Iwetter/EEG32/prefab-20261001/EEG32-2.1-schematics.pdf

1 | 2 | 3 | 4 | 5 | 6 | 7 | 8

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
### F Date: 2026-10-01

KiCad E.D.A. 10.0.5 | Id: 1/9
Size: A3 | Rev: 2.1-prefab-bench

## Title: EEG32 passive | system overview

### File: EEG32.kicad_sch

### Sheet: /

### Passive bench prototype | protection and footprint release review pending

## ADS1299 #2 / U201

CH09-CH16 / AFE2.kicad_sch

Shared clock / START Clock + BIAS master | nRF52832 / BLE
Four CS / DOUT / DRDY groups Shared SCLK / MOSI / START Latest MCU pin assignments kept BLE RF network retained MCU.kicad_sch P2: VBAT U2: +3V3 digital U3: +5VA analog Common GND, four-layer PCB

Power.kicad_sch CH25-CH32 / AFE4.kicad_sch

# EEG32 / PASSIVE WEARABLE ACQUISITION

### 32 simultaneous channels | shared REF + separate BIAS | 500 SPS/channel target

## PASSIVE ELECTRODES

32 signals + REF + BIAS One physical electrode harness

J601 / 40-contact low-profile FFC

4.99k / 4.7nF input filters No electrode power or buffers PassiveInputs.kicad_sch

## ADS1299 #3 / U301

# CH17-CH24 / AFE3.kicad_sch CH01-CH08 / AFE1.kicad_sch

Shared clock / START ADS1299 #4 / U401

Shared clock / START

## ADS1299 #1 / U101

## REF / BIAS

REF -> RC -> four SRB1 pins U101 BIAS -> R634 -> electrode REF and BIAS remain separate.

ReferenceBias.kicad_sch

Arrows show functional signal flow; named nets make electrical connections. Physical cable terminates at J601. Active hub and electrode-module projects are archived reference designs, outside this passive assembly. ROUTED BENCH CHECKPOINT: manufacturing, measured performance and human-contact safety remain release gates.

## POWER

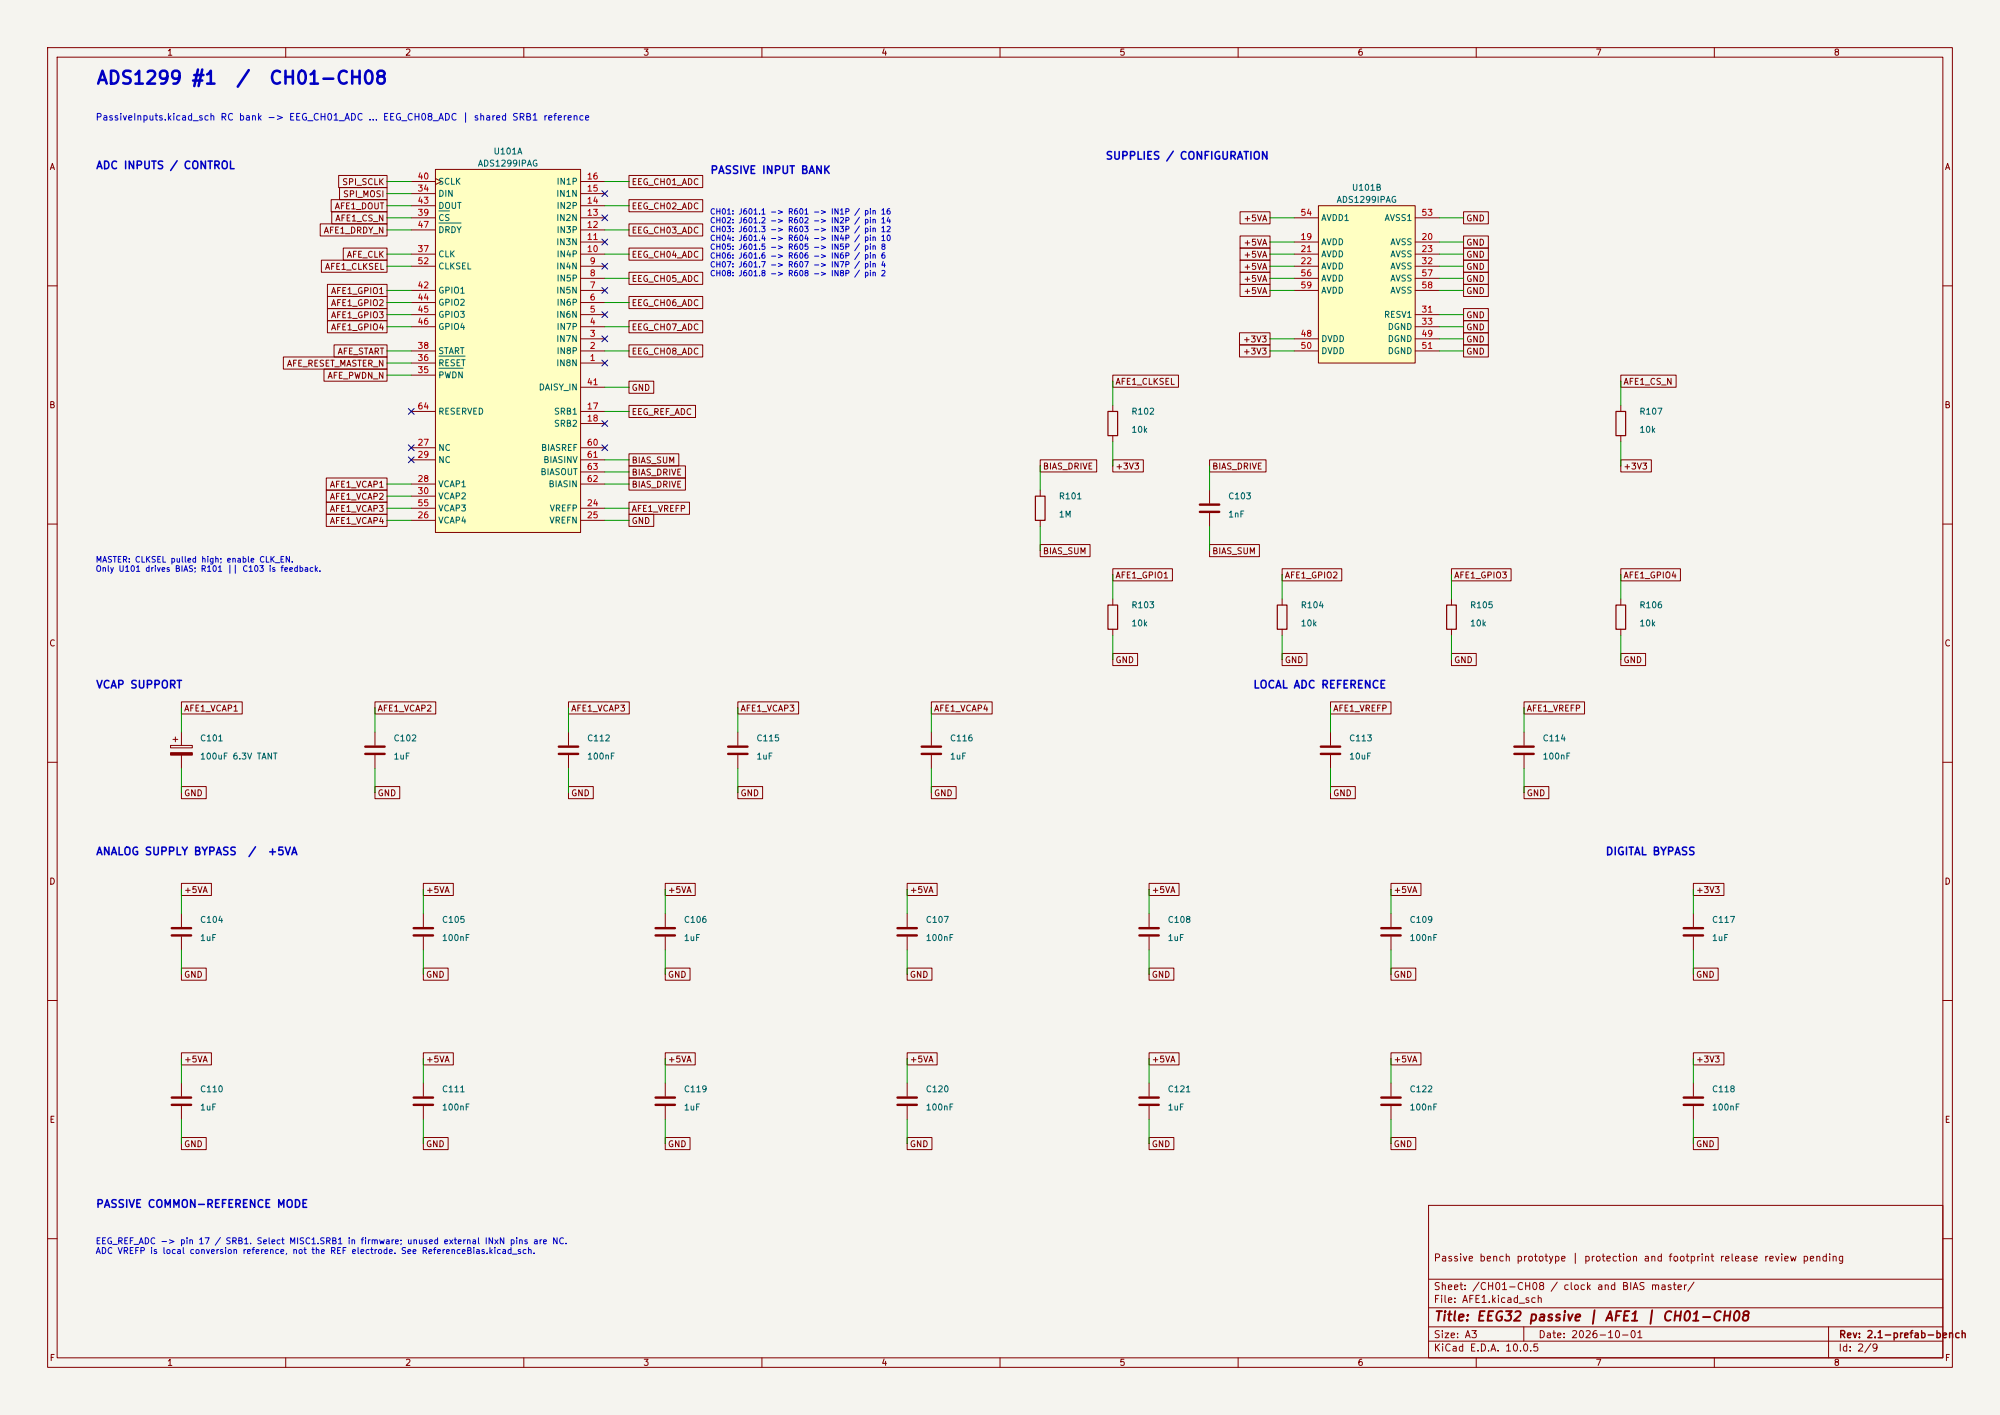
[picture p1: page 2]

MASTER: CLKSEL pulled high; enable CLK_EN. Only U101 drives BIAS; R101 || C103 is feedback. VCAP SUPPORT

EEG_REF_ADC -> pin 17 / SRB1. Select MISC1.SRB1 in firmware; unused external INxN pins are NC. ADC VREFP is local conversion reference, not the REF electrode. See ReferenceBias.kicad_sch. ANALOG SUPPLY BYPASS / +5VA

PASSIVE COMMON-REFERENCE MODE

Passive bench prototype | protection and footprint release review pending

Sheet: /CH01-CH08 / clock and BIAS master/
File: AFE1.kicad_sch
Title: EEG32 passive | AFE1 | CH01-CH08

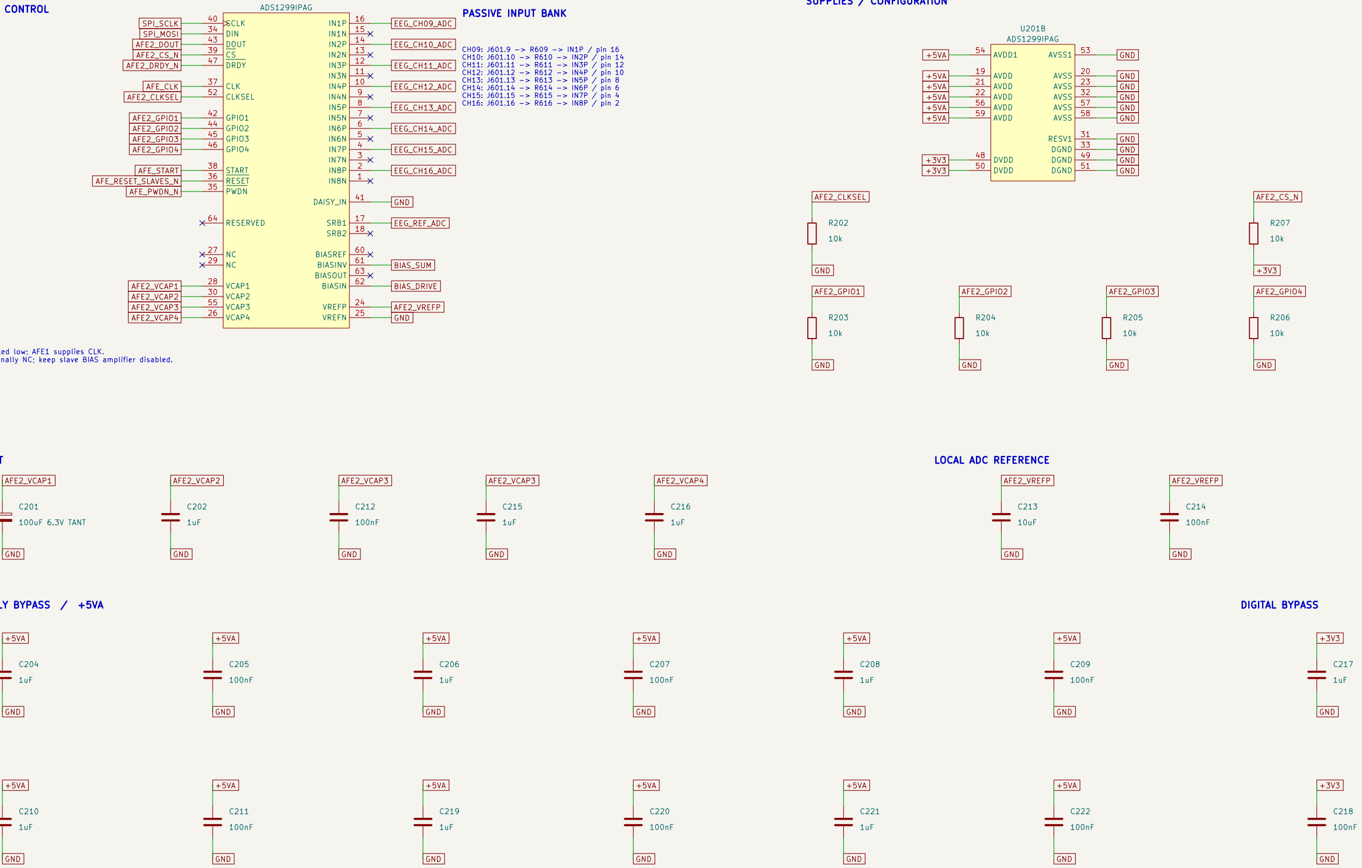
[picture p2: figure]
SRB1; SRB2; VREFP; VREFN; 25 VCAP4 26; VCAP1 28; VCAP2 30; DIN 34; PWDN 35; RESET 36; CLK 37; START 38; SCLK 40; DAISY_IN; 41 GPIO1 42; DOUT 43; GPIO2 44; GPIO3 45; GPIO4 46; DRDY 47; CLKSEL 52; ADS1299IPAG; AVDD 19; AVSS; AVDD 21; AVDD 22; 23 RESV1; 32 DGND; 33 DVDD 48; DGND; 49 DVDD 50; AVSS1; 53 AVDD1 54; AVDD 56; 58 AVDD 59; 100uF 6.3V TANT; 10k GND; GND; AFE2_VCAP2GND +5VA GND +5VA GND; +5VA GND +5VA; AFE2_VREFP; +5VA BIAS_DRIVE; EEG_REF_ADC; BIAS_SUM; GND +5VA; AFE2_VCAP4; AFE2_VCAP1 AFE2_VCAP2 AFE2_VCAP3; AFE2_CLKSEL; GND +3V3 GND; AFE2_VCAP4 +5VA; +5VA GND; AFE2_VCAP3; GND GND +5VA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
## Title: EEG32 passive | AFE2 | CH09-CH16

### File: AFE2.kicad_sch

### Sheet: /CH09-CH16 / synchronous AFE/

### Passive bench prototype | protection and footprint release review pending

IN4P | 10 IN3N | 11 IN3P | 12 IN2N | 13 IN2P | 14 IN1N | 15 IN1P | 16
VCAP3 55 | BIASREF | 60 BIASINV | 61 BIASIN | 62 BIASOUT | 63 RESERVED 64 | U201A
AFE2_VCAP1 | +3V3 ANALOG SUPPLY BYPASS / +5VA

SLAVE: CLKSEL pulled low; AFE1 supplies CLK. BIASOUT is intentionally NC; keep slave BIAS amplifier disabled. VCAP SUPPORT

# ADS1299 #2 / CH09-CH16

PassiveInputs.kicad_sch RC bank -> EEG_CH09_ADC ... EEG_CH16_ADC | shared SRB1 reference ADC INPUTS / CONTROL

### SUPPLIES / CONFIGURATION

EEG_REF_ADC -> pin 17 / SRB1. Select MISC1.SRB1 in firmware; unused external INxN pins are NC. ADC VREFP is local conversion reference, not the REF electrode. See ReferenceBias.kicad_sch. PASSIVE COMMON-REFERENCE MODE

CH09: J601.9 -> R609 -> IN1P / pin 16 CH10: J601.10 -> R610 -> IN2P / pin 14 CH11: J601.11 -> R611 -> IN3P / pin 12 CH12: J601.12 -> R612 -> IN4P / pin 10 CH13: J601.13 -> R613 -> IN5P / pin 8 CH14: J601.14 -> R614 -> IN6P / pin 6 CH15: J601.15 -> R615 -> IN7P / pin 4 CH16: J601.16 -> R616 -> IN8P / pin 2 PASSIVE INPUT BANK

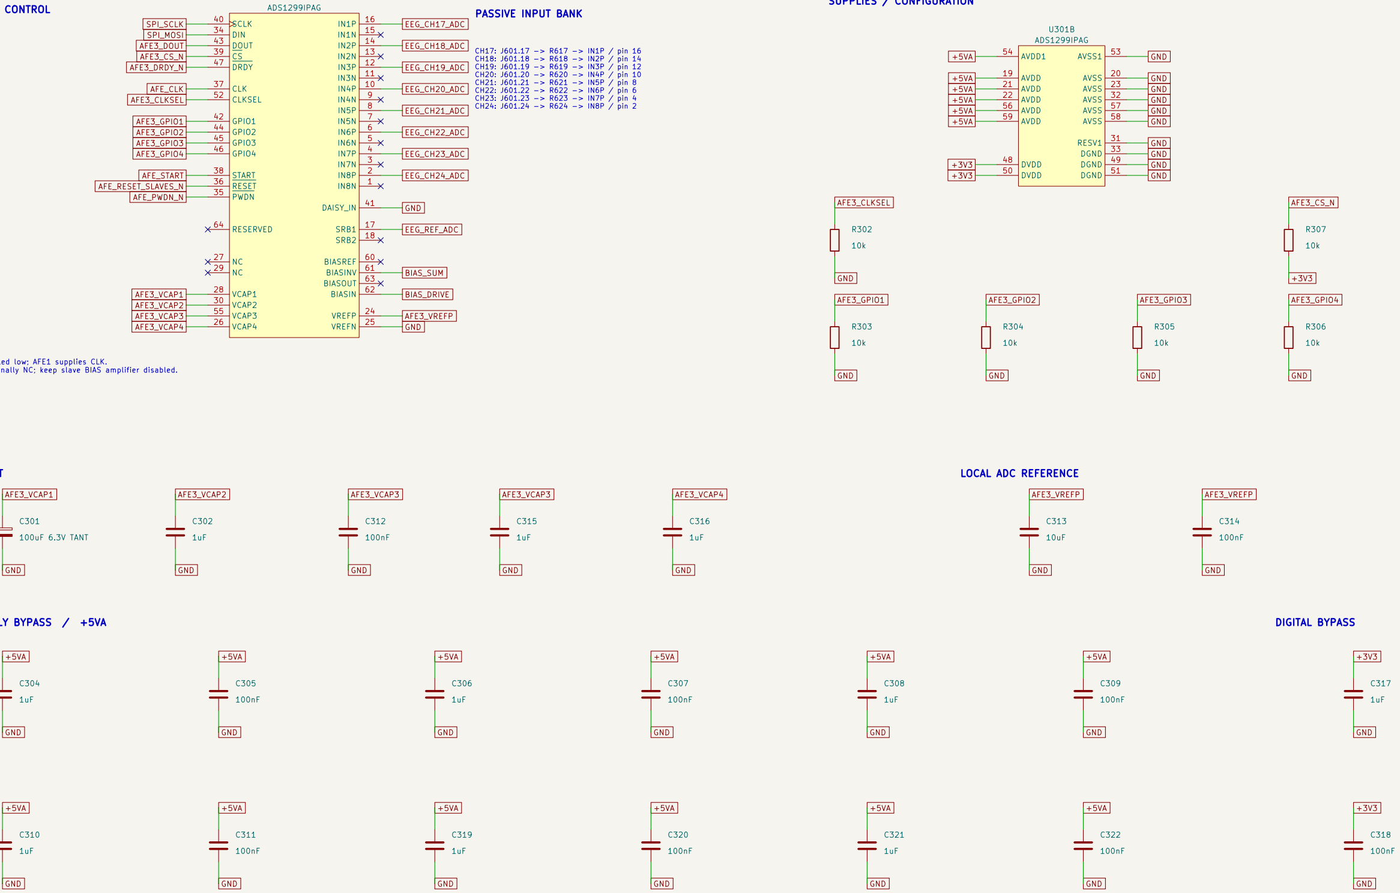
[picture p3: figure]
SRB1; SRB2; VREFP; VREFN; 25 VCAP4 26; VCAP1 28; VCAP2 30; DIN 34; PWDN 35; RESET 36; CLK 37; START 38; SCLK 40; DAISY_IN; 41 GPIO1 42; DOUT 43; GPIO2 44; GPIO3 45; GPIO4 46; DRDY 47; CLKSEL 52; ADS1299IPAG; AVDD 19; AVSS; AVDD 21; AVDD 22; 23 RESV1; 32 DGND; 33 DVDD 48; DGND; 49 DVDD 50; AVSS1; 53 AVDD1 54; AVDD 56; 58 AVDD 59; 100uF 6.3V TANT; SPI_MOSI; +5VA +5VA +3V3 +3V3 +5VA GND; AFE3_GPIO2 GND; GND; AFE3_GPIO1; AFE3_CLKSEL; AFE_PWDN_N; AFE_RESET_SLAVES_N; AFE_CLK; AFE3_DRDY_N; +3V3 GND +5VA; GND +3V3 GND; +5VA GND; AFE3_VREFP; GND +5VA; GND +5VA +5VA GND; EEG_CH24_ADC; EEG_CH23_ADC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
## Title: EEG32 passive | AFE3 | CH17-CH24

### File: AFE3.kicad_sch

### Sheet: /CH17-CH24 / synchronous AFE/

### Passive bench prototype | protection and footprint release review pending

IN4P | 10 IN3N | 11 IN3P | 12 IN2N | 13 IN2P | 14 IN1N | 15 IN1P | 16
VCAP3 55 | BIASREF | 60 BIASINV | 61 BIASIN | 62 BIASOUT | 63 RESERVED 64 | U301A
PassiveInputs.kicad_sch RC bank -> EEG_CH17_ADC ... EEG_CH24_ADC | shared SRB1 reference ADC INPUTS / CONTROL

### PASSIVE COMMON-REFERENCE MODE

EEG_REF_ADC -> pin 17 / SRB1. Select MISC1.SRB1 in firmware; unused external INxN pins are NC. ADC VREFP is local conversion reference, not the REF electrode. See ReferenceBias.kicad_sch.

# ADS1299 #3 / CH17-CH24

### VCAP SUPPORT

### SUPPLIES / CONFIGURATION

CH17: J601.17 -> R617 -> IN1P / pin 16 CH18: J601.18 -> R618 -> IN2P / pin 14 CH19: J601.19 -> R619 -> IN3P / pin 12 CH20: J601.20 -> R620 -> IN4P / pin 10 CH21: J601.21 -> R621 -> IN5P / pin 8 CH22: J601.22 -> R622 -> IN6P / pin 6 CH23: J601.23 -> R623 -> IN7P / pin 4 CH24: J601.24 -> R624 -> IN8P / pin 2 | DIGITAL BYPASS

SLAVE: CLKSEL pulled low; AFE1 supplies CLK. BIASOUT is intentionally NC; keep slave BIAS amplifier disabled. ANALOG SUPPLY BYPASS / +5VA

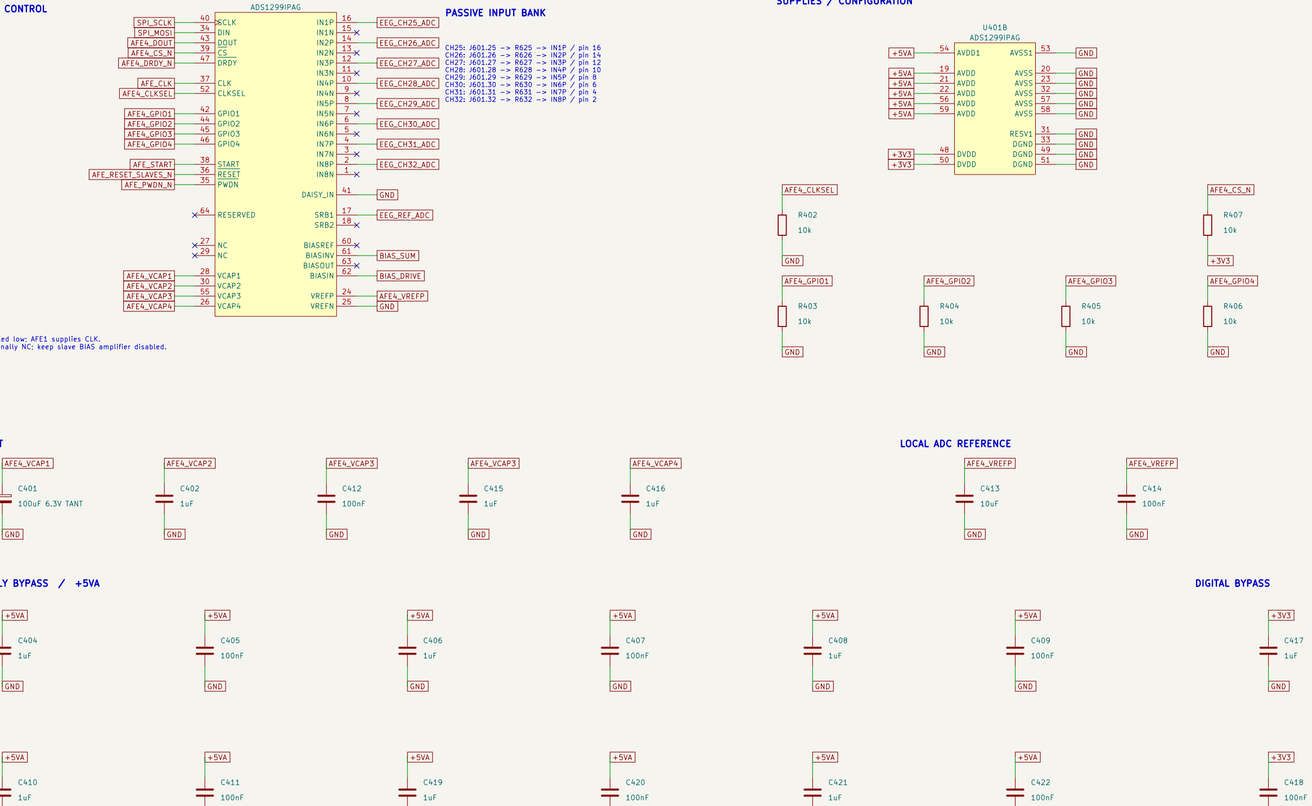
[picture p4: figure]
SRB1; SRB2; VREFP; VREFN; 25 VCAP4 26; VCAP1 28; VCAP2 30; DIN 34; PWDN 35; RESET 36; CLK 37; START 38; SCLK 40; DAISY_IN; 41 GPIO1 42; DOUT 43; GPIO2 44; GPIO3 45; GPIO4 46; DRDY 47; CLKSEL 52; ADS1299IPAG; 100uF 6.3V TANT; AVDD 19; AVSS; AVDD 21; AVDD 22; 23 RESV1; 32 DGND; 33 DVDD 48; DGND; 49 DVDD 50; AVSS1; 53 AVDD1 54; AVDD 56; 58 AVDD 59; AFE4_VCAP4; GND +5VA GND; EEG_REF_ADC; AFE4_VCAP4 +5VAGND; BIAS_SUM; AFE4_VCAP1; AFE4_VCAP2; GND; AFE4_VCAP3; AFE4_VREFP; BIAS_DRIVE; AFE4_GPIO3; AFE4_CS_N +5VA; +3V3 GND; GND +5VA; GND GND +5VA; GND GND GND; AFE4_GPIO4; AFE4_GPIO2; SPI_SCLK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
## Title: EEG32 passive | AFE4 | CH25-CH32

### File: AFE4.kicad_sch

### Sheet: /CH25-CH32 / synchronous AFE/

### Passive bench prototype | protection and footprint release review pending

IN4P | 10 IN3N | 11 IN3P | 12 IN2N | 13 IN2P | 14 IN1N | 15 IN1P | 16
VCAP3 55 | BIASREF | 60 BIASINV | 61 BIASIN | 62 BIASOUT | 63 RESERVED 64 | U401A

GND

GND

GND

GND | GND

GND

GND

### PASSIVE COMMON-REFERENCE MODE

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

# ADS1299 #4 / CH25-CH32

PassiveInputs.kicad_sch RC bank -> EEG_CH25_ADC ... EEG_CH32_ADC | shared SRB1 reference ADC INPUTS / CONTROL | PASSIVE INPUT BANK
SLAVE: CLKSEL pulled low; AFE1 supplies CLK. BIASOUT is intentionally NC; keep slave BIAS amplifier disabled. | DIGITAL BYPASS

### SUPPLIES / CONFIGURATION

### VCAP SUPPORT

CH25: J601.25 -> R625 -> IN1P / pin 16 CH26: J601.26 -> R626 -> IN2P / pin 14 CH27: J601.27 -> R627 -> IN3P / pin 12 CH28: J601.28 -> R628 -> IN4P / pin 10 CH29: J601.29 -> R629 -> IN5P / pin 8 CH30: J601.30 -> R630 -> IN6P / pin 6 CH31: J601.31 -> R631 -> IN7P / pin 4 CH32: J601.32 -> R632 -> IN8P / pin 2 ANALOG SUPPLY BYPASS / +5VA

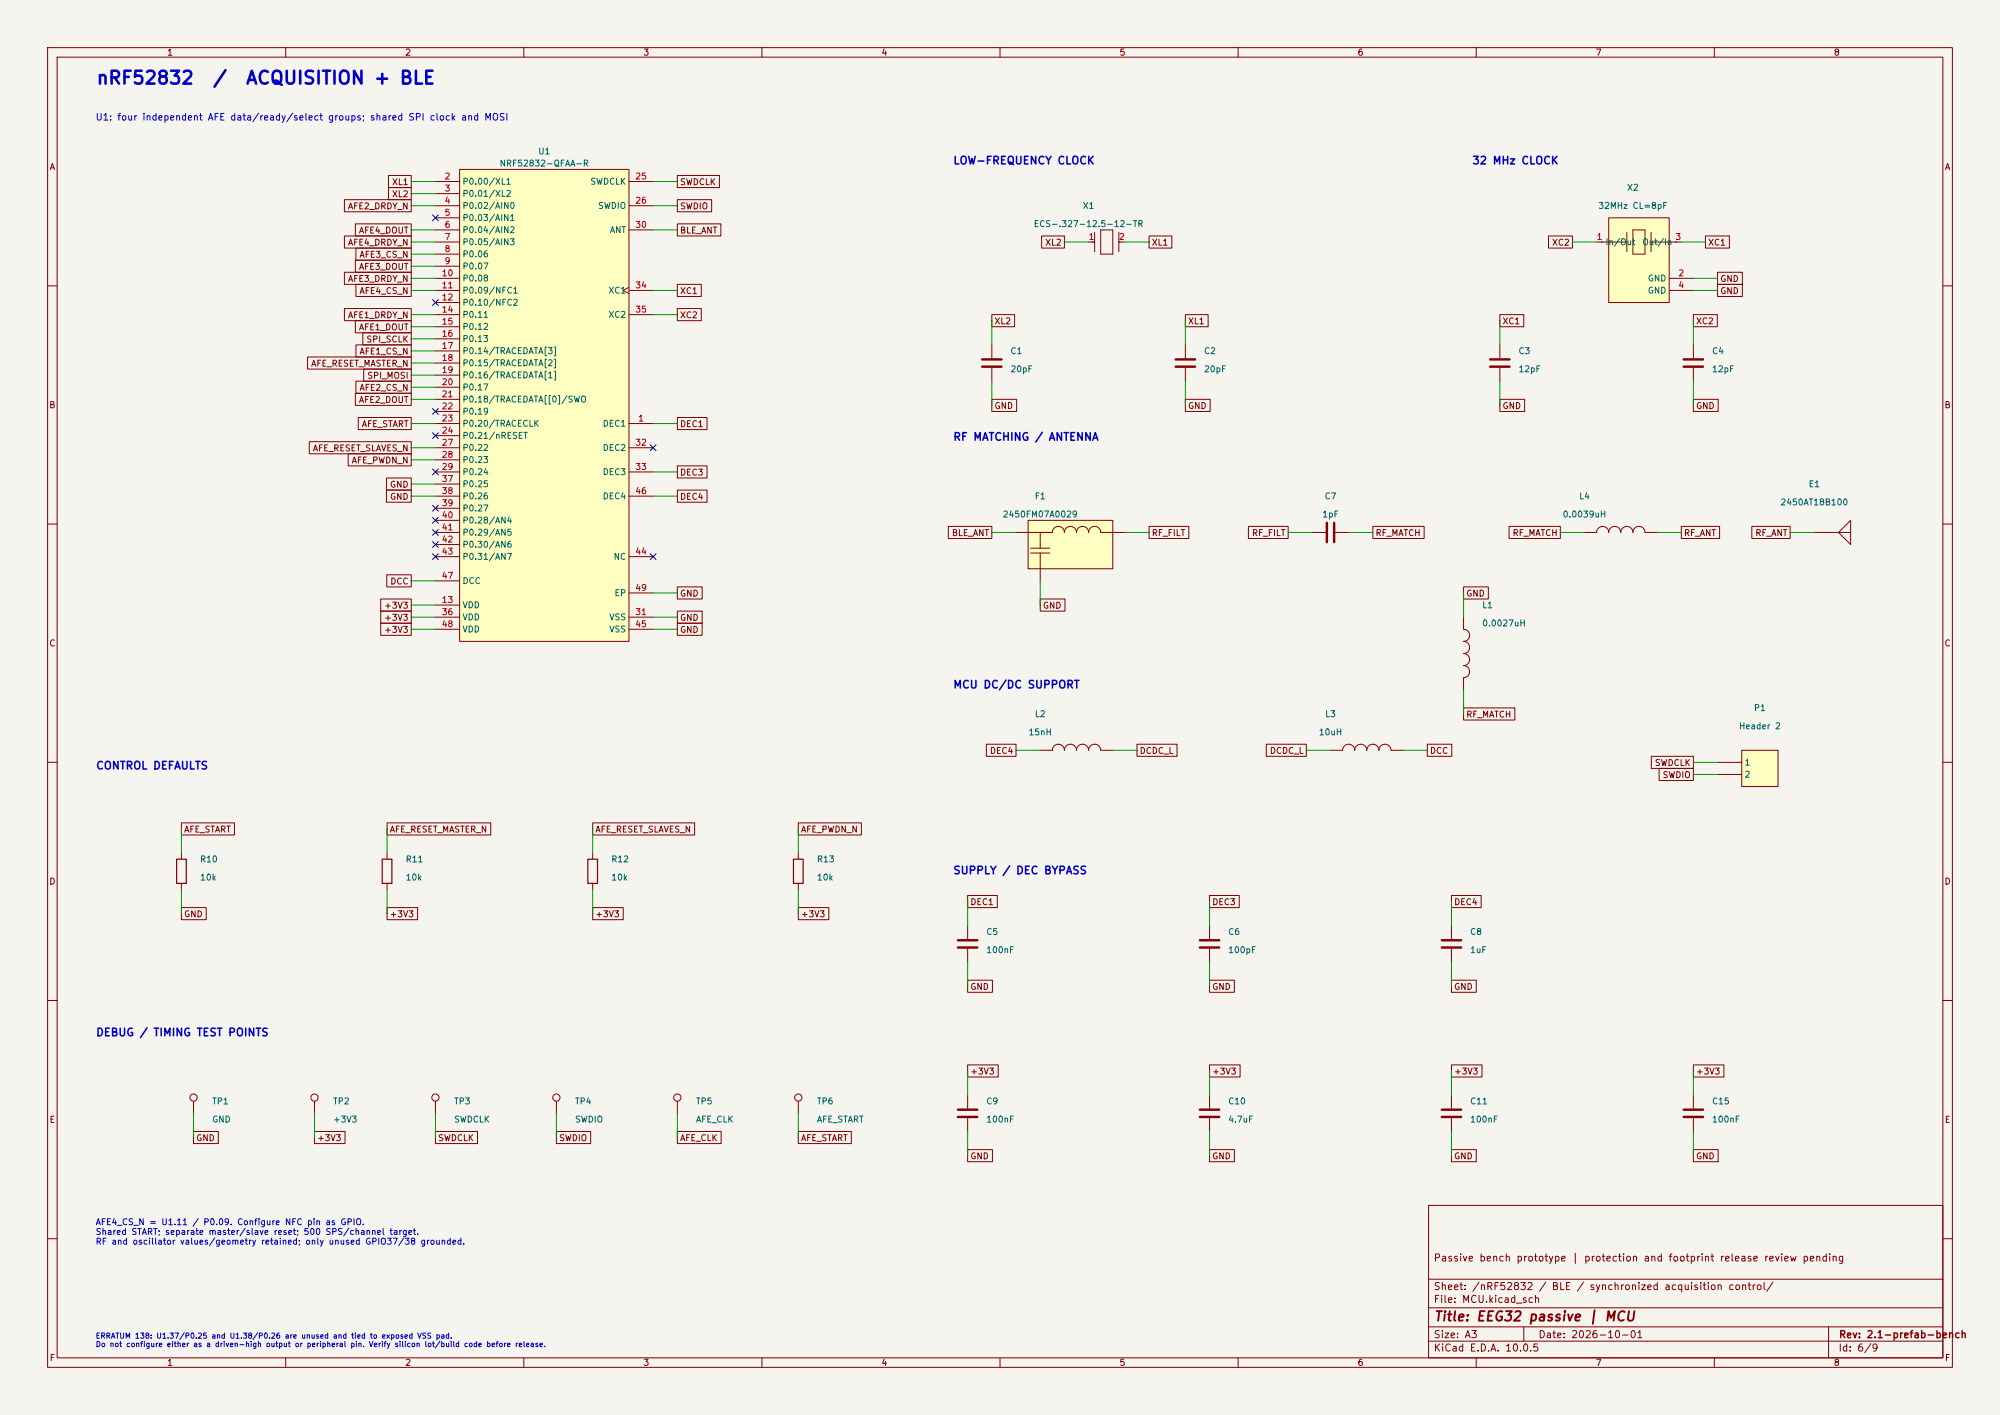
[picture p5: page 6]

U1: four independent AFE data/ready/select groups; shared SPI clock and MOSI

MCU DC/DC SUPPORT

DEBUG / TIMING TEST POINTS

Passive bench prototype | protection and footprint release review pending

Sheet: /nRF52832 / BLE / synchronized acquisition control/
File: MCU.kicad_sch
Title: EEG32 passive | MCU

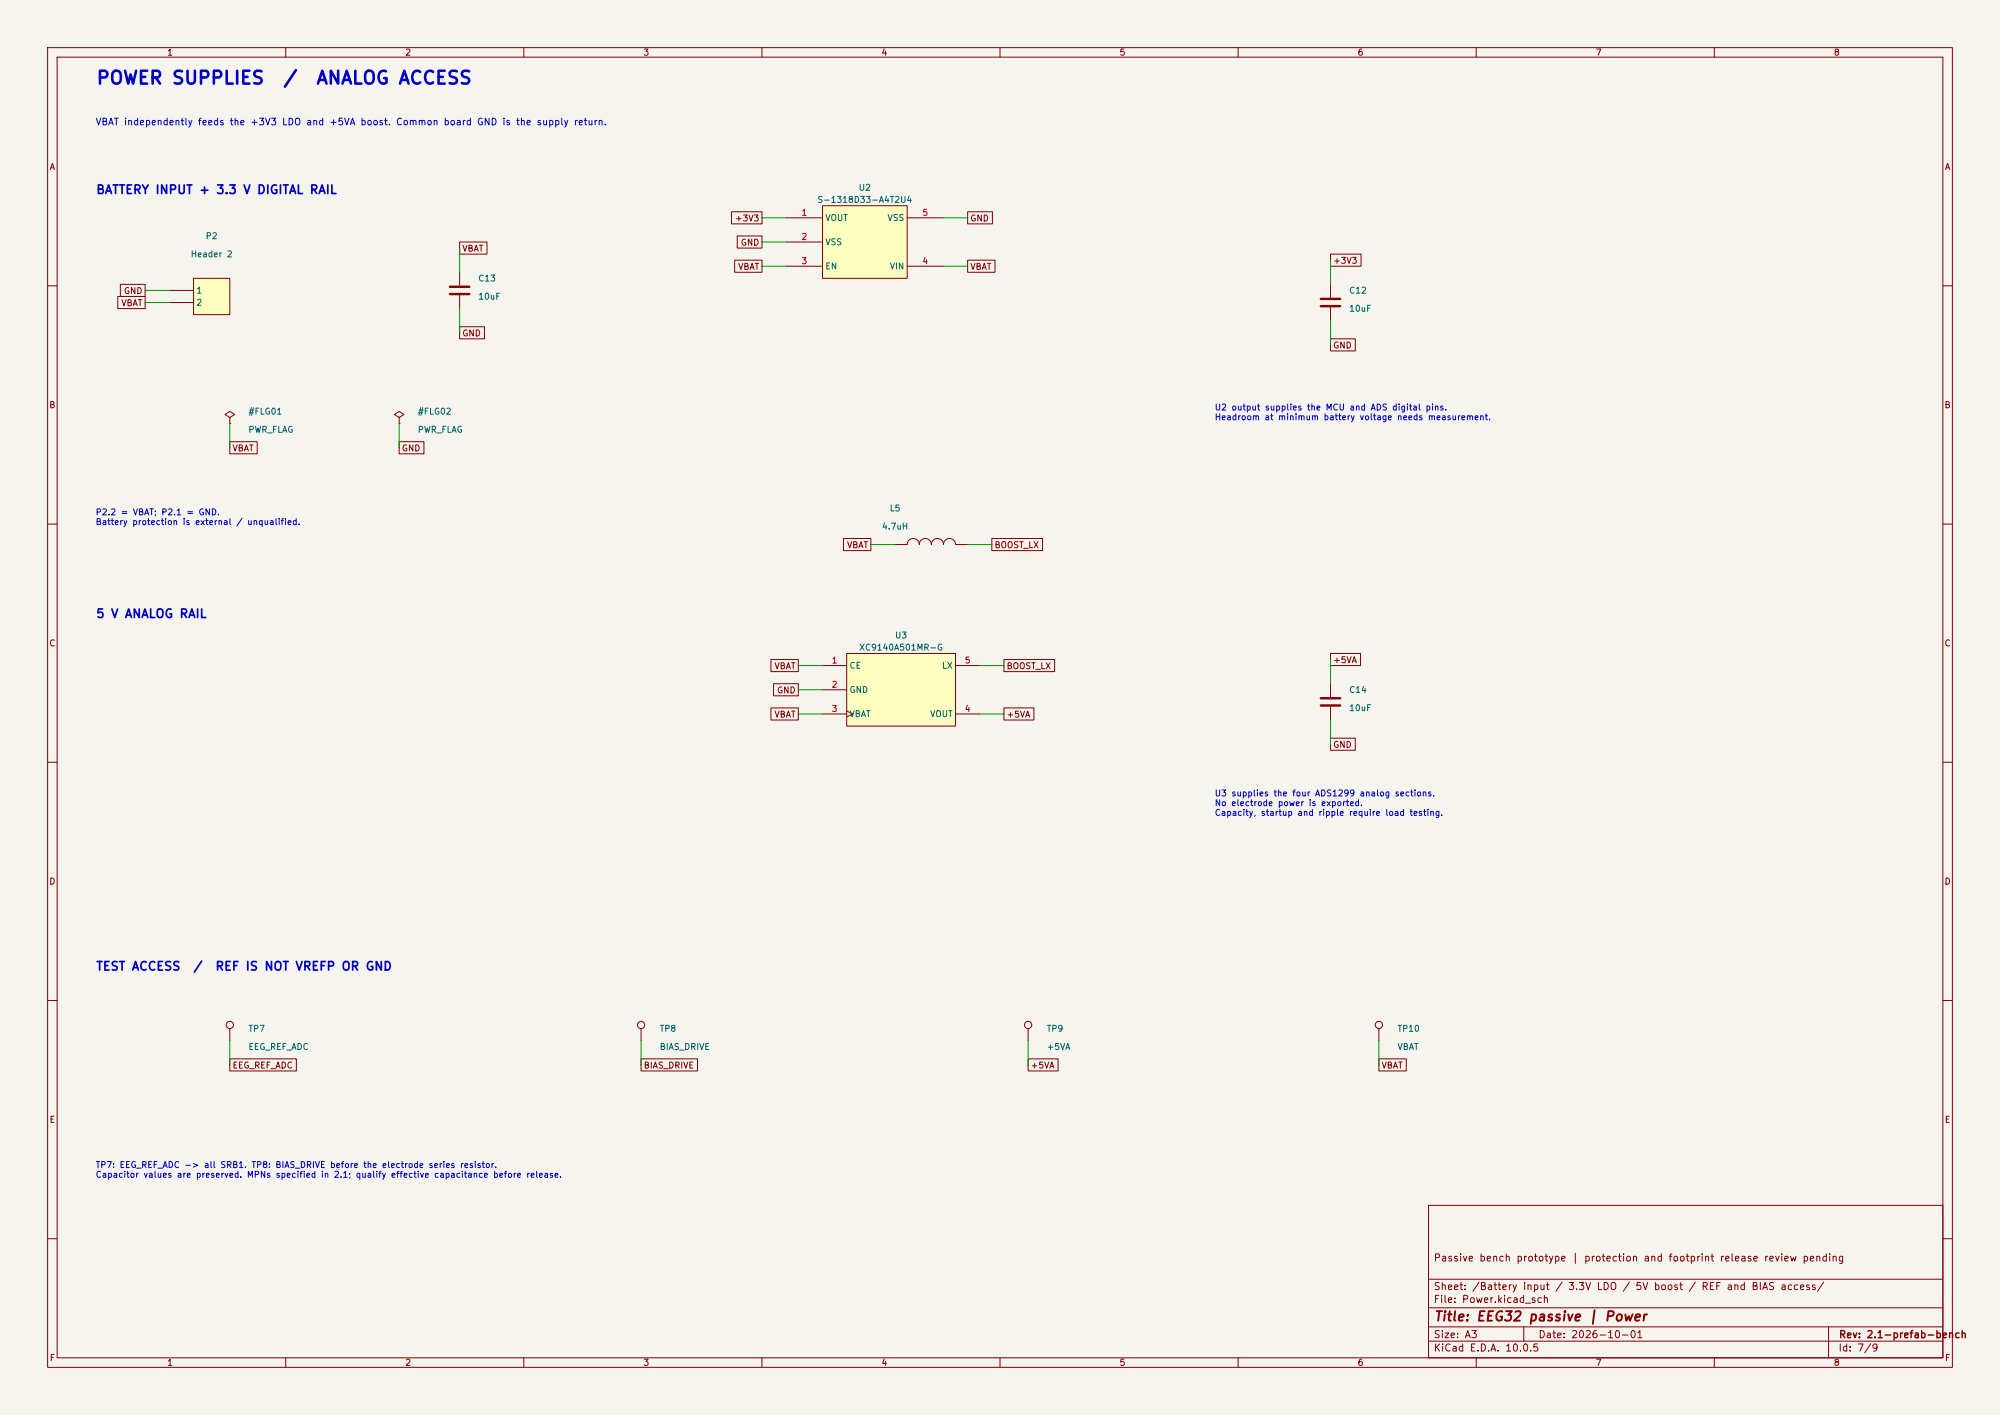
[picture p6: page 7]

VBAT independently feeds the +3V3 LDO and +5VA boost. Common board GND is the supply return. POWER SUPPLIES / ANALOG ACCESS

BATTERY INPUT + 3.3 V DIGITAL RAIL

U2 output supplies the MCU and ADS digital pins. Headroom at minimum battery voltage needs measurement.

P2.2 = VBAT; P2.1 = GND. Battery protection is external / unqualified.

U3 supplies the four ADS1299 analog sections. No electrode power is exported.

Capacity, startup and ripple require load testing.

TEST ACCESS / REF IS NOT VREFP OR GND

TP7: EEG_REF_ADC -> all SRB1. TP8: BIAS_DRIVE before the electrode series resistor. Capacitor values are preserved. MPNs specified in 2.1; qualify effective capacitance before release.

Passive bench prototype | protection and footprint release review pending

Sheet: /Battery input / 3.3V LDO / 5V boost / REF and BIAS access/
File: Power.kicad_sch
Title: EEG32 passive | Power

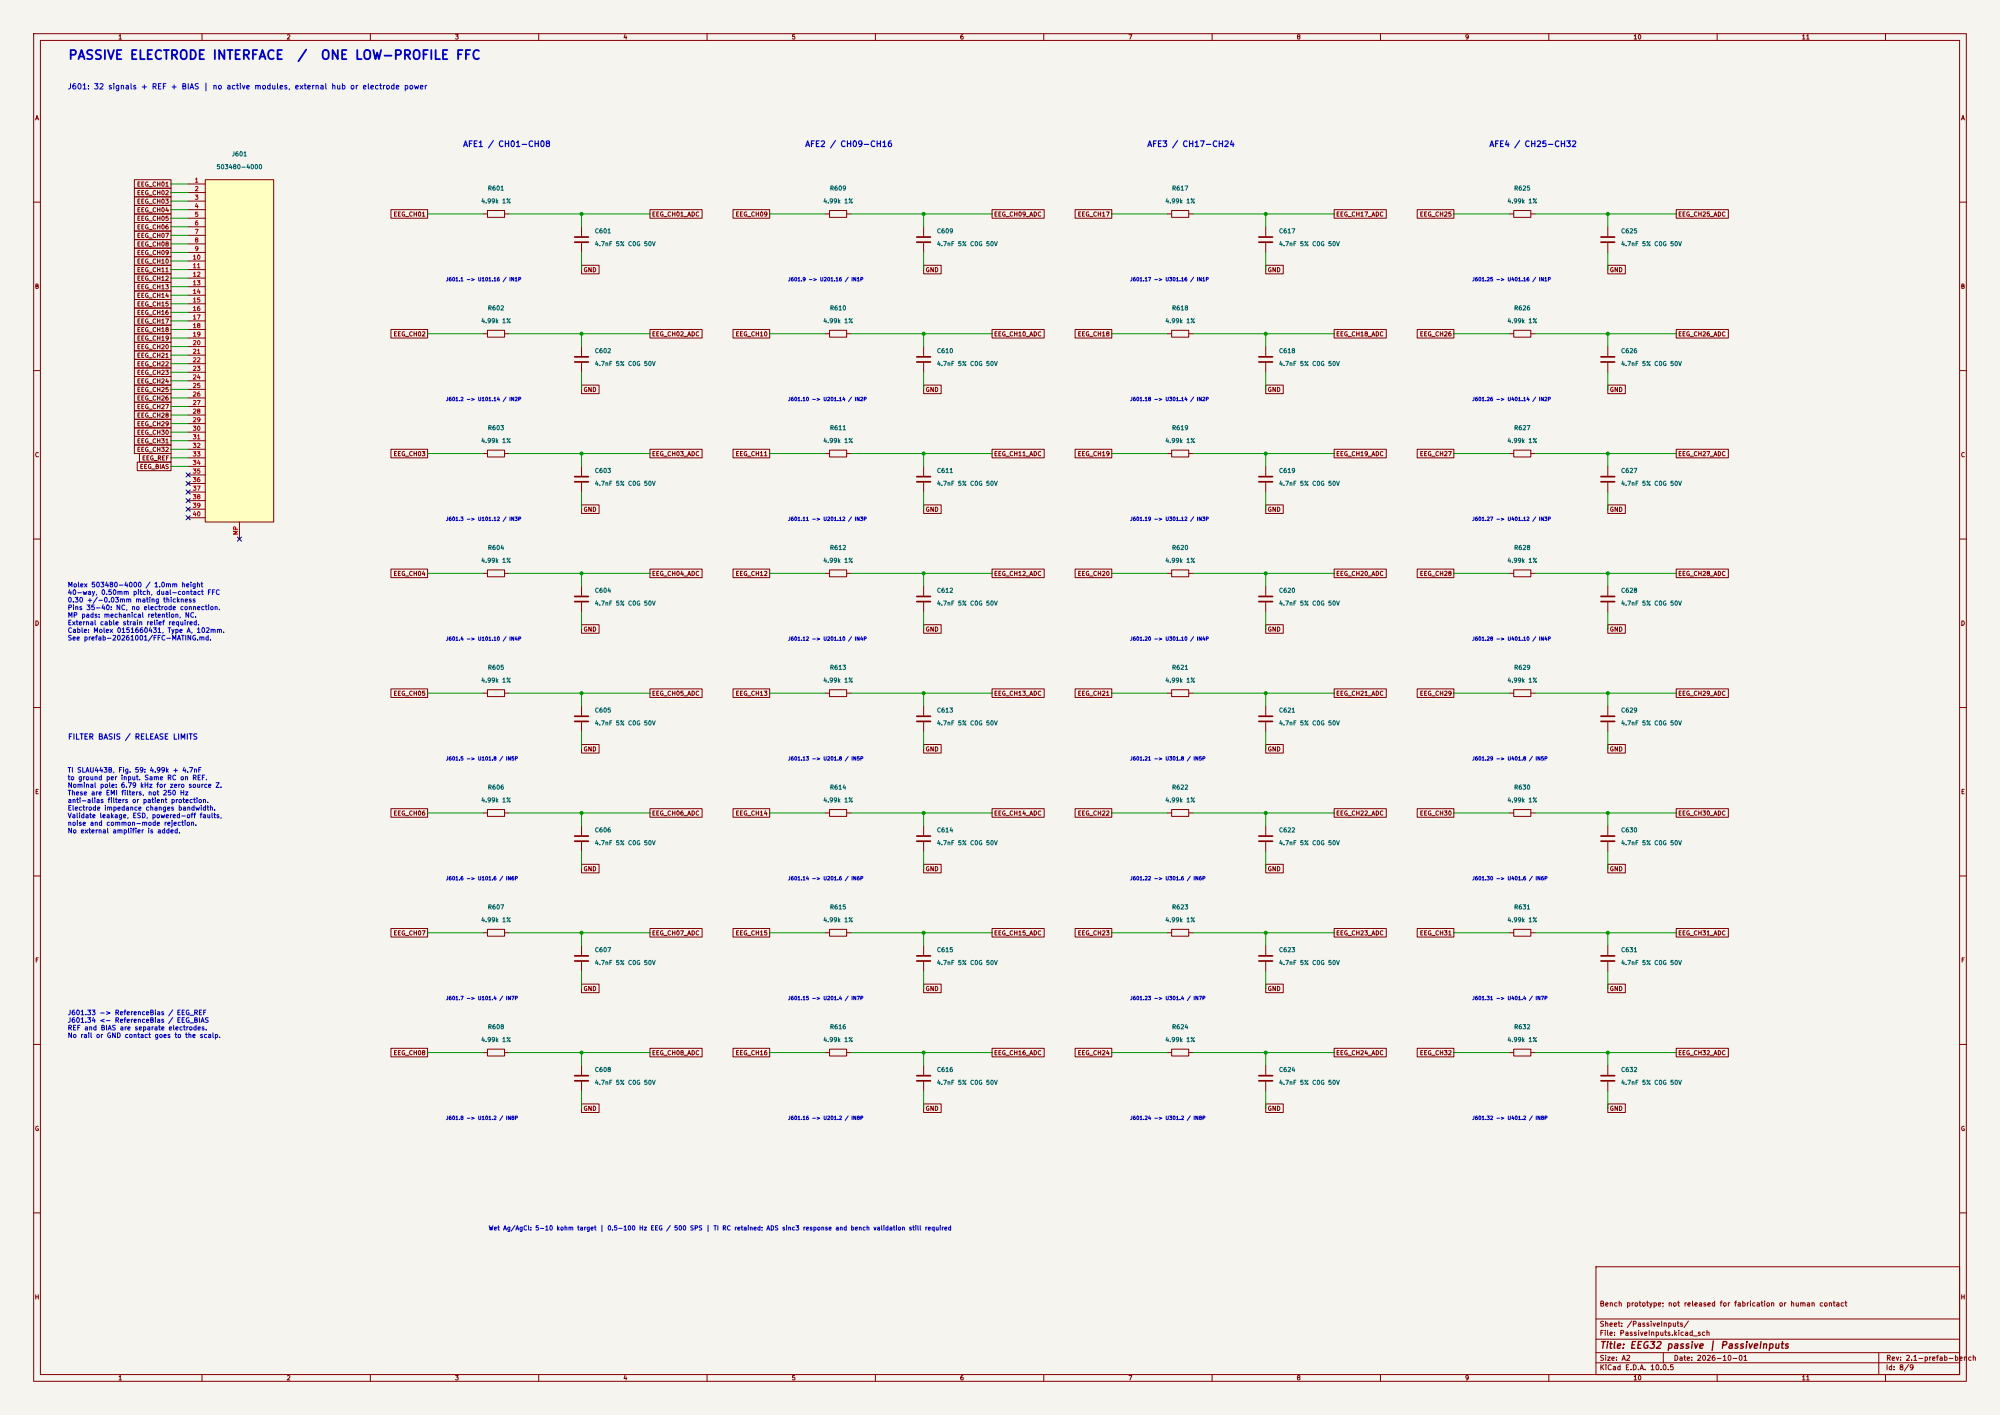
[picture p7: page 8]

J601.3 -> U101.12 / IN3P PASSIVE ELECTRODE INTERFACE / ONE LOW-PROFILE FFC

J601: 32 signals + REF + BIAS | no active modules, external hub or electrode power Molex 503480-4000 / 1.0mm height

40-way, 0.50mm pitch, dual-contact FFC
0.30 +/-0.03mm mating thickness Pins 35-40: NC, no electrode connection. MP pads: mechanical retention, NC. External cable strain relief required. Cable: Molex 0151660431, Type A, 102mm. See prefab-20261001/FFC-MATING.md.

FILTER BASIS / RELEASE LIMITS

TI SLAU443B, Fig. 59: 4.99k + 4.7nF
to ground per input. Same RC on REF. Nominal pole: 6.79 kHz for zero source Z. These are EMI filters, not 250 Hz anti-alias filters or patient protection. Electrode impedance changes bandwidth. Validate leakage, ESD, powered-off faults, noise and common-mode rejection. No external amplifier is added. J601.33 -> ReferenceBias / EEG_REF

J601.34 <- ReferenceBias / EEG_BIAS REF and BIAS are separate electrodes. No rail or GND contact goes to the scalp.

Bench prototype; not released for fabrication or human contact R632

Wet Ag/AgCl: 5-10 kohm target | 0.5-100 Hz EEG / 500 SPS | TI RC retained; ADS sinc3 response and bench validation still required

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
## Title: EEG32 passive | ReferenceBias

### File: ReferenceBias.kicad_sch

### Sheet: /ReferenceBias/

### Bench prototype; not released for fabrication or human contact

R633

4.99k 1%

R634

4.99k 1%

C633

4.7nF 5% C0G 50V EEG_REF | GND

EEG_REF_ADC

BIAS_DRIVE | EEG_BIAS SHARED REF / SEPARATE BIAS

Passive common-reference montage. No local electrode buffers; no REF/BIAS short. Unbuffered shared REF retained: validate aggregate input loading and lead-off configuration for 32 channels. One common REF filter; do not add 32 parallel filter capacitors to this electrode. TI EVM default directly selects REF_ELEC to SRB1 (JP8); its optional buffer is not populated here. J601.33 / passive REF

U101/U201/U301/U401: pin 17 / SRB1 MISC1.SRB1 = 1; SRB2 remains unused. TP7 measures the filtered shared reference. J601.34 / separate BIAS electrode 4.99k is TI EVM R10 value; it is not a validated patient-current limiter. U101 BIASOUT, pin 63

Existing 1M || 1nF feedback

### remains before R634. FIRMWARE + VALIDATION

Enable only U101 BIAS amplifier; slave BIASOUT pins remain NC. Preserve shared BIAS_SUM and BIASIN. Select BIAS sense channels deliberately. Validate stability with electrode/cable impedance and disconnect faults. At +5VA, internal BIASREF targets mid-supply. REF is neither GND nor the ADS VREFP conversion reference. Common clock + shared START synchronize all four devices. Configure identical 500 SPS rates. Lead-off excitation and gain/DC-offset range require bench verification with passive electrode models. PROTECTION RELEASE HOLD: RC networks reduce input current/EMI but do not establish ESD, defibrillator,

isolation, leakage or single-fault safety. No human connection until supervisor/electrical safety validation.
