Iwetter/EEG32/prefab-20261001/EEG32-2.1-schematics.png

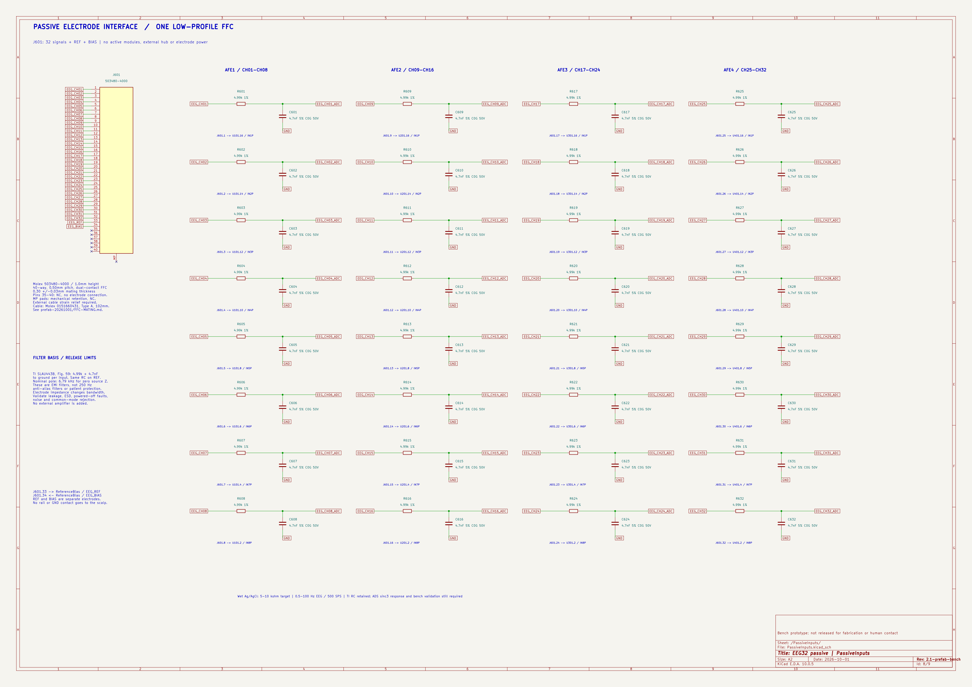
prefab-20261001/EEG32-2.1-schematics.png
