Iwetter/EEG32/prefab-20261001/BOM-QUALIFICATION.md

# BOM specification and qualification

[BOM.csv](BOM.csv) is the revision 2.1 procurement list. All 225 unique PCB references carry Manufacturer, MPN, Electrical_Spec, Datasheet and Qualification fields in the schematic and PCB. Of these, 213 are fitted components and 12 are bare PCB features (P1, P2, TP1–TP10), explicitly marked NOT PURCHASED and excluded from placement. ADS1299 multi-unit symbols count once per physical device. Native schematic BOM settings include the procurement fields.

Nominal values, package geometry and placement remain unchanged. Previously specified matching, oscillator, IC and input-filter parts were retained. Generic capacitors/resistors and the 15 nH choke now have exact ordering parts. Taiyo Yuden C5/C9 use the manufacturer's renamed MSAST105SB5104KFNA01 identity for TMK105BJ104KV-F, at the existing 100 nF/25 V/X5R/0402 specification. [Manufacturer part record](https://ds.yuden.co.jp/TYCOMPAS/ap/detail?pn=MSAST105SB5104KFNA01&u=I).

| Function / references | Exact specified part | Electrical requirement / remaining evidence |
|---|---|---|
| U2 input/output C12/C13 | Murata GRM155R61A106ME11D | 10 µF ±20%, X5R, 10 V, 0402. Demonstrate at least 1 µF **effective** capacitance across bias, tolerance, temperature and aging for the S-1318. |
| Boost output C14 | Same GRM155R61A106ME11D | Existing nominal 10 µF retained; qualify biased capacitance and ESR against XC9140 recommendation and loaded startup. |
| ADS reference C113/C213/C313/C413 | Murata GRM188R61A106KE69D | 10 µF ±10%, X5R, 10 V, 0603, between VREFP and AVSS. Verify vendor bias curve at the actual reference voltage and demonstrate reference settling/noise. TI specifies the nominal 10 µF bypass; this list does not claim 10 µF is guaranteed after bias. |
| ADS VCAP1 C101/C201/C301/C401 | KEMET T491B107K006AT | Existing polarized 100 µF ±10%, 6.3 V, B/3528; ESR ≤2 Ω at 100 kHz. Check polarity, surge and derating. |
| BIAS feedback R103 / C103 | Yageo RC0402FR-071ML / Murata GRM1555C1H102JA01D | Existing 1 MΩ ±1% and 1 nF ±5% C0G/50 V retained. Loop stability remains a bench test. |
| nRF DEC4 C8 | Murata GRM188R61A105KA61D | 1 µF ±10%, X5R, 10 V, 0603; verify biased capacitance at approximately 1.3 V. |
| nRF DC/DC L2 / L3 | Murata LQG15HS15NJ02D / LQM18DN100M70L | 15 nH ±5%, 450 mA, DCR ≤0.32 Ω / existing 10 µH ±20%, DCR 1.05 ±0.32 Ω. L3 inductance-change rating is 100 mA; temperature-rise rating is 300 mA. Do not conflate these ratings. |
| Boost L5 | Murata LQM18PN4R7MFRL | Existing 4.7 µH ±20%, DCR 0.44 Ω ±25%, SRF ≥40 MHz, 620 mA temperature-rise rating. Confirm peak current and inductance rolloff with the actual load/battery. |
| RF L1 / L4 | Murata LQW15AN2N7G8ZD / Bourns CW100505-3N9J | Existing 2.7 nH ±2% / 3.9 nH ±5%. L1 Q≥28 at 250 MHz, SRF≥14 GHz, DCR≤0.047 Ω, 1.5 A at ≤40°C temperature rise. L4 Q≥20 at 250 MHz, SRF≥5.8 GHz, DCR≤0.066 Ω, 840 mA. |
| HF / LF crystals | ECS-320-8-37CKM / ECS-.327-12.5-12-TR | 32 MHz, CL 8 pF, ±10 ppm initial / ±10 ppm stability, ESR≤60 Ω, −20…70°C; 32.768 kHz, CL 12.5 pF, ±20 ppm initial, ESR≤90 kΩ. Existing capacitors/layout unchanged. |
| FFC connector J601 | Molex 503480-4000 | 40 contacts, 0.50 mm pitch, dual contact, 0.30 ±0.03 mm mating thickness, 10 mating cycles. Cable is a separate harness item. |

Requirements derive from the manufacturers: [ABLIC S-1318](https://www.ablic.com/en/doc/datasheet/voltage_regulator/S1318_E.pdf), [TI ADS1299](https://www.ti.com/lit/ds/symlink/ads1299.pdf), [Torex XC9140](https://product.torexsemi.com/system/files/series/xc9140.pdf), [ECS HF](https://ecsxtal.com/store/pdf/ECX-1637.pdf), [ECS LF](https://ecsxtal.com/store/pdf/ECX-12.pdf), [Murata L1](https://search.murata.co.jp/Ceramy/image/img/P02/JELF243A-9138.pdf), and each BOM row's manufacturer record. Specifications define procurement targets; stock availability, lifecycle, lot authenticity and MLCC bias curves still require buyer/vendor confirmation. F1 retains the legacy 2450FM07A0029T ordering code; the [manufacturer's current global code](https://www.johansontechnology.com/products/integrated-passives/low-pass-filters/2450fm07a0029001t/) is 2450FM07A0029001T. Require supplier identity/land verification before substituting it. Some direct PDF downloads failed; [source-manifest.json](sources/source-manifest.json) records failures rather than representing them as archived evidence.

Release the MLCC choices only after obtaining exact-part vendor curves or measured capacitance at operating bias, temperature and aging limits. Derate tantalum parts for the actual rail/transients. Any failed qualification should return a concrete datasheet violation and proposed compatible correction for review. Do not replace parts merely to optimize price/stock, and do not treat a filled MPN field as completed performance qualification.
