Iwetter/EEG32/prefab-20261001/assembly-back.png

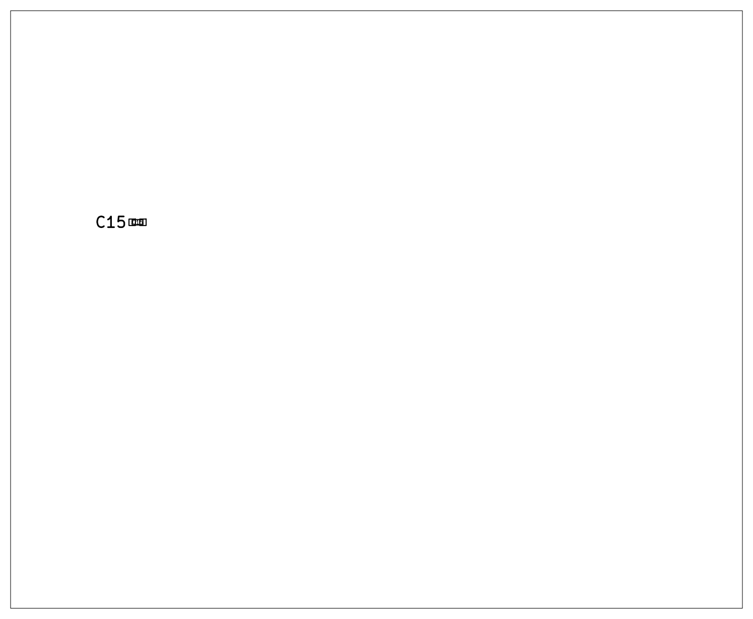
prefab-20261001/assembly-back.png
