Iwetter/EEG32/prefab-20261001/assembly-front.pdf

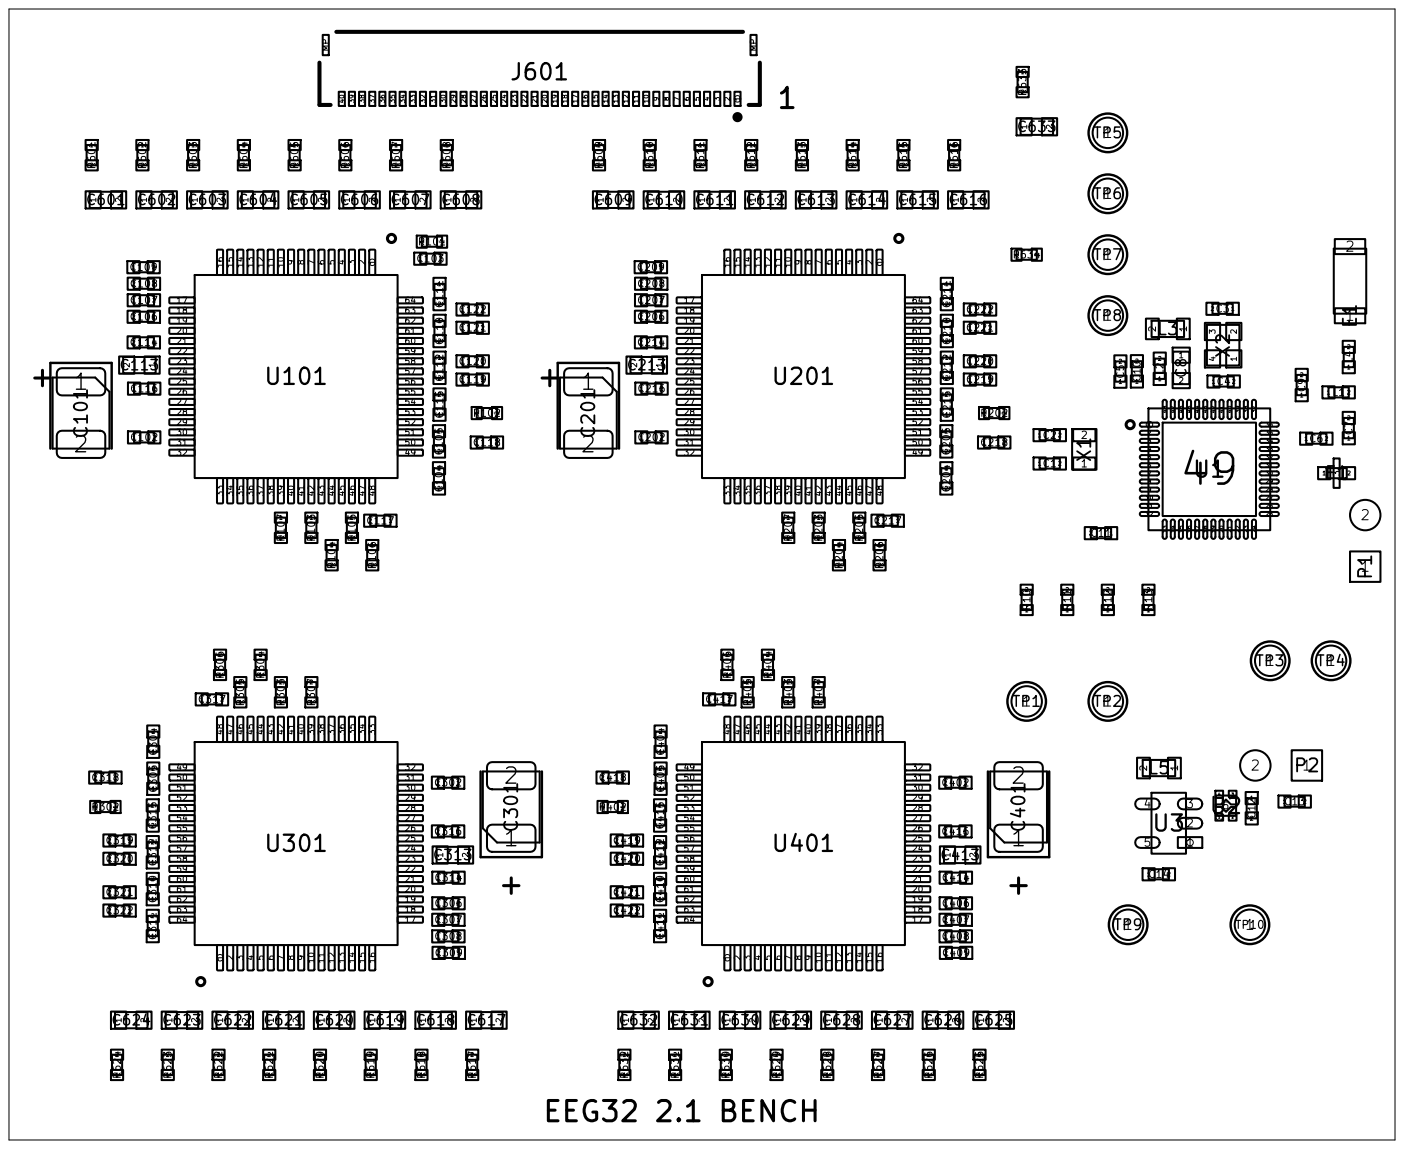
[picture p10: page 1]

4 | 33
5 | 32

10 | 27
11 | 26
