Iwetter/EEG32/EEG32.kicad_pcb

## KiCad design EEG32.kicad_pcb (2026-10-22)

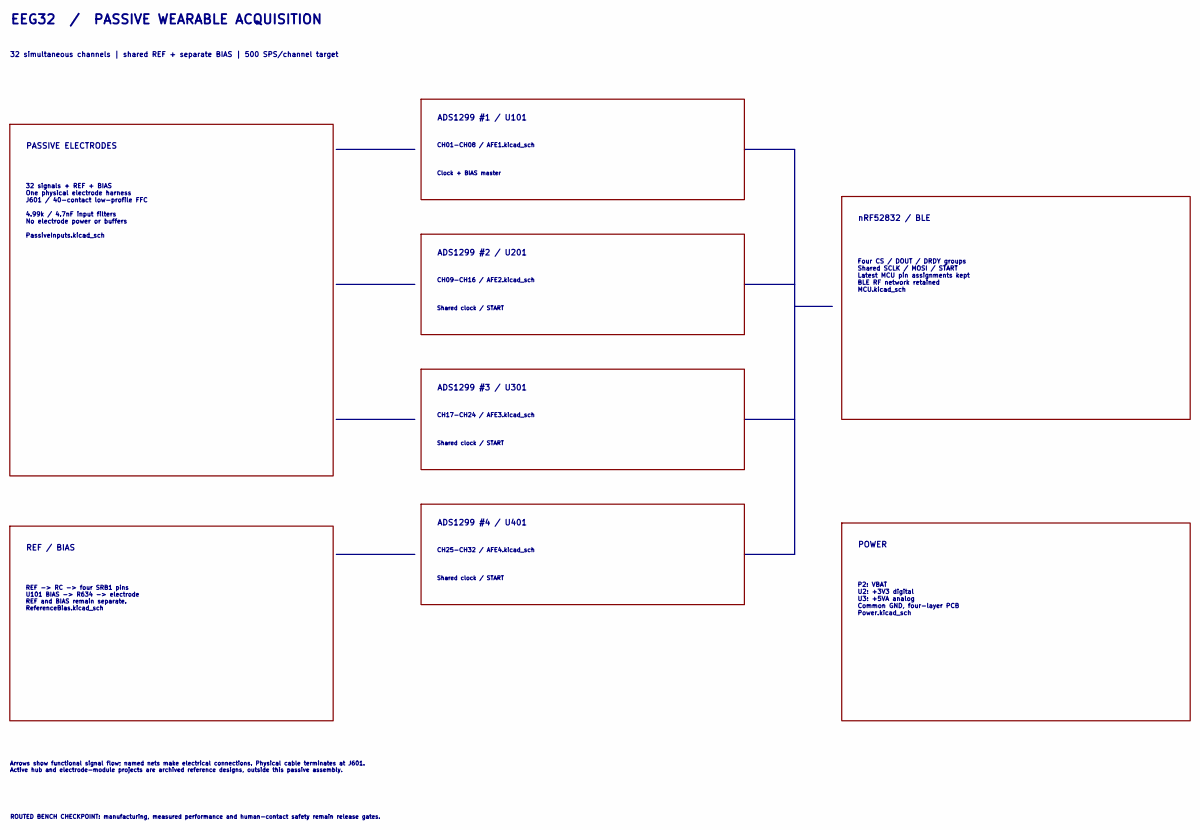
[picture p11: schematic EEG32.kicad_sch, EEG32 passive | system overview]

Notes on the sheet:
ADS1299 #4 / U401
CH25-CH32 / AFE4.kicad_sch
Shared clock / START
ADS1299 #2 / U201
CH09-CH16 / AFE2.kicad_sch
ADS1299 #3 / U301
CH17-CH24 / AFE3.kicad_sch
ADS1299 #1 / U101
CH01-CH08 / AFE1.kicad_sch
Clock + BIAS master
EEG32 / PASSIVE WEARABLE ACQUISITION
32 simultaneous channels | shared REF + separate BIAS | 500 SPS/channel target
PASSIVE ELECTRODES
32 signals + REF + BIAS One physical electrode harness J601 / 40-contact low-profile FFC 4.99k / 4.7nF input filters No electrode power or buffers PassiveInputs.kicad_sch
REF / BIAS
REF -> RC -> four SRB1 pins U101 BIAS -> R634 -> electrode REF and BIAS remain separate. ReferenceBias.kicad_sch
nRF52832 / BLE
Four CS / DOUT / DRDY groups Shared SCLK / MOSI / START Latest MCU pin assignments kept BLE RF network retained MCU.kicad_sch
POWER
P2: VBAT U2: +3V3 digital U3: +5VA analog Common GND, four-layer PCB Power.kicad_sch
Arrows show functional signal flow; named nets make electrical connections. Physical cable terminates at J601. Active hub and electrode-module projects are archived reference designs, outside this passive assembly.
ROUTED BENCH CHECKPOINT: manufacturing, measured performance and human-contact safety remain release gates.

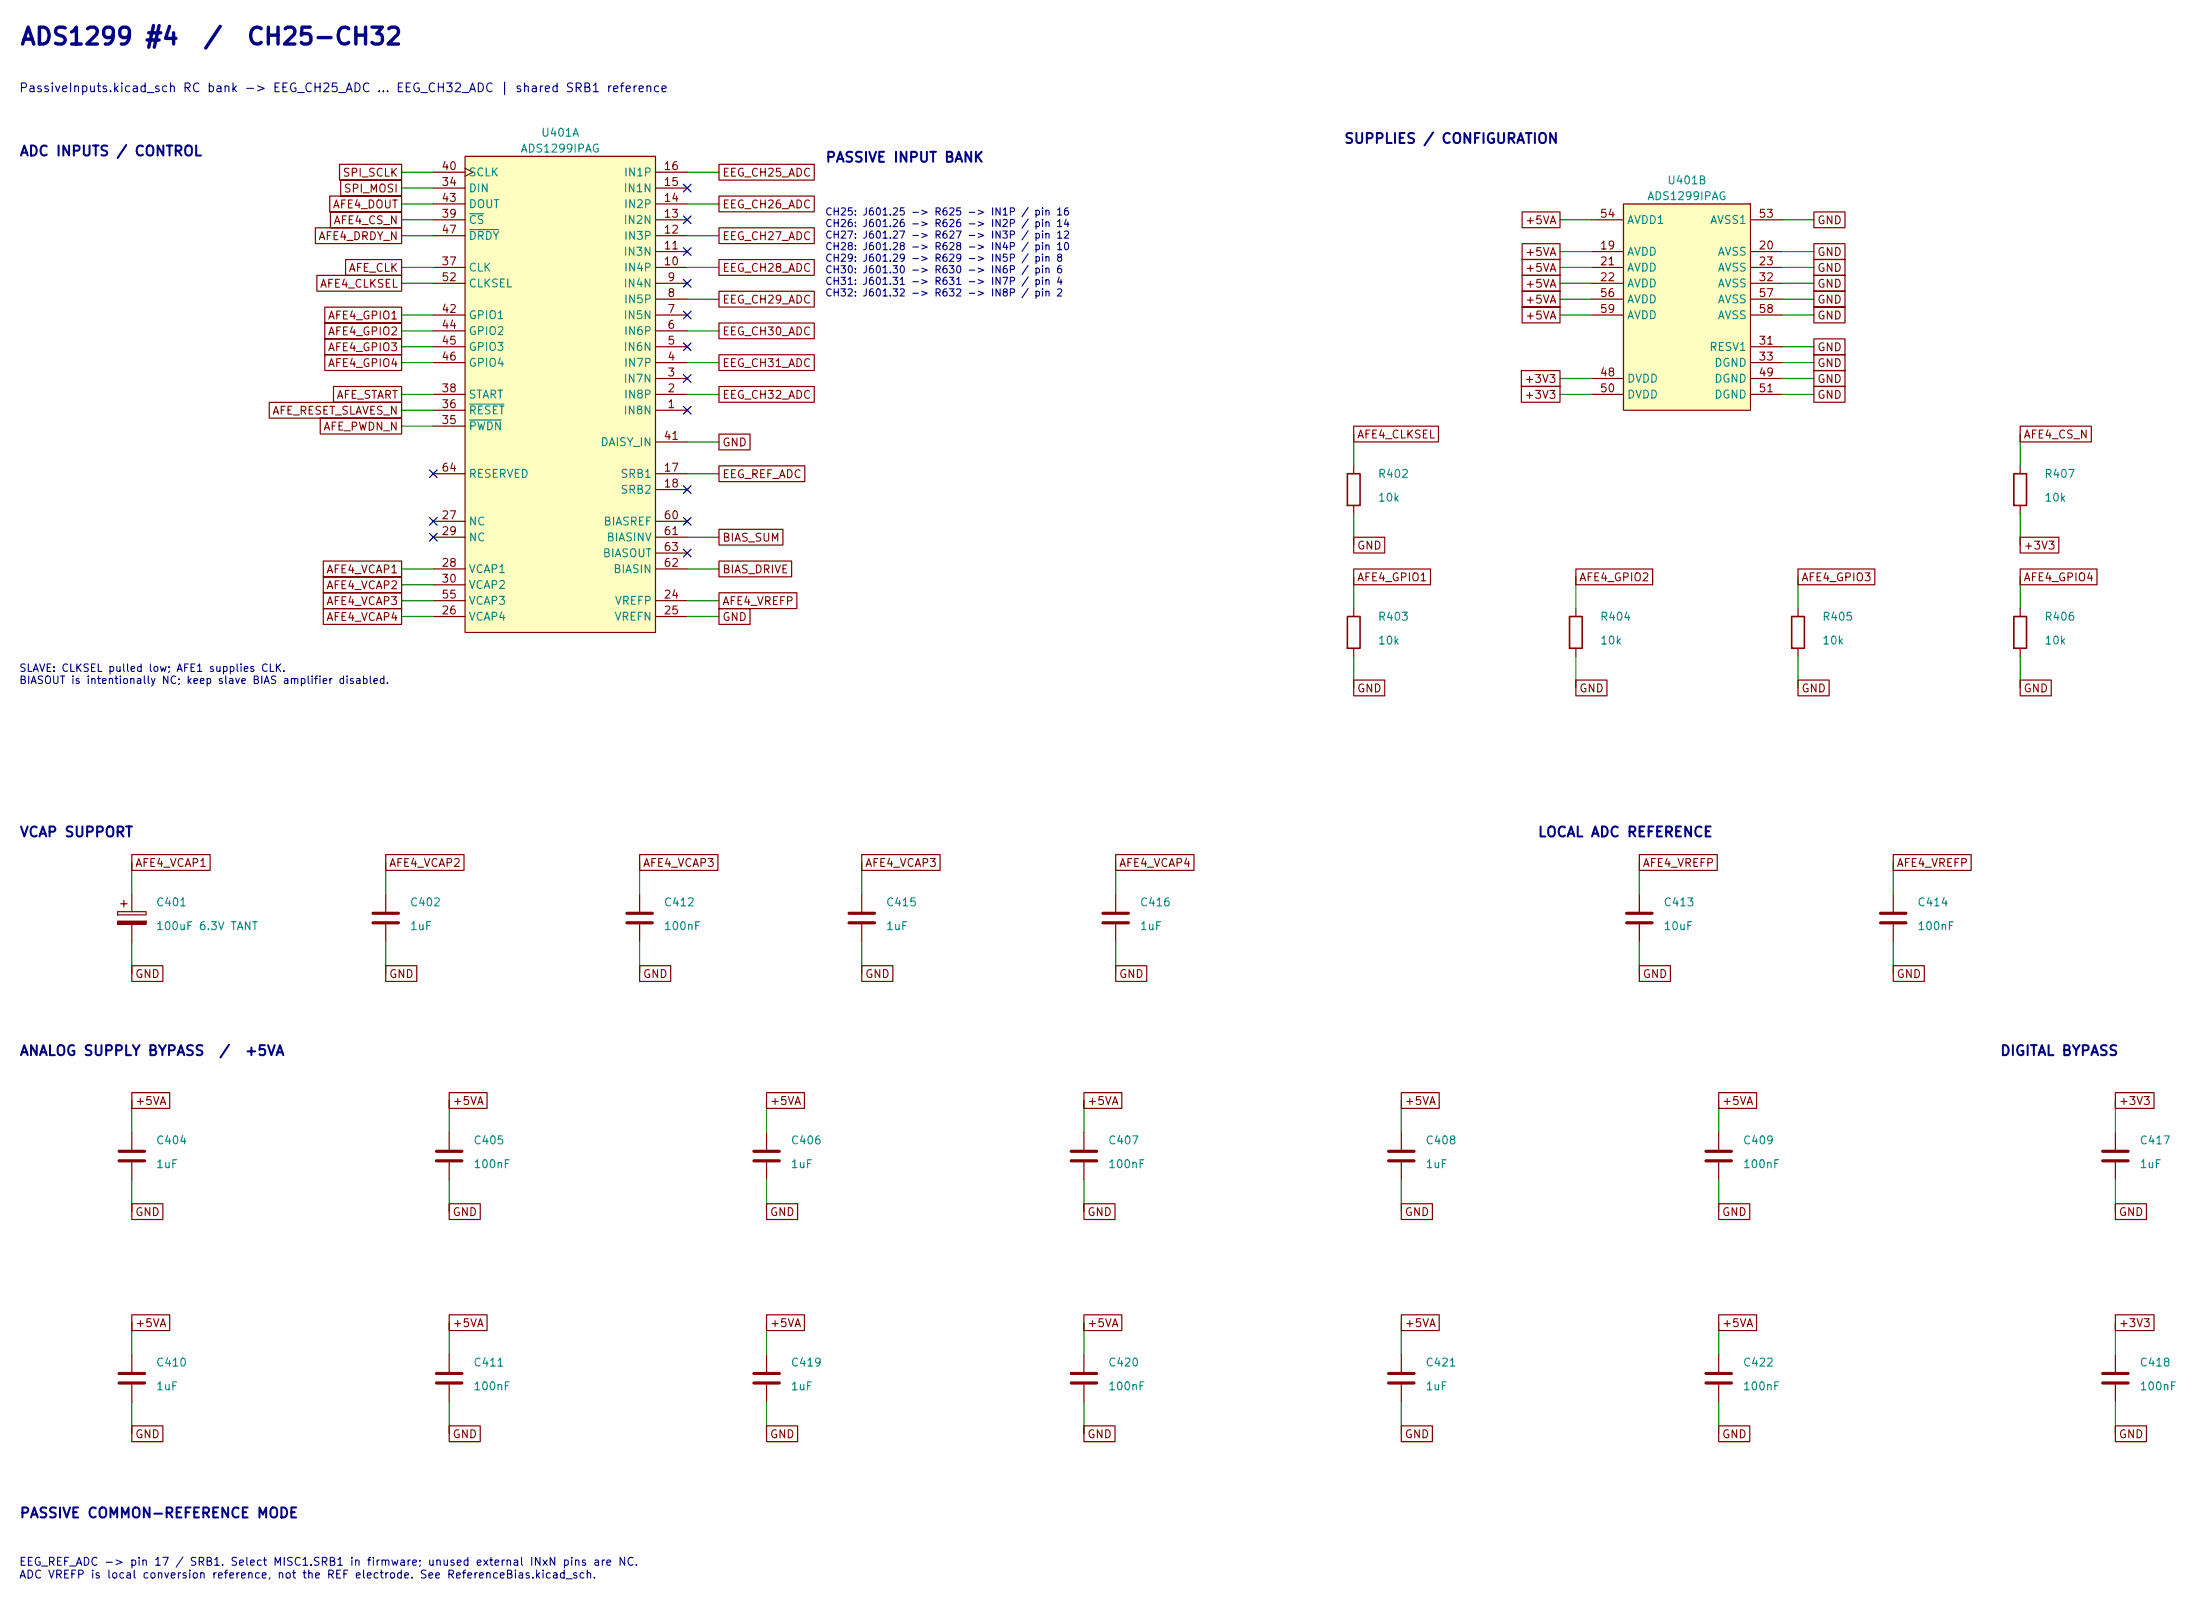
[picture p12: schematic AFE4.kicad_sch, EEG32 passive | AFE4 | CH25-CH32]

Parts:
C401: 100uF 6.3V TANT; CP_EIA-3528-21_Kemet-B; MPN T491B107K006AT
C402, C404, C406, C408, C410, C415, C416, C417, C419, C421: 1uF; C0402; MPN GRM155R61A105KE15D
C405, C407, C409, C411, C412, C414, C418, C420, C422: 100nF; C0402; MPN GRM155R71C104KA88D
C413: 10uF; C0603; MPN GRM188R61A106KE69D
R402, R403, R404, R405, R406, R407: 10k; R0402; MPN RC0402FR-0710KL
U401: ADS1299IPAG; PAG0064A_L; MPN ADS1299IPAG

Connections:
+3V3: C417.2, C418.1, R407.2, U401.48 (DVDD), U401.50 (DVDD); also elsewhere on the board
+5VA: C404.1, C405.2, C406.1, C407.2, C408.1, C409.2, C410.1, C411.2, C419.1, C420.1, C421.1, C422.1, U401.19 (AVDD), U401.21 (AVDD), U401.22 (AVDD), U401.54 (AVDD1), U401.56 (AVDD), U401.59 (AVDD); also elsewhere on the board
AFE4_CLKSEL: R402.1, U401.52 (CLKSEL)
AFE4_CS_N: R407.1, U401.39 (~CS); also elsewhere on the board
AFE4_DOUT: U401.43 (DOUT); also elsewhere on the board
AFE4_DRDY_N: U401.47 (~DRDY); also elsewhere on the board
AFE4_GPIO1: R403.1, U401.42 (GPIO1)
AFE4_GPIO2: R404.1, U401.44 (GPIO2)
AFE4_GPIO3: R405.1, U401.45 (GPIO3)
AFE4_GPIO4: R406.1, U401.46 (GPIO4)
AFE4_VCAP1: C401.1, U401.28 (VCAP1)
AFE4_VCAP2: C402.2, U401.30 (VCAP2)
AFE4_VCAP3: C412.2, C415.2, U401.55 (VCAP3)
AFE4_VCAP4: C416.2, U401.26 (VCAP4)
AFE4_VREFP: C413.1, C414.1, U401.24 (VREFP)
AFE_CLK: U401.37 (CLK); also elsewhere on the board
AFE_PWDN_N: U401.35 (~PWDN); also elsewhere on the board
AFE_RESET_SLAVES_N: U401.36 (~RESET); also elsewhere on the board
AFE_START: U401.38 (START); also elsewhere on the board
BIAS_DRIVE: U401.62 (BIASIN); also elsewhere on the board
BIAS_SUM: U401.61 (BIASINV); also elsewhere on the board
EEG_CH25_ADC: U401.16 (IN1P); also elsewhere on the board
EEG_CH26_ADC: U401.14 (IN2P); also elsewhere on the board
EEG_CH27_ADC: U401.12 (IN3P); also elsewhere on the board
EEG_CH28_ADC: U401.10 (IN4P); also elsewhere on the board
EEG_CH29_ADC: U401.8 (IN5P); also elsewhere on the board
EEG_CH30_ADC: U401.6 (IN6P); also elsewhere on the board
EEG_CH31_ADC: U401.4 (IN7P); also elsewhere on the board
EEG_CH32_ADC: U401.2 (IN8P); also elsewhere on the board
EEG_REF_ADC: U401.17 (SRB1); also elsewhere on the board
GND: C401.2, C402.1, C404.2, C405.1, C406.2, C407.1, C408.2, C409.1, C410.2, C411.1, C412.1, C413.2, C414.2, C415.1, C416.1, C417.1, C418.2, C419.2, C420.2, C421.2, C422.2, R402.2, R403.2, R404.2, R405.2, R406.2, U401.20 (AVSS), U401.23 (AVSS), U401.25 (VREFN), U401.31 (RESV1), U401.32 (AVSS), U401.33 (DGND), U401.41 (DAISY_IN), U401.49 (DGND), U401.51 (DGND), U401.53 (AVSS1), U401.57 (AVSS), U401.58 (AVSS); also elsewhere on the board
SPI_MOSI: U401.34 (DIN); also elsewhere on the board
SPI_SCLK: U401.40 (SCLK); also elsewhere on the board

Notes on the sheet:
ADS1299 #4 / CH25-CH32
PassiveInputs.kicad_sch RC bank -> EEG_CH25_ADC ... EEG_CH32_ADC | shared SRB1 reference
ADC INPUTS / CONTROL
SUPPLIES / CONFIGURATION
VCAP SUPPORT
LOCAL ADC REFERENCE
ANALOG SUPPLY BYPASS / +5VA
DIGITAL BYPASS
PASSIVE COMMON-REFERENCE MODE
EEG_REF_ADC -> pin 17 / SRB1. Select MISC1.SRB1 in firmware; unused external INxN pins are NC. ADC VREFP is local conversion reference, not the REF electrode. See ReferenceBias.kicad_sch.
SLAVE: CLKSEL pulled low; AFE1 supplies CLK. BIASOUT is intentionally NC; keep slave BIAS amplifier disabled.
PASSIVE INPUT BANK
CH25: J601.25 -> R625 -> IN1P / pin 16 CH26: J601.26 -> R626 -> IN2P / pin 14 CH27: J601.27 -> R627 -> IN3P / pin 12 CH28: J601.28 -> R628 -> IN4P / pin 10 CH29: J601.29 -> R629 -> IN5P / pin 8 CH30: J601.30 -> R630 -> IN6P / pin 6 CH31: J601.31 -> R631 -> IN7P / pin 4 CH32: J601.32 -> R632 -> IN8P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

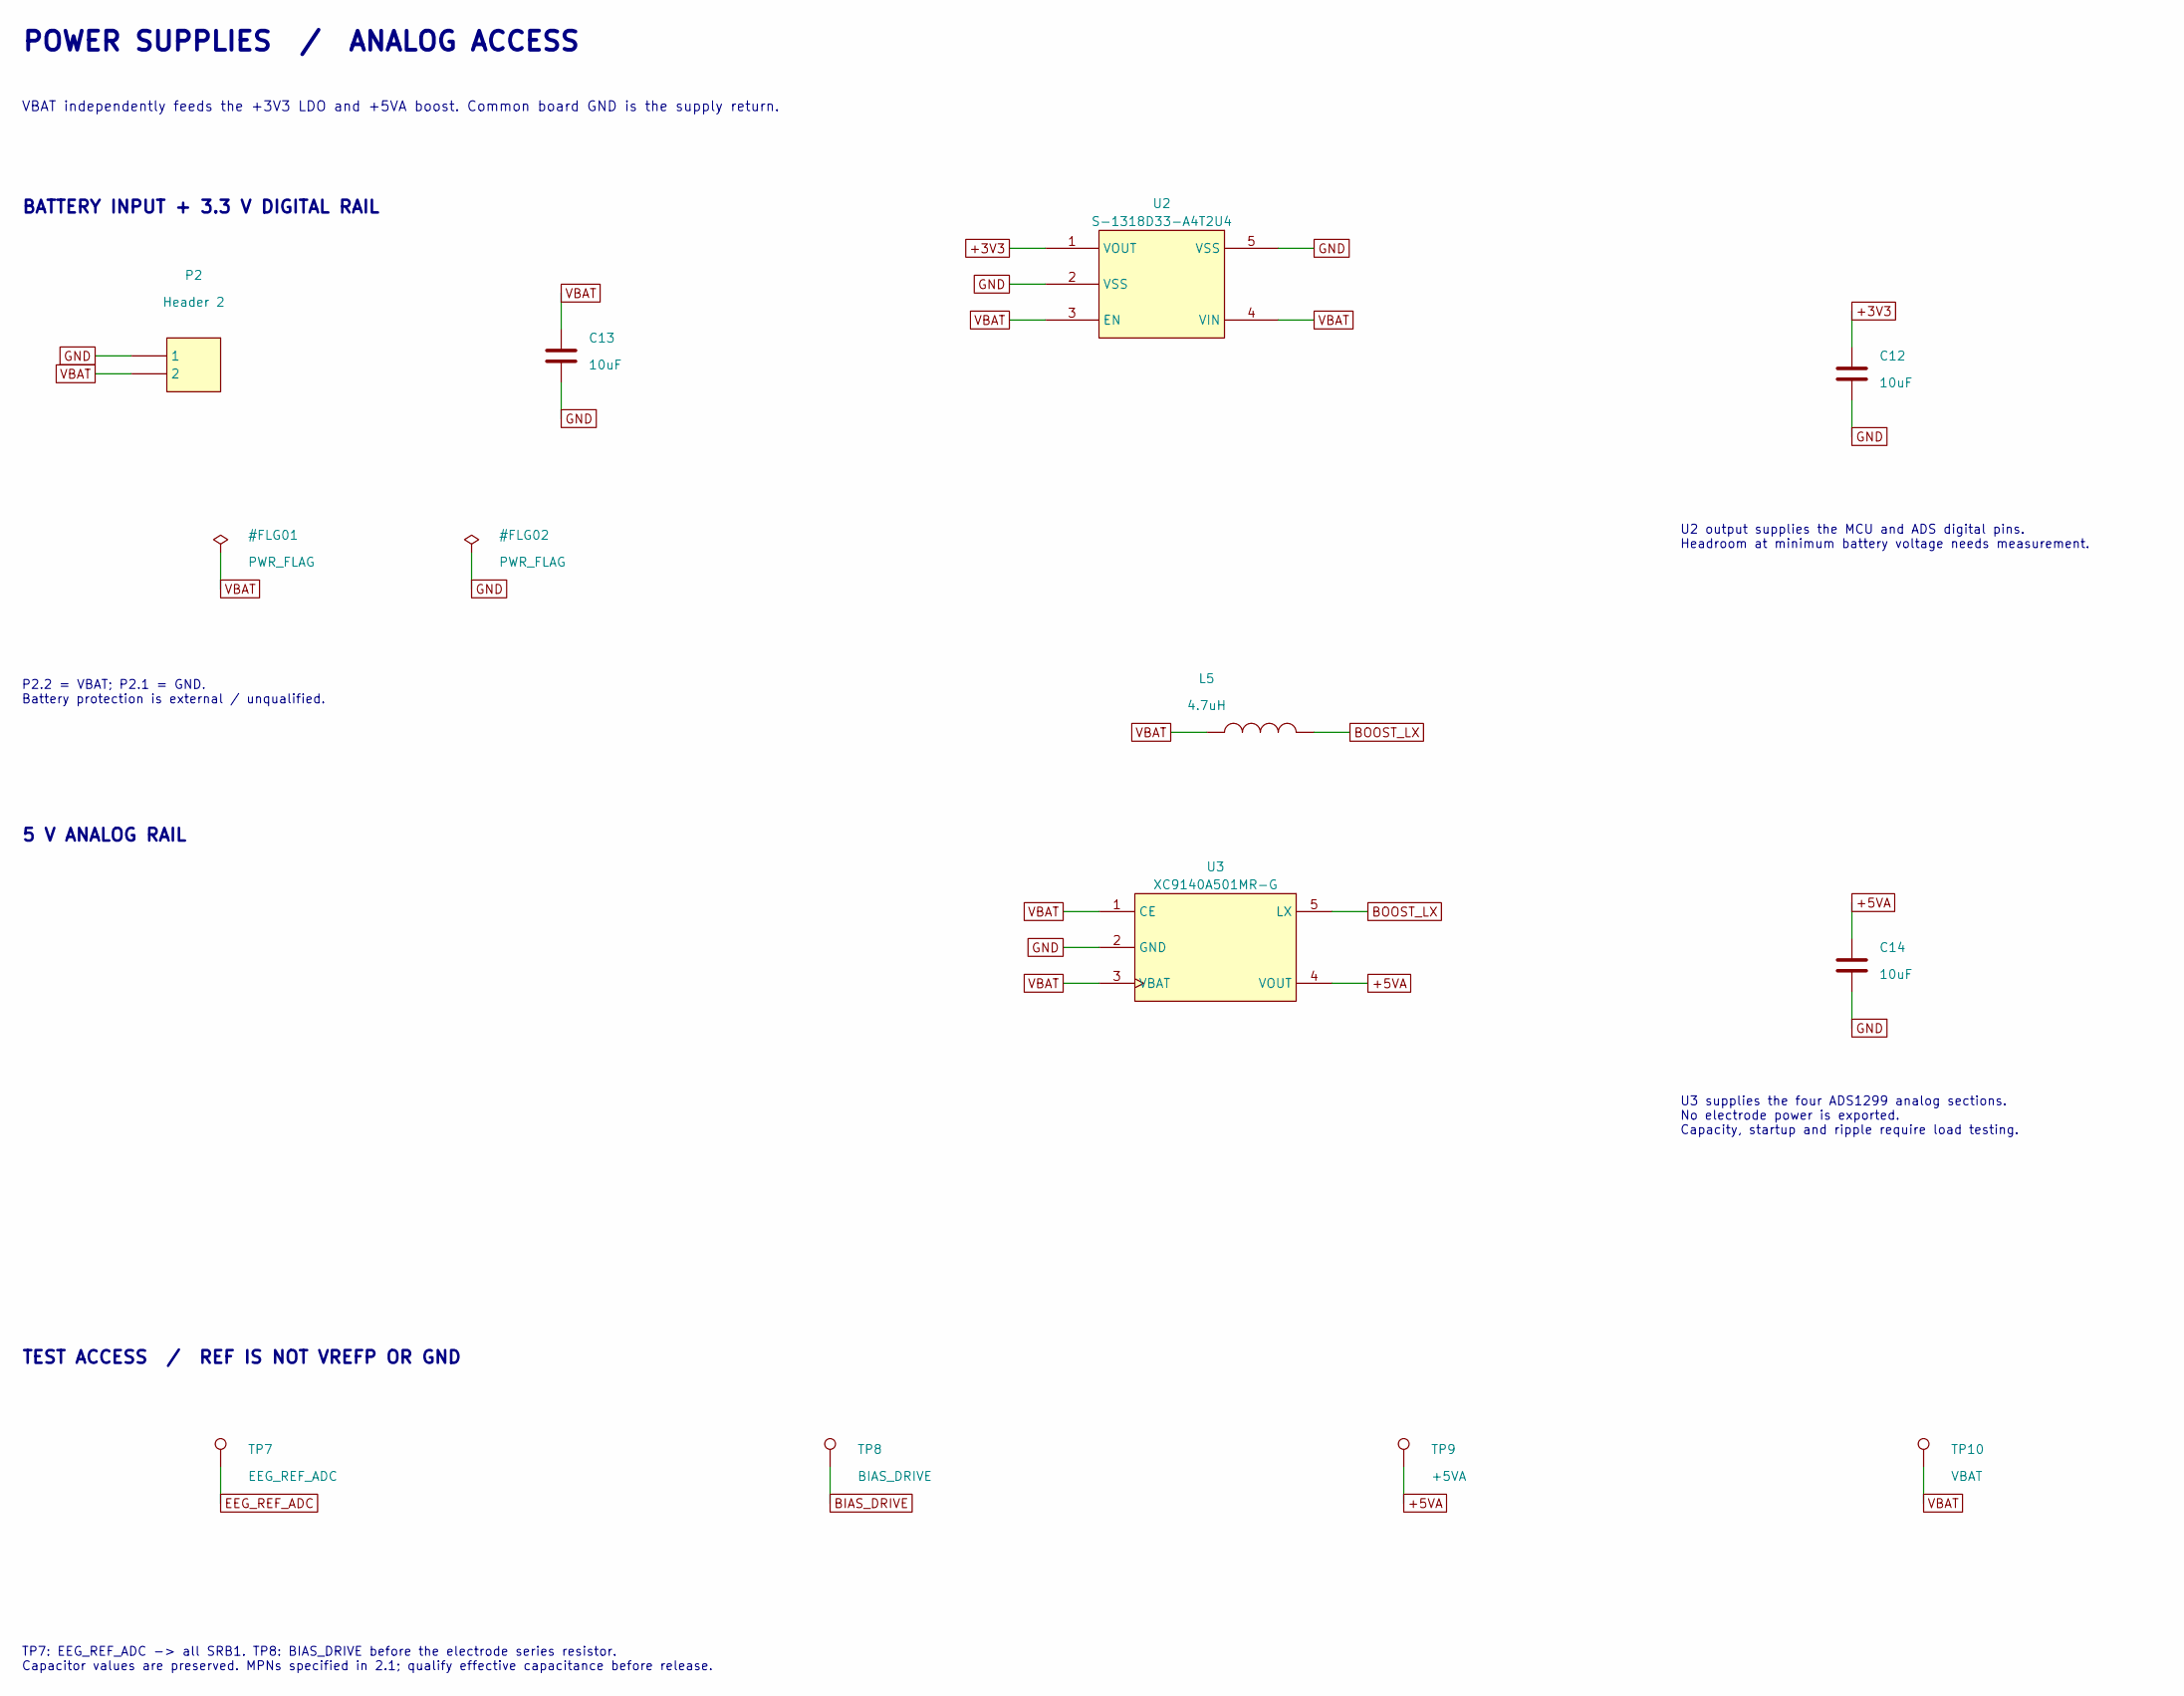
[picture p13: schematic Power.kicad_sch, EEG32 passive | Power]

Parts:
C12, C13, C14: 10uF; C0402; MPN GRM155R61A106ME11D
L5: 4.7uH; L0603; MPN LQM18PN4R7MFRL
P2: Header 2; HDR1X2; MPN NOT PURCHASED
TP7: EEG_REF_ADC; TestPoint_Pad_D1.5mm; MPN NOT PURCHASED
TP8: BIAS_DRIVE; TestPoint_Pad_D1.5mm; MPN NOT PURCHASED
TP9: +5VA; TestPoint_Pad_D1.5mm; MPN NOT PURCHASED
TP10: VBAT; TestPoint_Pad_D1.5mm; MPN NOT PURCHASED
U2: S-1318D33-A4T2U4; S-1318_A4T2U4; MPN S-1318D33-A4T2U4
U3: XC9140A501MR-G; FP-DBV0005A-IPC_C; MPN XC9140A501MR-G

Connections:
+3V3: C12.2, U2.1 (VOUT); also elsewhere on the board
+5VA: C14.1, TP9.1, U3.4 (VOUT); also elsewhere on the board
BIAS_DRIVE: TP8.1; also elsewhere on the board
BOOST_LX: L5.2, U3.5 (LX)
EEG_REF_ADC: TP7.1; also elsewhere on the board
GND: C12.1, C13.2, C14.2, P2.1, U2.2 (VSS), U2.5 (VSS), U3.2 (GND); also elsewhere on the board
VBAT: C13.1, L5.1, P2.2, TP10.1, U2.3 (EN), U2.4 (VIN), U3.1 (CE), U3.3 (VBAT)

Notes on the sheet:
POWER SUPPLIES / ANALOG ACCESS
VBAT independently feeds the +3V3 LDO and +5VA boost. Common board GND is the supply return.
BATTERY INPUT + 3.3 V DIGITAL RAIL
P2.2 = VBAT; P2.1 = GND. Battery protection is external / unqualified.
5 V ANALOG RAIL
U2 output supplies the MCU and ADS digital pins. Headroom at minimum battery voltage needs measurement.
U3 supplies the four ADS1299 analog sections. No electrode power is exported. Capacity, startup and ripple require load testing.
TEST ACCESS / REF IS NOT VREFP OR GND
TP7: EEG_REF_ADC -> all SRB1. TP8: BIAS_DRIVE before the electrode series resistor. Capacitor values are preserved. MPNs specified in 2.1; qualify effective capacitance before release.

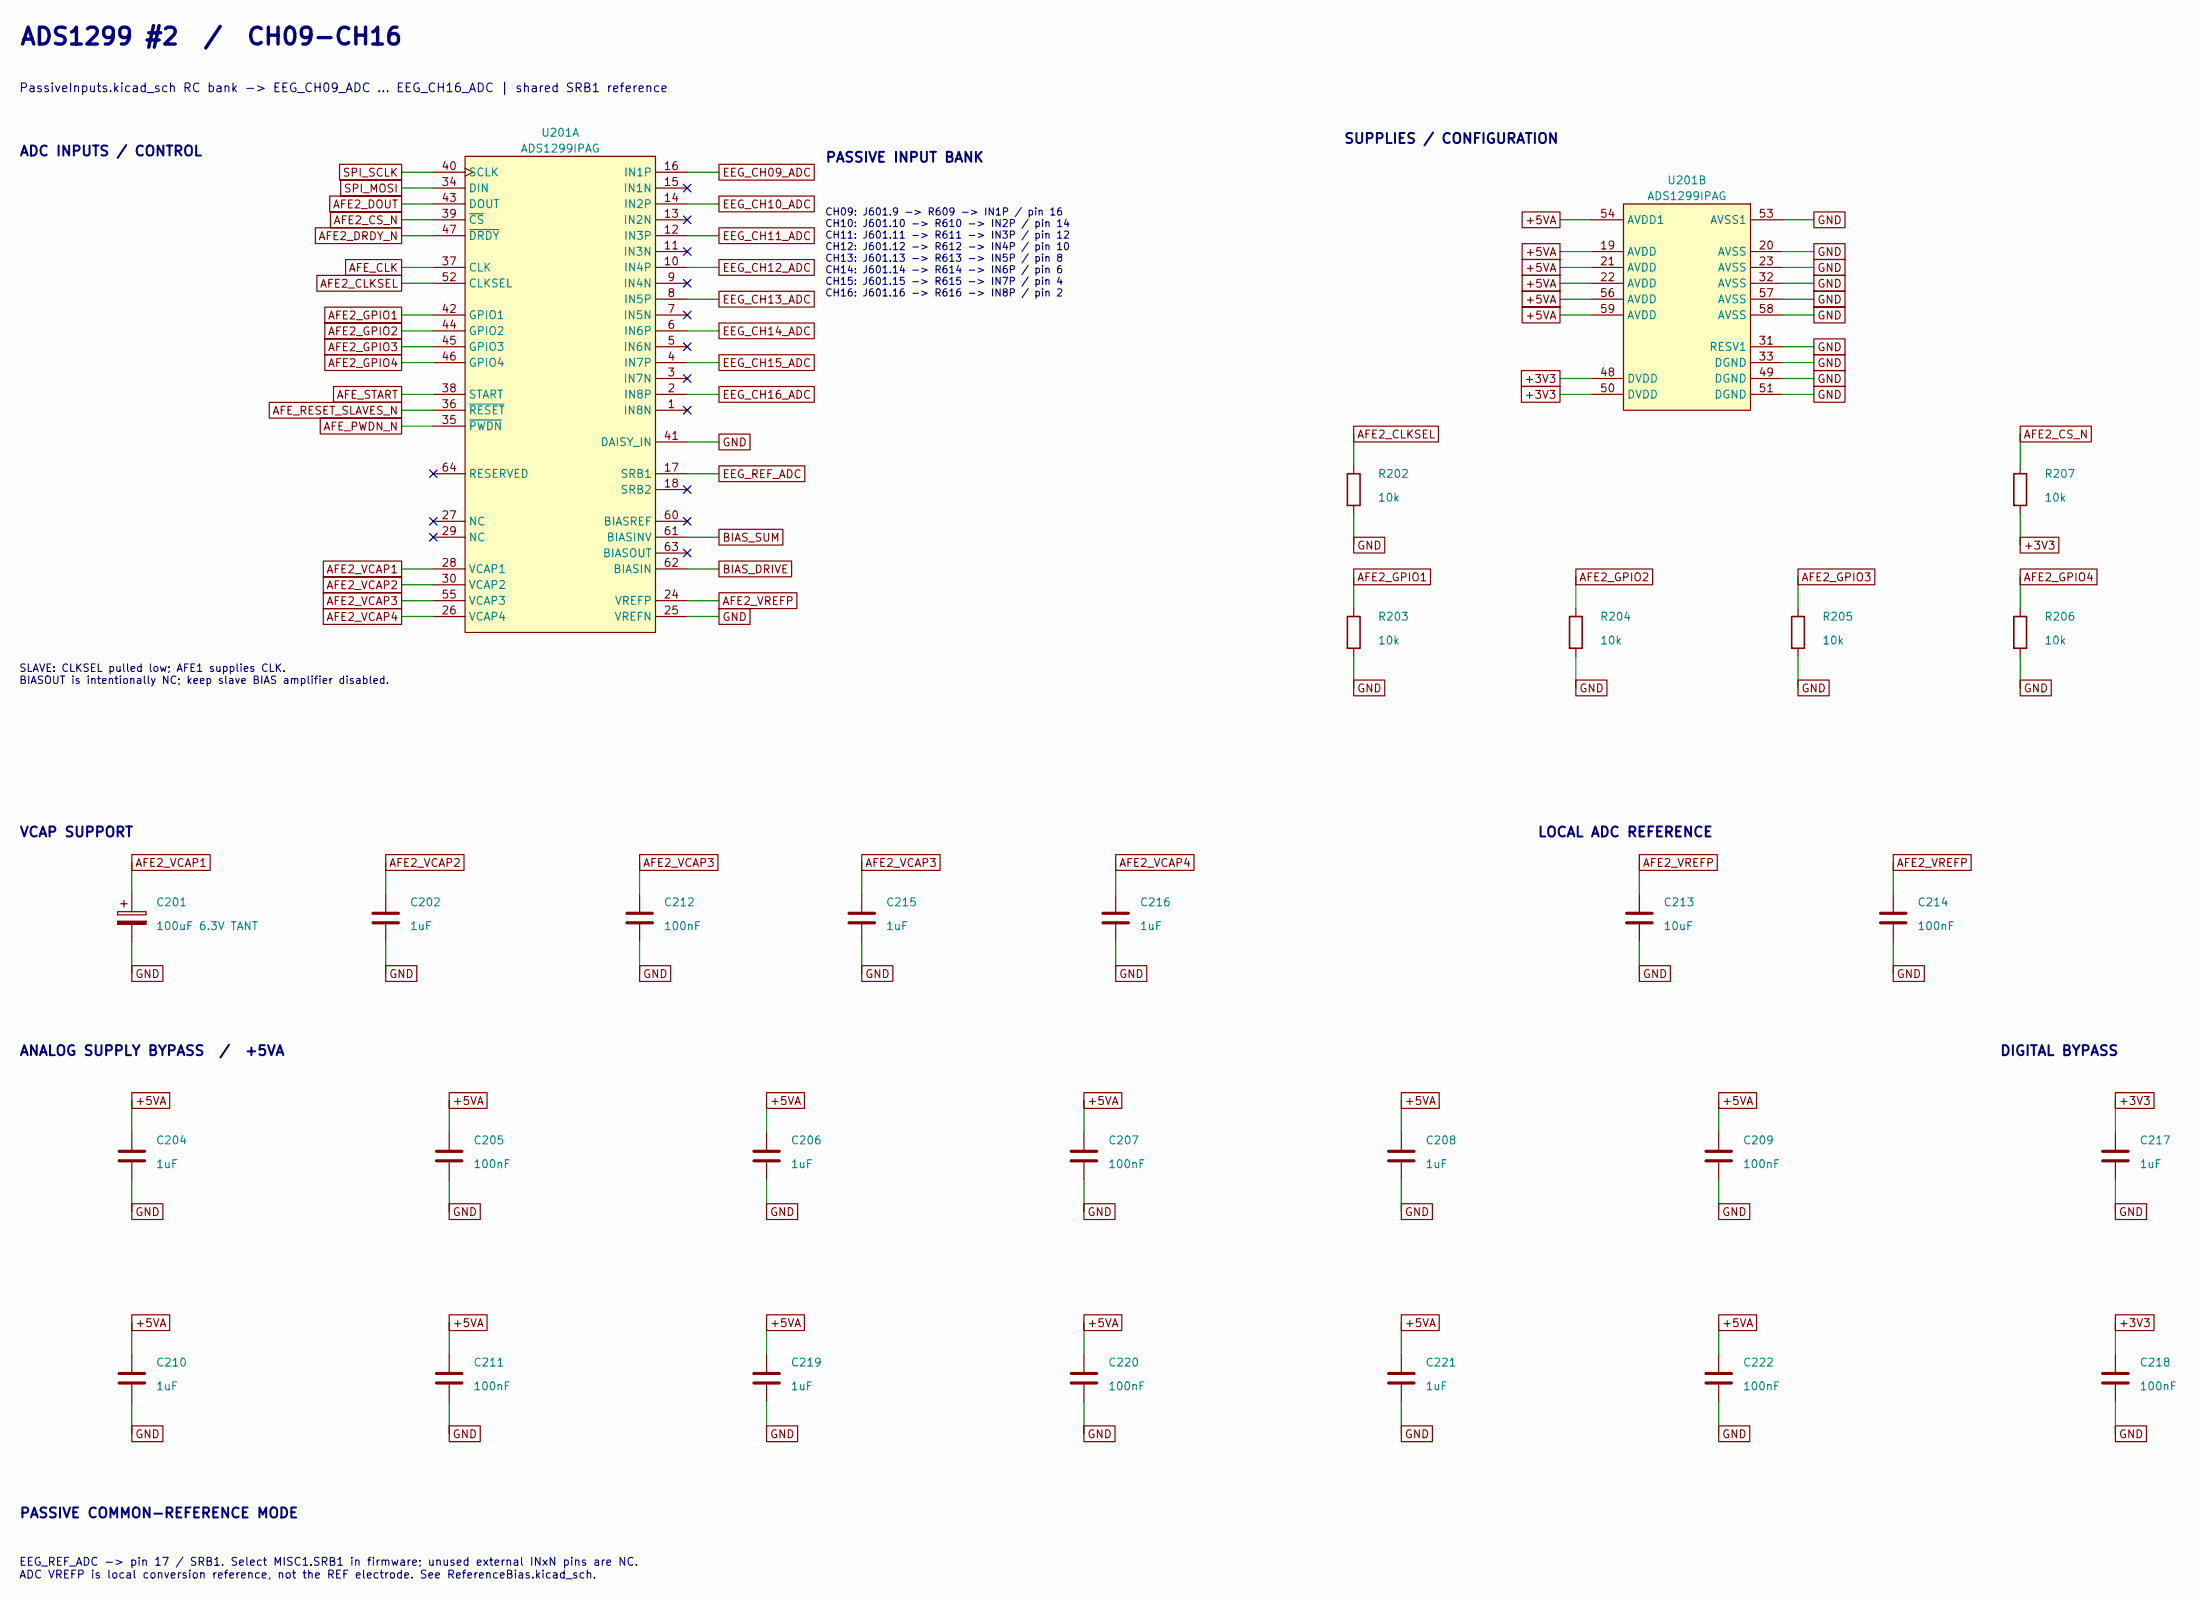
[picture p14: schematic AFE2.kicad_sch, EEG32 passive | AFE2 | CH09-CH16]

Parts:
C201: 100uF 6.3V TANT; CP_EIA-3528-21_Kemet-B; MPN T491B107K006AT
C202, C204, C206, C208, C210, C215, C216, C217, C219, C221: 1uF; C0402; MPN GRM155R61A105KE15D
C205, C207, C209, C211, C212, C214, C218, C220, C222: 100nF; C0402; MPN GRM155R71C104KA88D
C213: 10uF; C0603; MPN GRM188R61A106KE69D
R202, R203, R204, R205, R206, R207: 10k; R0402; MPN RC0402FR-0710KL
U201: ADS1299IPAG; PAG0064A_L; MPN ADS1299IPAG

Connections:
+3V3: C217.2, C218.1, R207.2, U201.48 (DVDD), U201.50 (DVDD); also elsewhere on the board
+5VA: C204.1, C205.2, C206.1, C207.2, C208.1, C209.2, C210.1, C211.2, C219.1, C220.1, C221.1, C222.1, U201.19 (AVDD), U201.21 (AVDD), U201.22 (AVDD), U201.54 (AVDD1), U201.56 (AVDD), U201.59 (AVDD); also elsewhere on the board
AFE2_CLKSEL: R202.1, U201.52 (CLKSEL)
AFE2_CS_N: R207.1, U201.39 (~CS); also elsewhere on the board
AFE2_DOUT: U201.43 (DOUT); also elsewhere on the board
AFE2_DRDY_N: U201.47 (~DRDY); also elsewhere on the board
AFE2_GPIO1: R203.1, U201.42 (GPIO1)
AFE2_GPIO2: R204.1, U201.44 (GPIO2)
AFE2_GPIO3: R205.1, U201.45 (GPIO3)
AFE2_GPIO4: R206.1, U201.46 (GPIO4)
AFE2_VCAP1: C201.1, U201.28 (VCAP1)
AFE2_VCAP2: C202.2, U201.30 (VCAP2)
AFE2_VCAP3: C212.2, C215.2, U201.55 (VCAP3)
AFE2_VCAP4: C216.2, U201.26 (VCAP4)
AFE2_VREFP: C213.1, C214.1, U201.24 (VREFP)
AFE_CLK: U201.37 (CLK); also elsewhere on the board
AFE_PWDN_N: U201.35 (~PWDN); also elsewhere on the board
AFE_RESET_SLAVES_N: U201.36 (~RESET); also elsewhere on the board
AFE_START: U201.38 (START); also elsewhere on the board
BIAS_DRIVE: U201.62 (BIASIN); also elsewhere on the board
BIAS_SUM: U201.61 (BIASINV); also elsewhere on the board
EEG_CH09_ADC: U201.16 (IN1P); also elsewhere on the board
EEG_CH10_ADC: U201.14 (IN2P); also elsewhere on the board
EEG_CH11_ADC: U201.12 (IN3P); also elsewhere on the board
EEG_CH12_ADC: U201.10 (IN4P); also elsewhere on the board
EEG_CH13_ADC: U201.8 (IN5P); also elsewhere on the board
EEG_CH14_ADC: U201.6 (IN6P); also elsewhere on the board
EEG_CH15_ADC: U201.4 (IN7P); also elsewhere on the board
EEG_CH16_ADC: U201.2 (IN8P); also elsewhere on the board
EEG_REF_ADC: U201.17 (SRB1); also elsewhere on the board
GND: C201.2, C202.1, C204.2, C205.1, C206.2, C207.1, C208.2, C209.1, C210.2, C211.1, C212.1, C213.2, C214.2, C215.1, C216.1, C217.1, C218.2, C219.2, C220.2, C221.2, C222.2, R202.2, R203.2, R204.2, R205.2, R206.2, U201.20 (AVSS), U201.23 (AVSS), U201.25 (VREFN), U201.31 (RESV1), U201.32 (AVSS), U201.33 (DGND), U201.41 (DAISY_IN), U201.49 (DGND), U201.51 (DGND), U201.53 (AVSS1), U201.57 (AVSS), U201.58 (AVSS); also elsewhere on the board
SPI_MOSI: U201.34 (DIN); also elsewhere on the board
SPI_SCLK: U201.40 (SCLK); also elsewhere on the board

Notes on the sheet:
ADS1299 #2 / CH09-CH16
PassiveInputs.kicad_sch RC bank -> EEG_CH09_ADC ... EEG_CH16_ADC | shared SRB1 reference
ADC INPUTS / CONTROL
SUPPLIES / CONFIGURATION
VCAP SUPPORT
LOCAL ADC REFERENCE
ANALOG SUPPLY BYPASS / +5VA
DIGITAL BYPASS
PASSIVE COMMON-REFERENCE MODE
EEG_REF_ADC -> pin 17 / SRB1. Select MISC1.SRB1 in firmware; unused external INxN pins are NC. ADC VREFP is local conversion reference, not the REF electrode. See ReferenceBias.kicad_sch.
SLAVE: CLKSEL pulled low; AFE1 supplies CLK. BIASOUT is intentionally NC; keep slave BIAS amplifier disabled.
PASSIVE INPUT BANK
CH09: J601.9 -> R609 -> IN1P / pin 16 CH10: J601.10 -> R610 -> IN2P / pin 14 CH11: J601.11 -> R611 -> IN3P / pin 12 CH12: J601.12 -> R612 -> IN4P / pin 10 CH13: J601.13 -> R613 -> IN5P / pin 8 CH14: J601.14 -> R614 -> IN6P / pin 6 CH15: J601.15 -> R615 -> IN7P / pin 4 CH16: J601.16 -> R616 -> IN8P 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

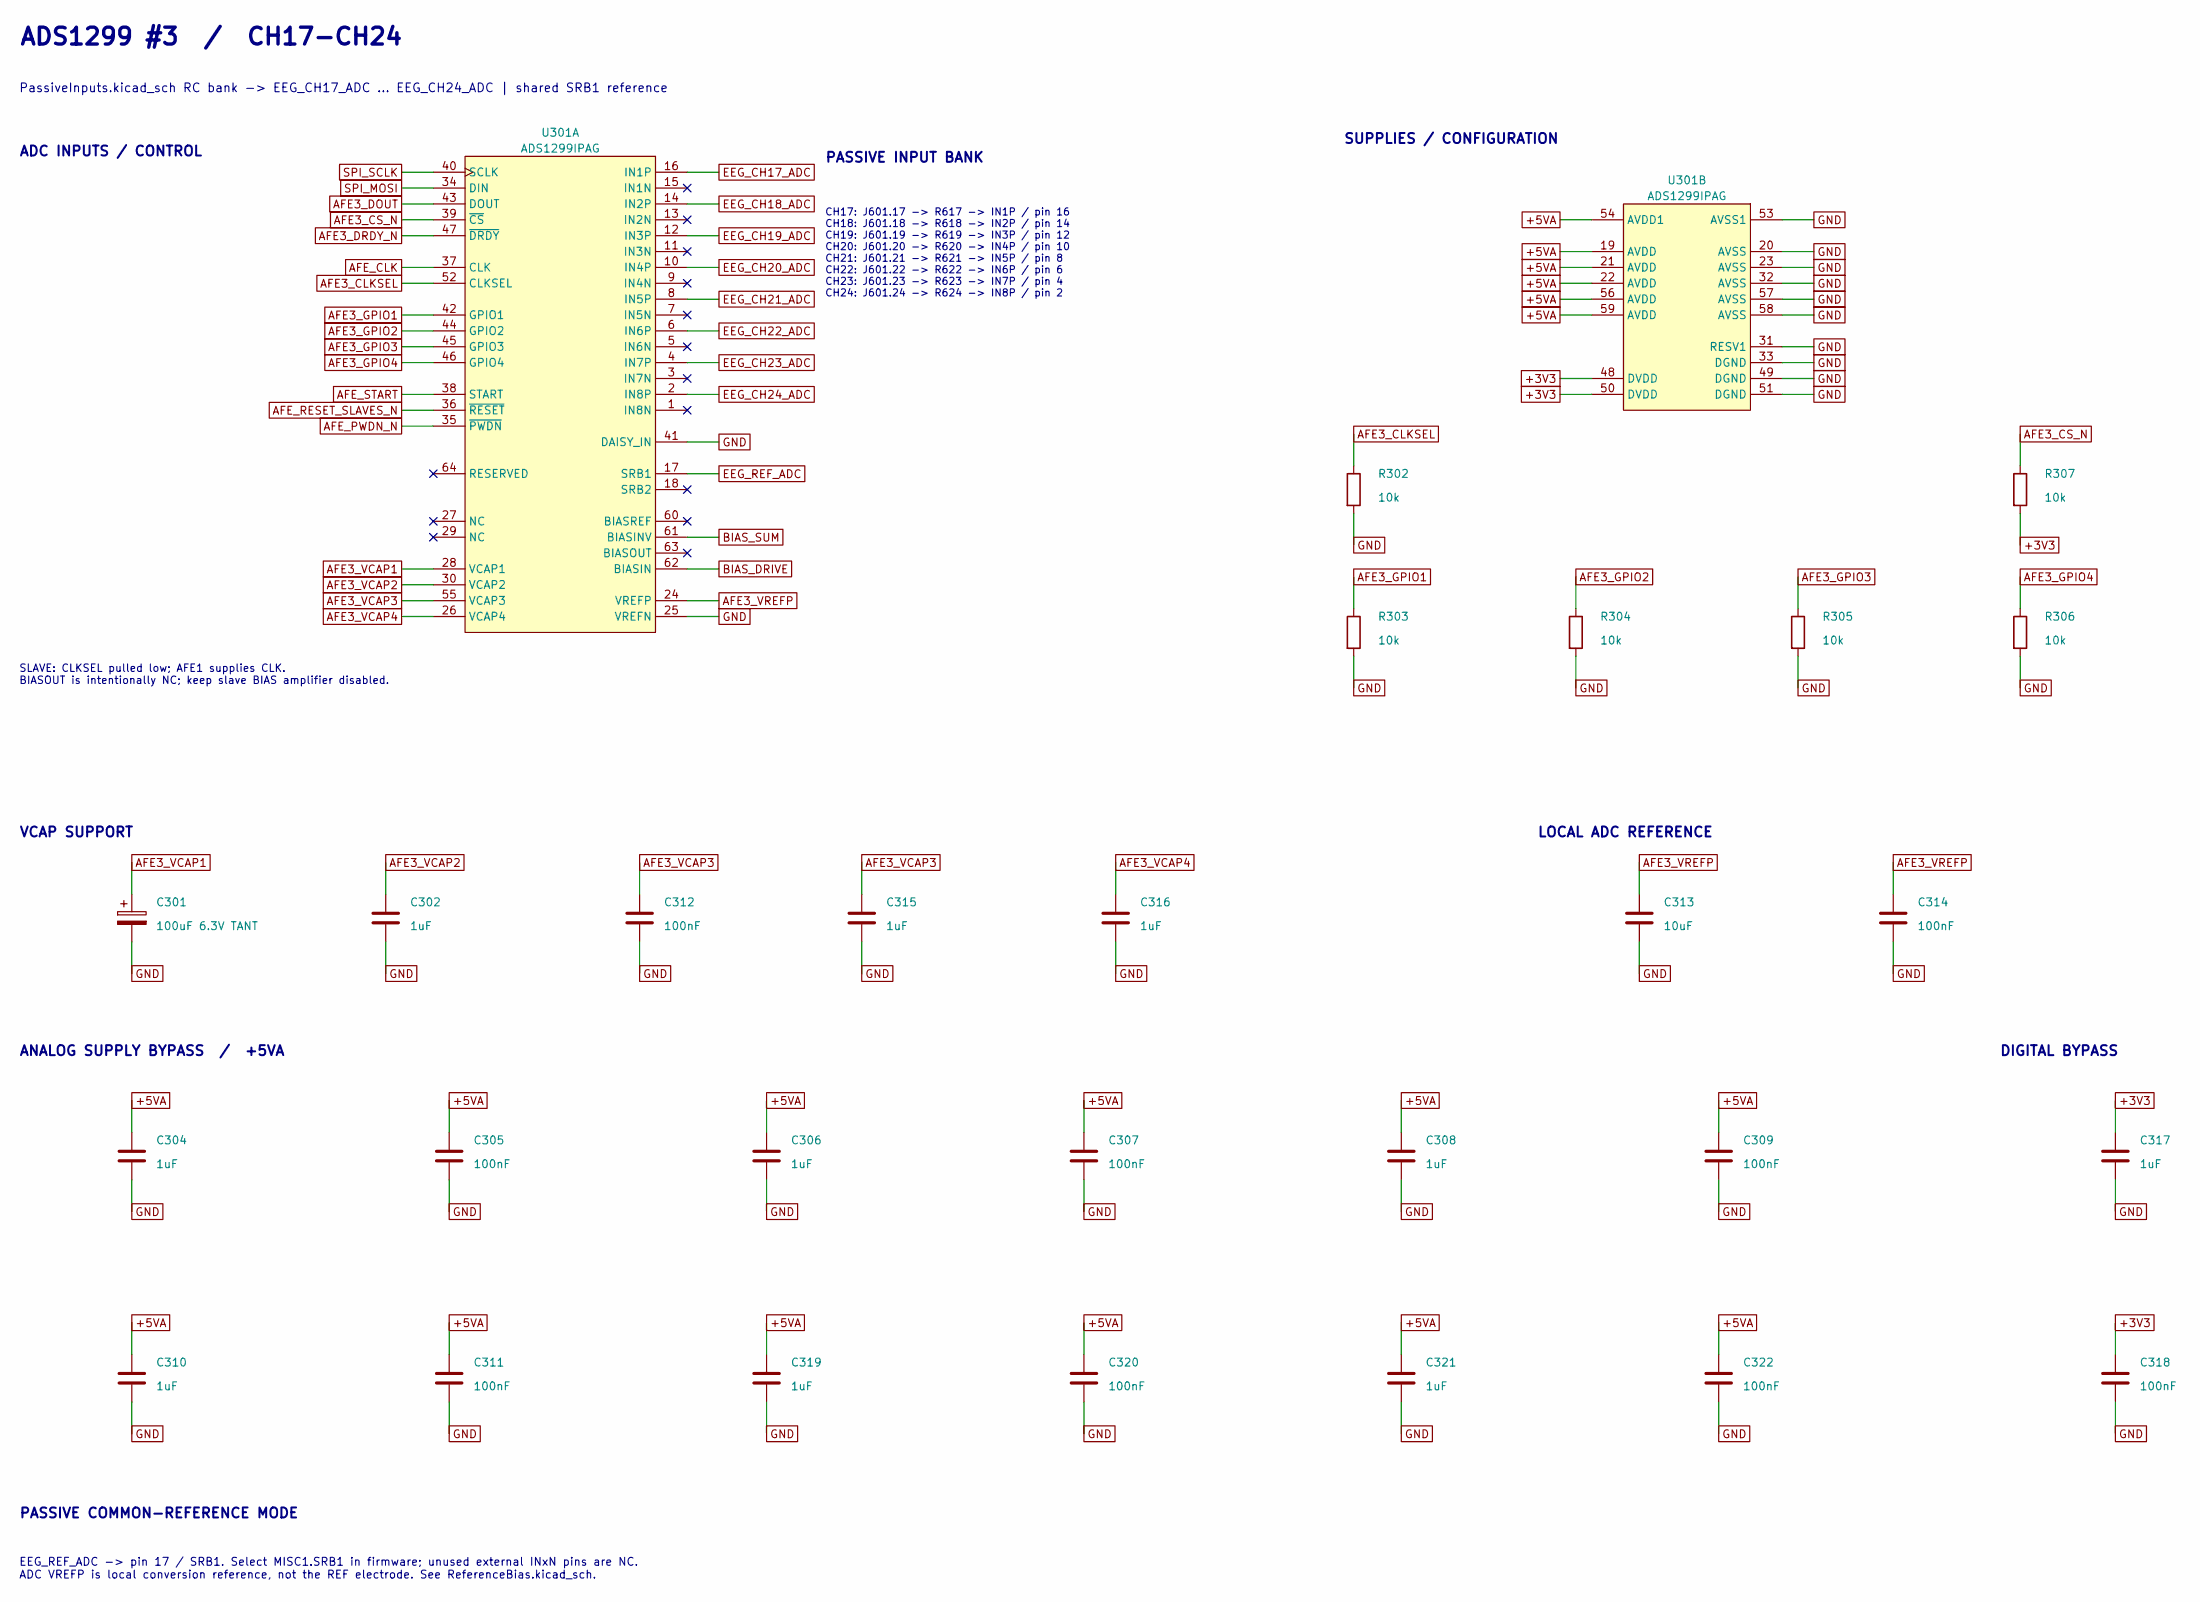
[picture p15: schematic AFE3.kicad_sch, EEG32 passive | AFE3 | CH17-CH24]

Parts:
C301: 100uF 6.3V TANT; CP_EIA-3528-21_Kemet-B; MPN T491B107K006AT
C302, C304, C306, C308, C310, C315, C316, C317, C319, C321: 1uF; C0402; MPN GRM155R61A105KE15D
C305, C307, C309, C311, C312, C314, C318, C320, C322: 100nF; C0402; MPN GRM155R71C104KA88D
C313: 10uF; C0603; MPN GRM188R61A106KE69D
R302, R303, R304, R305, R306, R307: 10k; R0402; MPN RC0402FR-0710KL
U301: ADS1299IPAG; PAG0064A_L; MPN ADS1299IPAG

Connections:
+3V3: C317.2, C318.1, R307.2, U301.48 (DVDD), U301.50 (DVDD); also elsewhere on the board
+5VA: C304.1, C305.2, C306.1, C307.2, C308.1, C309.2, C310.1, C311.2, C319.1, C320.1, C321.1, C322.1, U301.19 (AVDD), U301.21 (AVDD), U301.22 (AVDD), U301.54 (AVDD1), U301.56 (AVDD), U301.59 (AVDD); also elsewhere on the board
AFE3_CLKSEL: R302.1, U301.52 (CLKSEL)
AFE3_CS_N: R307.1, U301.39 (~CS); also elsewhere on the board
AFE3_DOUT: U301.43 (DOUT); also elsewhere on the board
AFE3_DRDY_N: U301.47 (~DRDY); also elsewhere on the board
AFE3_GPIO1: R303.1, U301.42 (GPIO1)
AFE3_GPIO2: R304.1, U301.44 (GPIO2)
AFE3_GPIO3: R305.1, U301.45 (GPIO3)
AFE3_GPIO4: R306.1, U301.46 (GPIO4)
AFE3_VCAP1: C301.1, U301.28 (VCAP1)
AFE3_VCAP2: C302.2, U301.30 (VCAP2)
AFE3_VCAP3: C312.2, C315.2, U301.55 (VCAP3)
AFE3_VCAP4: C316.2, U301.26 (VCAP4)
AFE3_VREFP: C313.1, C314.1, U301.24 (VREFP)
AFE_CLK: U301.37 (CLK); also elsewhere on the board
AFE_PWDN_N: U301.35 (~PWDN); also elsewhere on the board
AFE_RESET_SLAVES_N: U301.36 (~RESET); also elsewhere on the board
AFE_START: U301.38 (START); also elsewhere on the board
BIAS_DRIVE: U301.62 (BIASIN); also elsewhere on the board
BIAS_SUM: U301.61 (BIASINV); also elsewhere on the board
EEG_CH17_ADC: U301.16 (IN1P); also elsewhere on the board
EEG_CH18_ADC: U301.14 (IN2P); also elsewhere on the board
EEG_CH19_ADC: U301.12 (IN3P); also elsewhere on the board
EEG_CH20_ADC: U301.10 (IN4P); also elsewhere on the board
EEG_CH21_ADC: U301.8 (IN5P); also elsewhere on the board
EEG_CH22_ADC: U301.6 (IN6P); also elsewhere on the board
EEG_CH23_ADC: U301.4 (IN7P); also elsewhere on the board
EEG_CH24_ADC: U301.2 (IN8P); also elsewhere on the board
EEG_REF_ADC: U301.17 (SRB1); also elsewhere on the board
GND: C301.2, C302.1, C304.2, C305.1, C306.2, C307.1, C308.2, C309.1, C310.2, C311.1, C312.1, C313.2, C314.2, C315.1, C316.1, C317.1, C318.2, C319.2, C320.2, C321.2, C322.2, R302.2, R303.2, R304.2, R305.2, R306.2, U301.20 (AVSS), U301.23 (AVSS), U301.25 (VREFN), U301.31 (RESV1), U301.32 (AVSS), U301.33 (DGND), U301.41 (DAISY_IN), U301.49 (DGND), U301.51 (DGND), U301.53 (AVSS1), U301.57 (AVSS), U301.58 (AVSS); also elsewhere on the board
SPI_MOSI: U301.34 (DIN); also elsewhere on the board
SPI_SCLK: U301.40 (SCLK); also elsewhere on the board

Notes on the sheet:
ADS1299 #3 / CH17-CH24
PassiveInputs.kicad_sch RC bank -> EEG_CH17_ADC ... EEG_CH24_ADC | shared SRB1 reference
ADC INPUTS / CONTROL
SUPPLIES / CONFIGURATION
VCAP SUPPORT
LOCAL ADC REFERENCE
ANALOG SUPPLY BYPASS / +5VA
DIGITAL BYPASS
PASSIVE COMMON-REFERENCE MODE
EEG_REF_ADC -> pin 17 / SRB1. Select MISC1.SRB1 in firmware; unused external INxN pins are NC. ADC VREFP is local conversion reference, not the REF electrode. See ReferenceBias.kicad_sch.
SLAVE: CLKSEL pulled low; AFE1 supplies CLK. BIASOUT is intentionally NC; keep slave BIAS amplifier disabled.
PASSIVE INPUT BANK
CH17: J601.17 -> R617 -> IN1P / pin 16 CH18: J601.18 -> R618 -> IN2P / pin 14 CH19: J601.19 -> R619 -> IN3P / pin 12 CH20: J601.20 -> R620 -> IN4P / pin 10 CH21: J601.21 -> R621 -> IN5P / pin 8 CH22: J601.22 -> R622 -> IN6P / pin 6 CH23: J601.23 -> R623 -> IN7P / pin 4 CH24: J601.24 -> R624 -> IN8P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
