Iwetter/EEG32/EEG32.kicad_pcb

## KiCad design EEG32.kicad_pcb (continued)

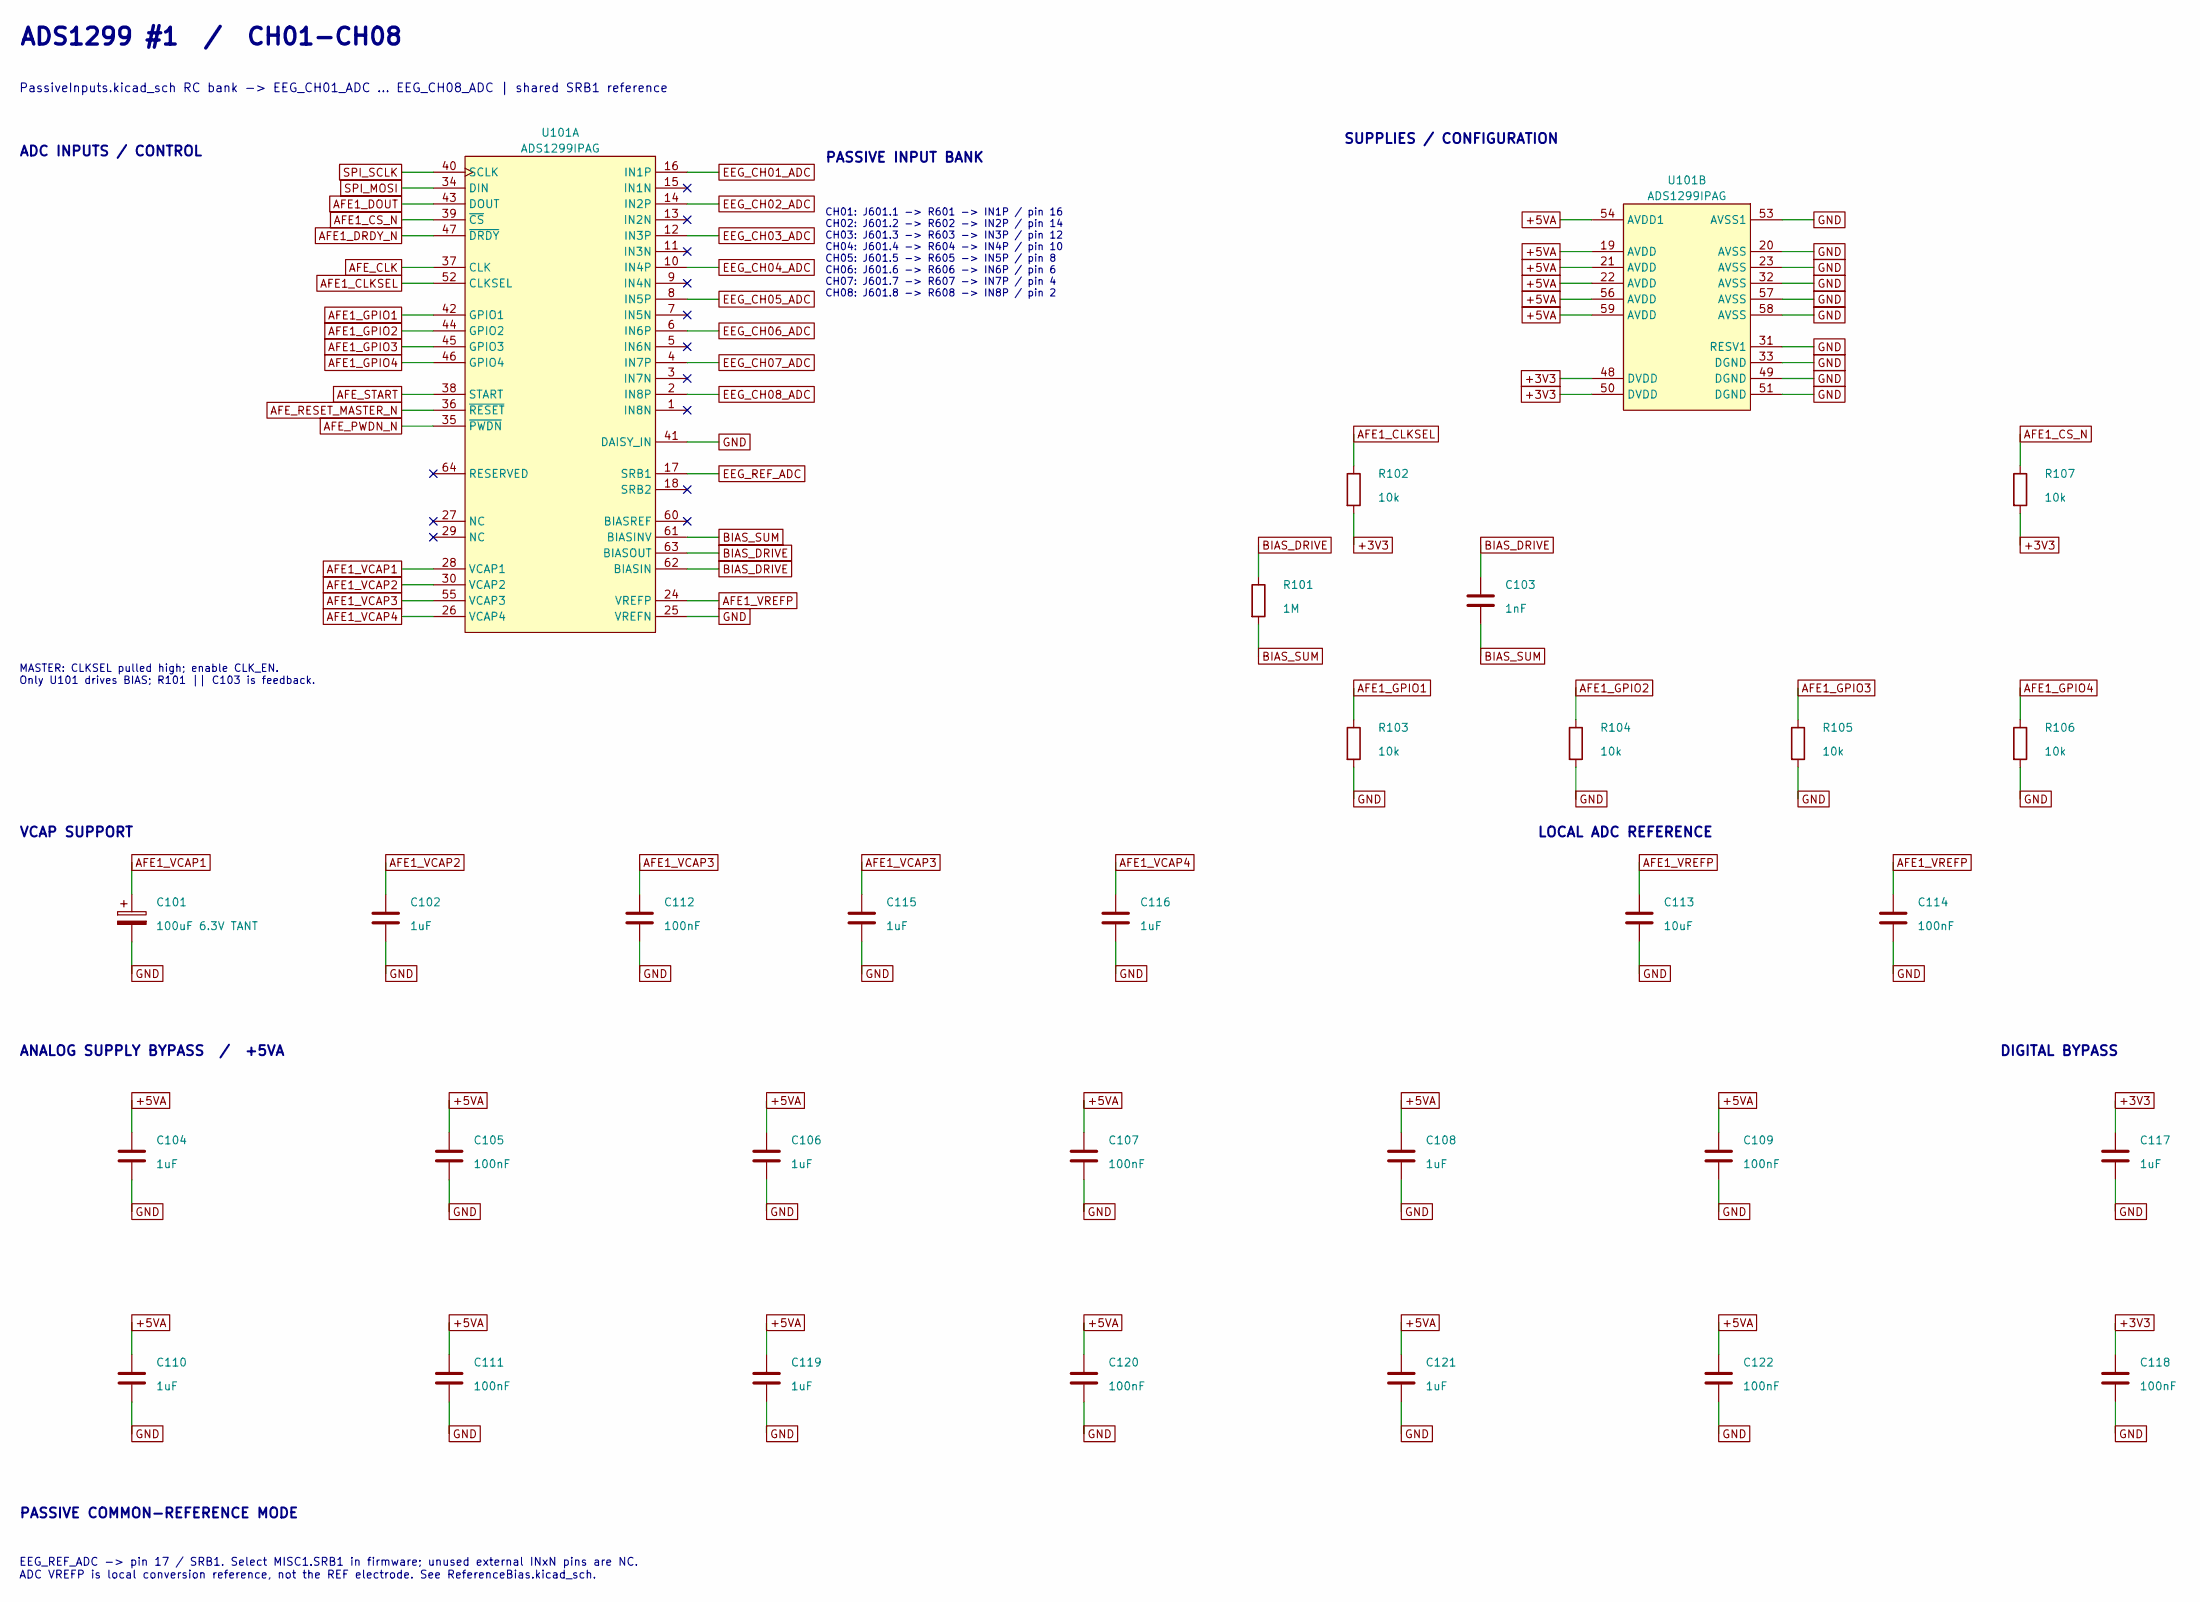
[picture p16: schematic AFE1.kicad_sch, EEG32 passive | AFE1 | CH01-CH08]

Parts:
C101: 100uF 6.3V TANT; CP_EIA-3528-21_Kemet-B; MPN T491B107K006AT
C102, C104, C106, C108, C110, C115, C116, C117, C119, C121: 1uF; C0402; MPN GRM155R61A105KE15D
C103: 1nF; C0402; MPN GRM1555C1H102JA01D
C105, C107, C109, C111, C112, C114, C118, C120, C122: 100nF; C0402; MPN GRM155R71C104KA88D
C113: 10uF; C0603; MPN GRM188R61A106KE69D
R101: 1M; R0402; MPN RC0402FR-071ML
R102, R103, R104, R105, R106, R107: 10k; R0402; MPN RC0402FR-0710KL
U101: ADS1299IPAG; PAG0064A_L; MPN ADS1299IPAG

Connections:
+3V3: C117.2, C118.1, R102.2, R107.2, U101.48 (DVDD), U101.50 (DVDD); also elsewhere on the board
+5VA: C104.1, C105.2, C106.1, C107.2, C108.1, C109.2, C110.1, C111.2, C119.1, C120.1, C121.1, C122.1, U101.19 (AVDD), U101.21 (AVDD), U101.22 (AVDD), U101.54 (AVDD1), U101.56 (AVDD), U101.59 (AVDD); also elsewhere on the board
AFE1_CLKSEL: R102.1, U101.52 (CLKSEL)
AFE1_CS_N: R107.1, U101.39 (~CS); also elsewhere on the board
AFE1_DOUT: U101.43 (DOUT); also elsewhere on the board
AFE1_DRDY_N: U101.47 (~DRDY); also elsewhere on the board
AFE1_GPIO1: R103.1, U101.42 (GPIO1)
AFE1_GPIO2: R104.1, U101.44 (GPIO2)
AFE1_GPIO3: R105.1, U101.45 (GPIO3)
AFE1_GPIO4: R106.1, U101.46 (GPIO4)
AFE1_VCAP1: C101.1, U101.28 (VCAP1)
AFE1_VCAP2: C102.2, U101.30 (VCAP2)
AFE1_VCAP3: C112.2, C115.2, U101.55 (VCAP3)
AFE1_VCAP4: C116.2, U101.26 (VCAP4)
AFE1_VREFP: C113.1, C114.1, U101.24 (VREFP)
AFE_CLK: U101.37 (CLK); also elsewhere on the board
AFE_PWDN_N: U101.35 (~PWDN); also elsewhere on the board
AFE_RESET_MASTER_N: U101.36 (~RESET); also elsewhere on the board
AFE_START: U101.38 (START); also elsewhere on the board
BIAS_DRIVE: C103.1, R101.1, U101.62 (BIASIN), U101.63 (BIASOUT); also elsewhere on the board
BIAS_SUM: C103.2, R101.2, U101.61 (BIASINV); also elsewhere on the board
EEG_CH01_ADC: U101.16 (IN1P); also elsewhere on the board
EEG_CH02_ADC: U101.14 (IN2P); also elsewhere on the board
EEG_CH03_ADC: U101.12 (IN3P); also elsewhere on the board
EEG_CH04_ADC: U101.10 (IN4P); also elsewhere on the board
EEG_CH05_ADC: U101.8 (IN5P); also elsewhere on the board
EEG_CH06_ADC: U101.6 (IN6P); also elsewhere on the board
EEG_CH07_ADC: U101.4 (IN7P); also elsewhere on the board
EEG_CH08_ADC: U101.2 (IN8P); also elsewhere on the board
EEG_REF_ADC: U101.17 (SRB1); also elsewhere on the board
GND: C101.2, C102.1, C104.2, C105.1, C106.2, C107.1, C108.2, C109.1, C110.2, C111.1, C112.1, C113.2, C114.2, C115.1, C116.1, C117.1, C118.2, C119.2, C120.2, C121.2, C122.2, R103.2, R104.2, R105.2, R106.2, U101.20 (AVSS), U101.23 (AVSS), U101.25 (VREFN), U101.31 (RESV1), U101.32 (AVSS), U101.33 (DGND), U101.41 (DAISY_IN), U101.49 (DGND), U101.51 (DGND), U101.53 (AVSS1), U101.57 (AVSS), U101.58 (AVSS); also elsewhere on the board
SPI_MOSI: U101.34 (DIN); also elsewhere on the board
SPI_SCLK: U101.40 (SCLK); also elsewhere on the board

Notes on the sheet:
ADS1299 #1 / CH01-CH08
PassiveInputs.kicad_sch RC bank -> EEG_CH01_ADC ... EEG_CH08_ADC | shared SRB1 reference
ADC INPUTS / CONTROL
SUPPLIES / CONFIGURATION
VCAP SUPPORT
LOCAL ADC REFERENCE
ANALOG SUPPLY BYPASS / +5VA
DIGITAL BYPASS
PASSIVE COMMON-REFERENCE MODE
EEG_REF_ADC -> pin 17 / SRB1. Select MISC1.SRB1 in firmware; unused external INxN pins are NC. ADC VREFP is local conversion reference, not the REF electrode. See ReferenceBias.kicad_sch.
MASTER: CLKSEL pulled high; enable CLK_EN. Only U101 drives BIAS; R101 || C103 is feedback.
PASSIVE INPUT BANK
CH01: J601.1 -> R601 -> IN1P / pin 16 CH02: J601.2 -> R602 -> IN2P / pin 14 CH03: J601.3 -> R603 -> IN3P / pin 12 CH04: J601.4 -> R604 -> IN4P / pin 10 CH05: J601.5 -> R605 -> IN5P / pin 8 CH06: J601.6 -> R606 -> IN6P / pin 6 CH07: J601.7 -> R607 -> IN7P / pin 4 CH08: J601.8 -> R608 -> IN8P / pin 2

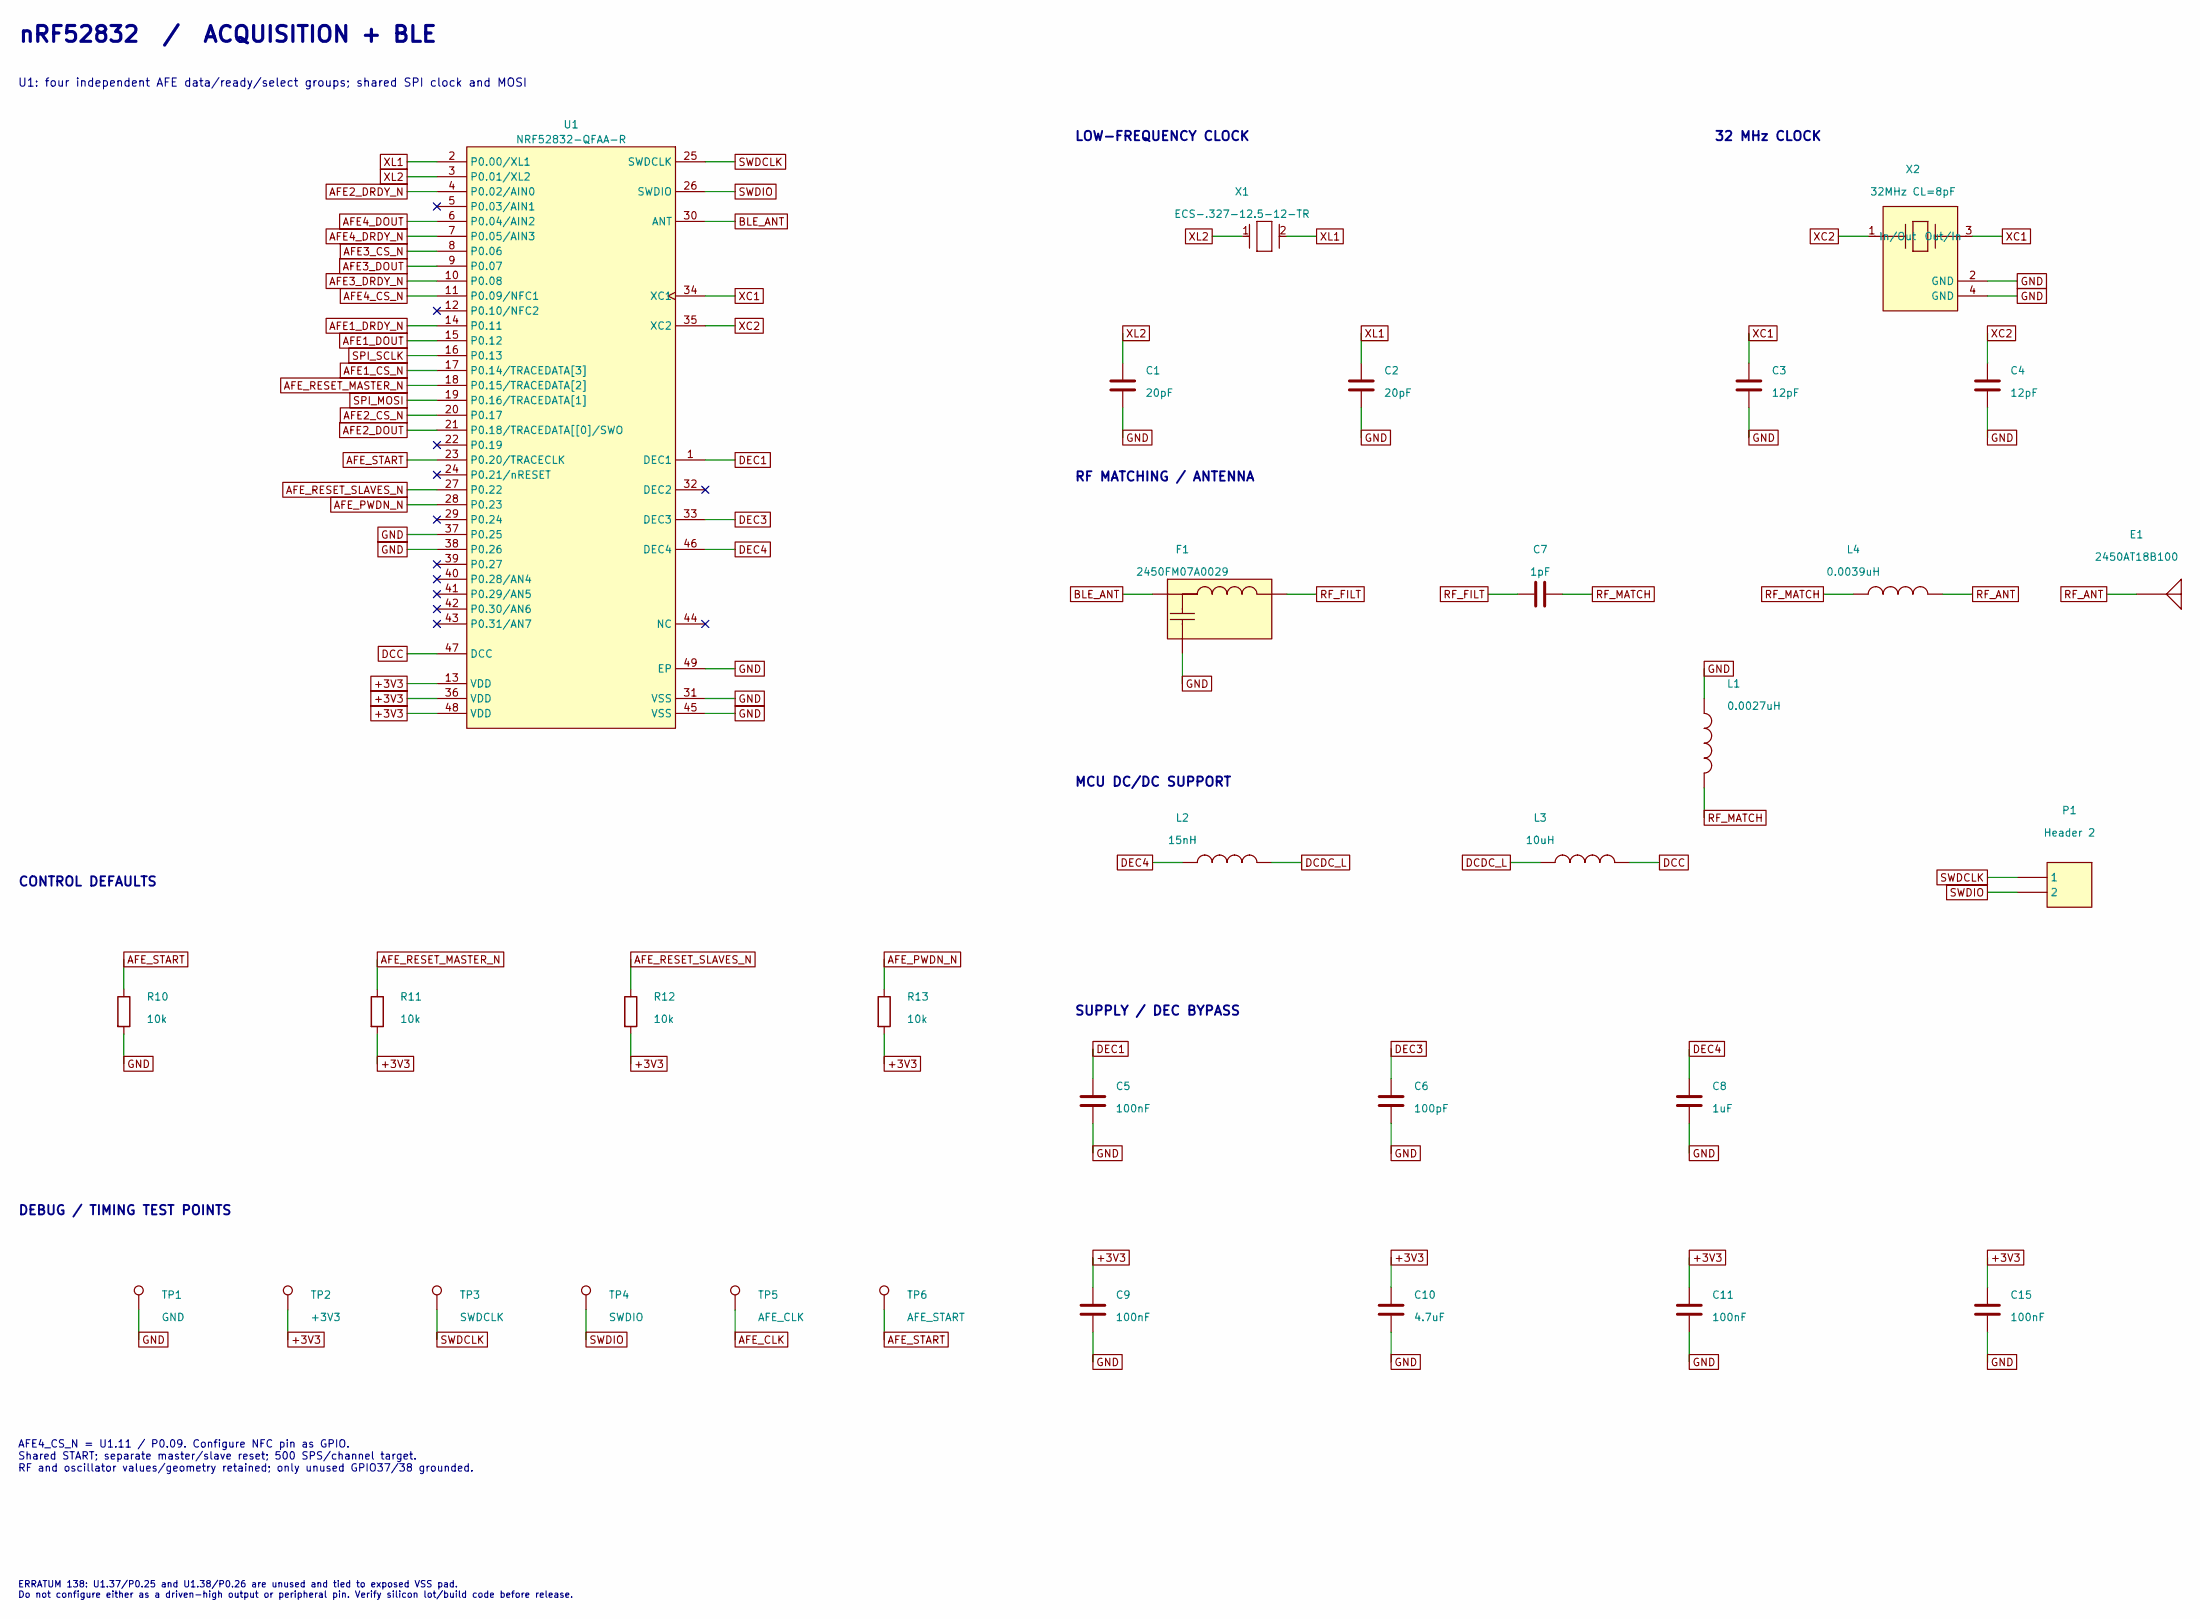
[picture p17: schematic MCU.kicad_sch, EEG32 passive | MCU]

Parts:
C1, C2: 20pF; C0402; MPN GJM1555C1H200FB01D
C3, C4: 12pF; C0402; MPN 04025U120FAT2A
C5, C9: 100nF; C0402; MPN MSAST105SB5104KFNA01
C6: 100pF; C0402; MPN CC0402FRNPO9BN101
C7: 1pF; C0402; MPN GCQ1555C1H1R0BB01D
C8: 1uF; C0603; MPN GRM188R61A105KA61D
C10: 4.7uF; C0402; MPN GRM155R60J475ME87D
C11, C15: 100nF; C0402; MPN GRM155R71C104KA88D
E1: 2450AT18B100; MPN 2450AT18B100E
F1: 2450FM07A0029; MPN 2450FM07A0029T
L1: 0.0027uH; L0402; MPN LQW15AN2N7G8ZD
L2: 15nH; L0402; MPN LQG15HS15NJ02D
L3: 10uH; L0603; MPN LQM18DN100M70L
L4: 0.0039uH; L0402; MPN CW100505-3N9J
P1: Header 2; HDR1X2; MPN NOT PURCHASED
R10, R11, R12, R13: 10k; R0402; MPN RC0402FR-0710KL
TP1: GND; TestPoint_Pad_D1.5mm; MPN NOT PURCHASED
TP2: +3V3; TestPoint_Pad_D1.5mm; MPN NOT PURCHASED
TP3: SWDCLK; TestPoint_Pad_D1.5mm; MPN NOT PURCHASED
TP4: SWDIO; TestPoint_Pad_D1.5mm; MPN NOT PURCHASED
TP5: AFE_CLK; TestPoint_Pad_D1.5mm; MPN NOT PURCHASED
TP6: AFE_START; TestPoint_Pad_D1.5mm; MPN NOT PURCHASED
U1: NRF52832-QFAA-R; NRF52832-QFAA-R7; MPN NRF52832-QFAA-R
X1: ECS-.327-12.5-12-TR; FP-ECX-12-MFG; MPN ECS-.327-12.5-12-TR
X2: 32MHz CL=8pF; FP-ECX-1637-MFG; MPN ECS-320-8-37CKM

Connections:
+3V3: C9.1, C10.1, C11.1, C15.1, R11.2, R12.2, R13.2, TP2.1, U1.13 (VDD), U1.36 (VDD), U1.48 (VDD); also elsewhere on the board
AFE1_CS_N: U1.17 (P0.14/TRACEDATA[3]); also elsewhere on the board
AFE1_DOUT: U1.15 (P0.12); also elsewhere on the board
AFE1_DRDY_N: U1.14 (P0.11); also elsewhere on the board
AFE2_CS_N: U1.20 (P0.17); also elsewhere on the board
AFE2_DOUT: U1.21 (P0.18/TRACEDATA[[0]/SWO); also elsewhere on the board
AFE2_DRDY_N: U1.4 (P0.02/AIN0); also elsewhere on the board
AFE3_CS_N: U1.8 (P0.06); also elsewhere on the board
AFE3_DOUT: U1.9 (P0.07); also elsewhere on the board
AFE3_DRDY_N: U1.10 (P0.08); also elsewhere on the board
AFE4_CS_N: U1.11 (P0.09/NFC1); also elsewhere on the board
AFE4_DOUT: U1.6 (P0.04/AIN2); also elsewhere on the board
AFE4_DRDY_N: U1.7 (P0.05/AIN3); also elsewhere on the board
AFE_CLK: TP5.1; also elsewhere on the board
AFE_PWDN_N: R13.1, U1.28 (P0.23); also elsewhere on the board
AFE_RESET_MASTER_N: R11.1, U1.18 (P0.15/TRACEDATA[2]); also elsewhere on the board
AFE_RESET_SLAVES_N: R12.1, U1.27 (P0.22); also elsewhere on the board
AFE_START: R10.1, TP6.1, U1.23 (P0.20/TRACECLK); also elsewhere on the board
BLE_ANT: F1.1, U1.30 (ANT)
DCC: L3.2, U1.47 (DCC)
DCDC_L: L2.2, L3.1
DEC1: C5.1, U1.1 (DEC1)
DEC3: C6.1, U1.33 (DEC3)
DEC4: C8.2, L2.1, U1.46 (DEC4)
GND: C1.1, C2.1, C3.1, C4.1, C5.2, C6.2, C8.1, C9.2, C10.2, C11.2, C15.2, F1.3, L1.1, R10.2, TP1.1, U1.31 (VSS), U1.37 (P0.25), U1.38 (P0.26), U1.45 (VSS), U1.49 (EP), X2.2 (GND), X2.4 (GND); also elsewhere on the board
RF_ANT: E1.1, L4.2
RF_FILT: C7.1, F1.2
RF_MATCH: C7.2, L1.2, L4.1
SPI_MOSI: U1.19 (P0.16/TRACEDATA[1]); also elsewhere on the board
SPI_SCLK: U1.16 (P0.13); also elsewhere on the board
SWDCLK: P1.1, TP3.1, U1.25 (SWDCLK)
SWDIO: P1.2, TP4.1, U1.26 (SWDIO)
XC1: C3.2, U1.34 (XC1), X2.3 (Out/In)
XC2: C4.2, U1.35 (XC2), X2.1 (In/Out)
XL1: C2.2, U1.2 (P0.00/XL1), X1.2 (Out/In)
XL2: C1.2, U1.3 (P0.01/XL2), X1.1 (In/Out)

Notes on the sheet:
nRF52832 / ACQUISITION + BLE
U1: four independent AFE data/ready/select groups; shared SPI clock and MOSI
LOW-FREQUENCY CLOCK
32 MHz CLOCK
RF MATCHING / ANTENNA
MCU DC/DC SUPPORT
SUPPLY / DEC BYPASS
CONTROL DEFAULTS
DEBUG / TIMING TEST POINTS
AFE4_CS_N = U1.11 / P0.09. Configure NFC pin as GPIO. Shared START; separate master/slave reset; 500 SPS/channel target. RF and oscillator values/geometry retained; only unused GPIO37/38 grounded.
ERRATUM 138: U1.37/P0.25 and U1.38/P0.26 are unused and tied to exposed VSS pad. Do not configure either as a driven-high output or peripheral pin. Verify silicon lot/build code before release.

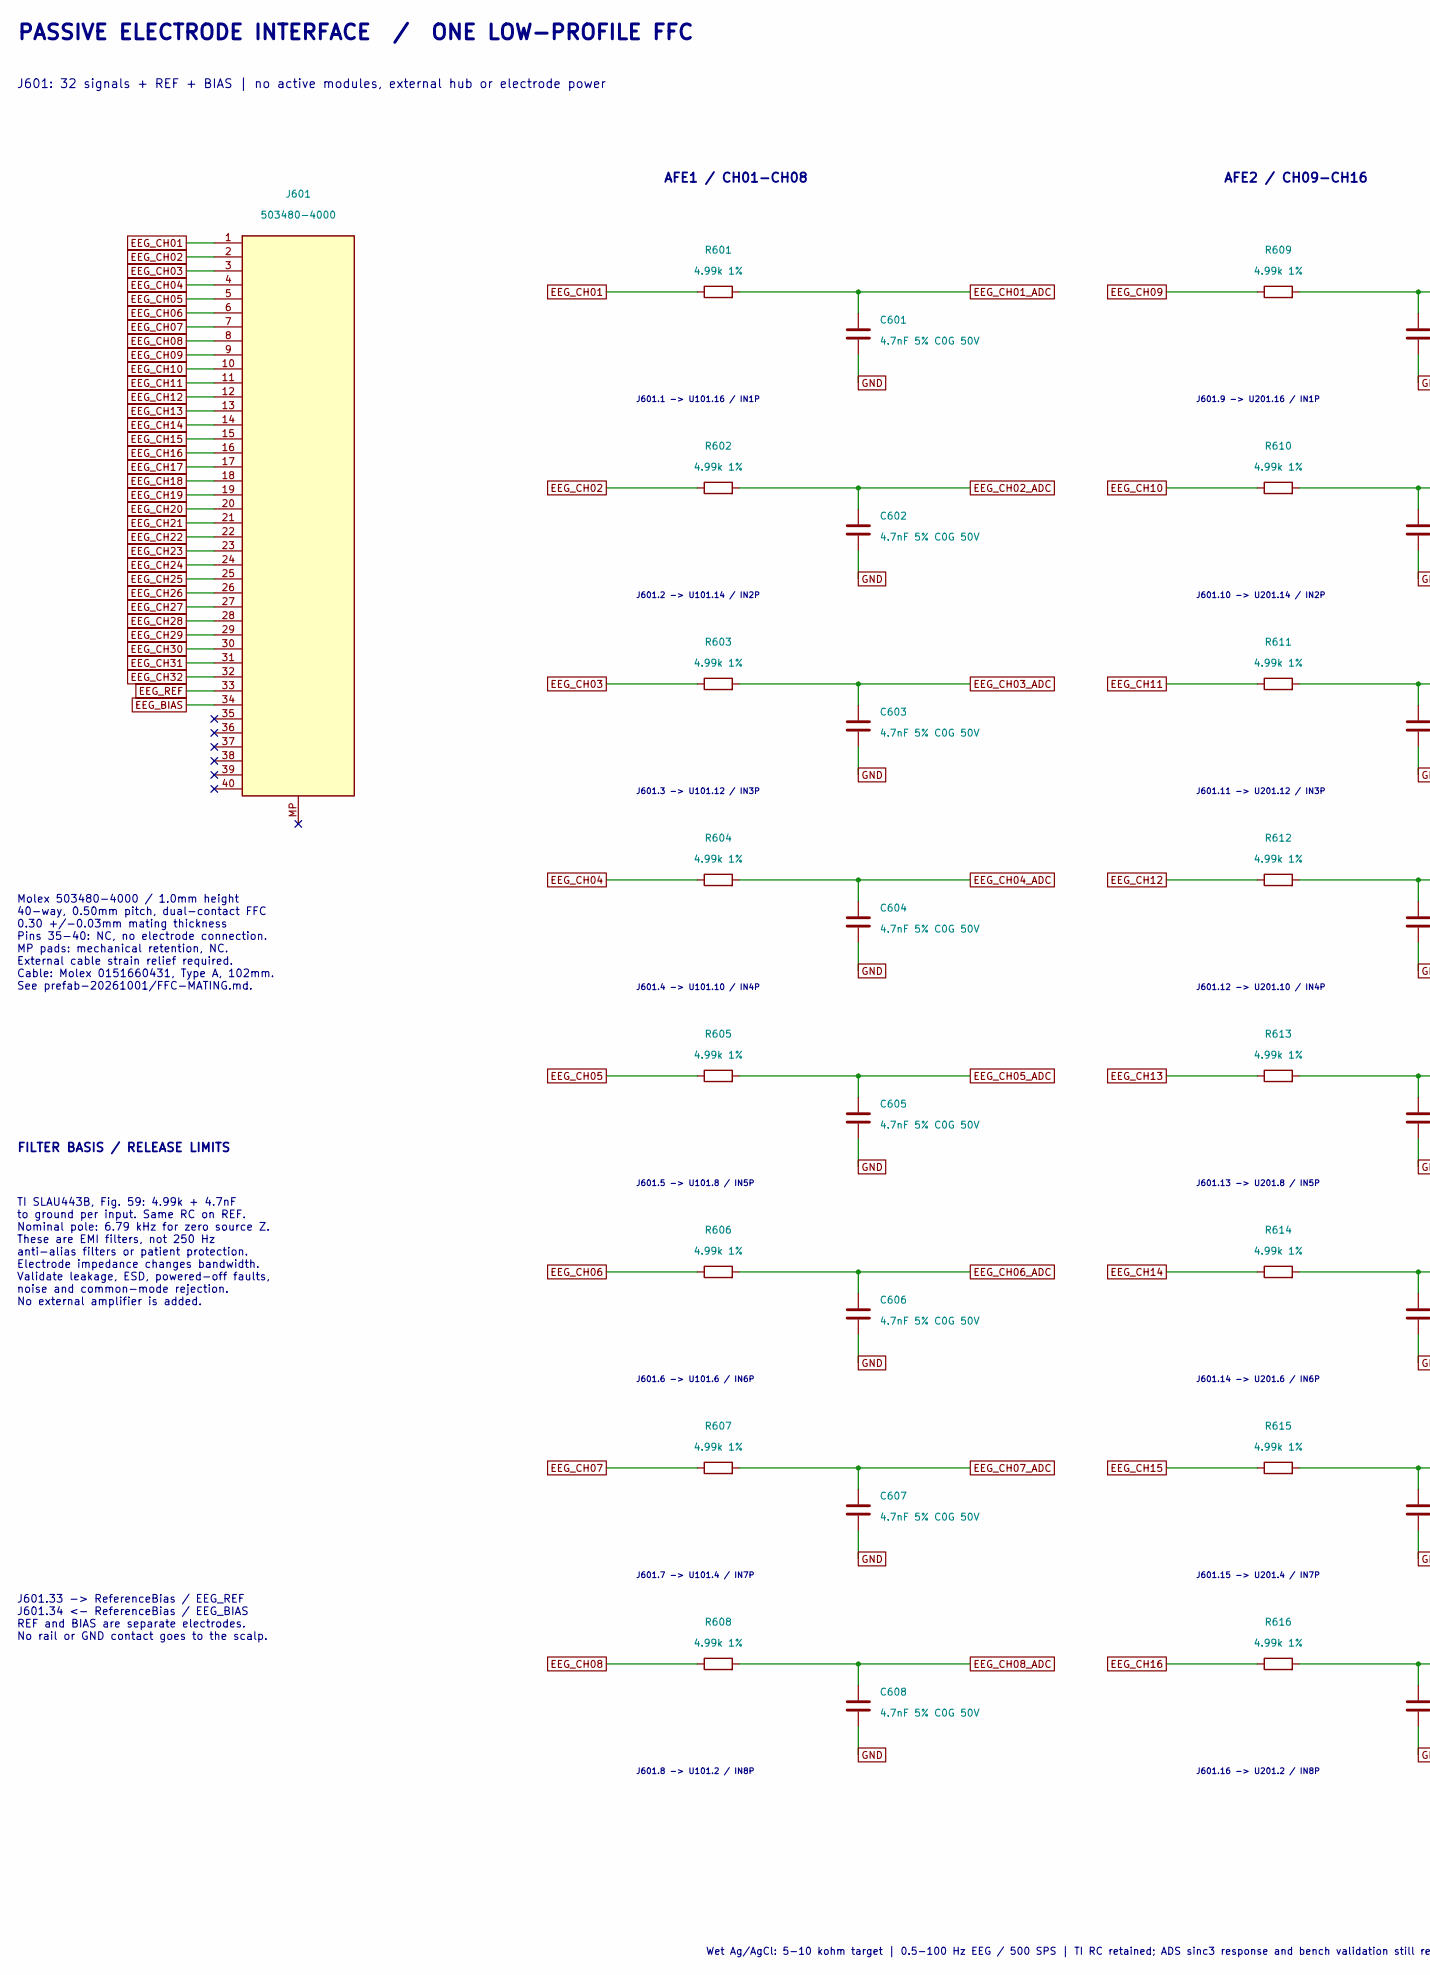
[picture p18: schematic PassiveInputs.kicad_sch, EEG32 passive | PassiveInputs, part in row 1, column 1]

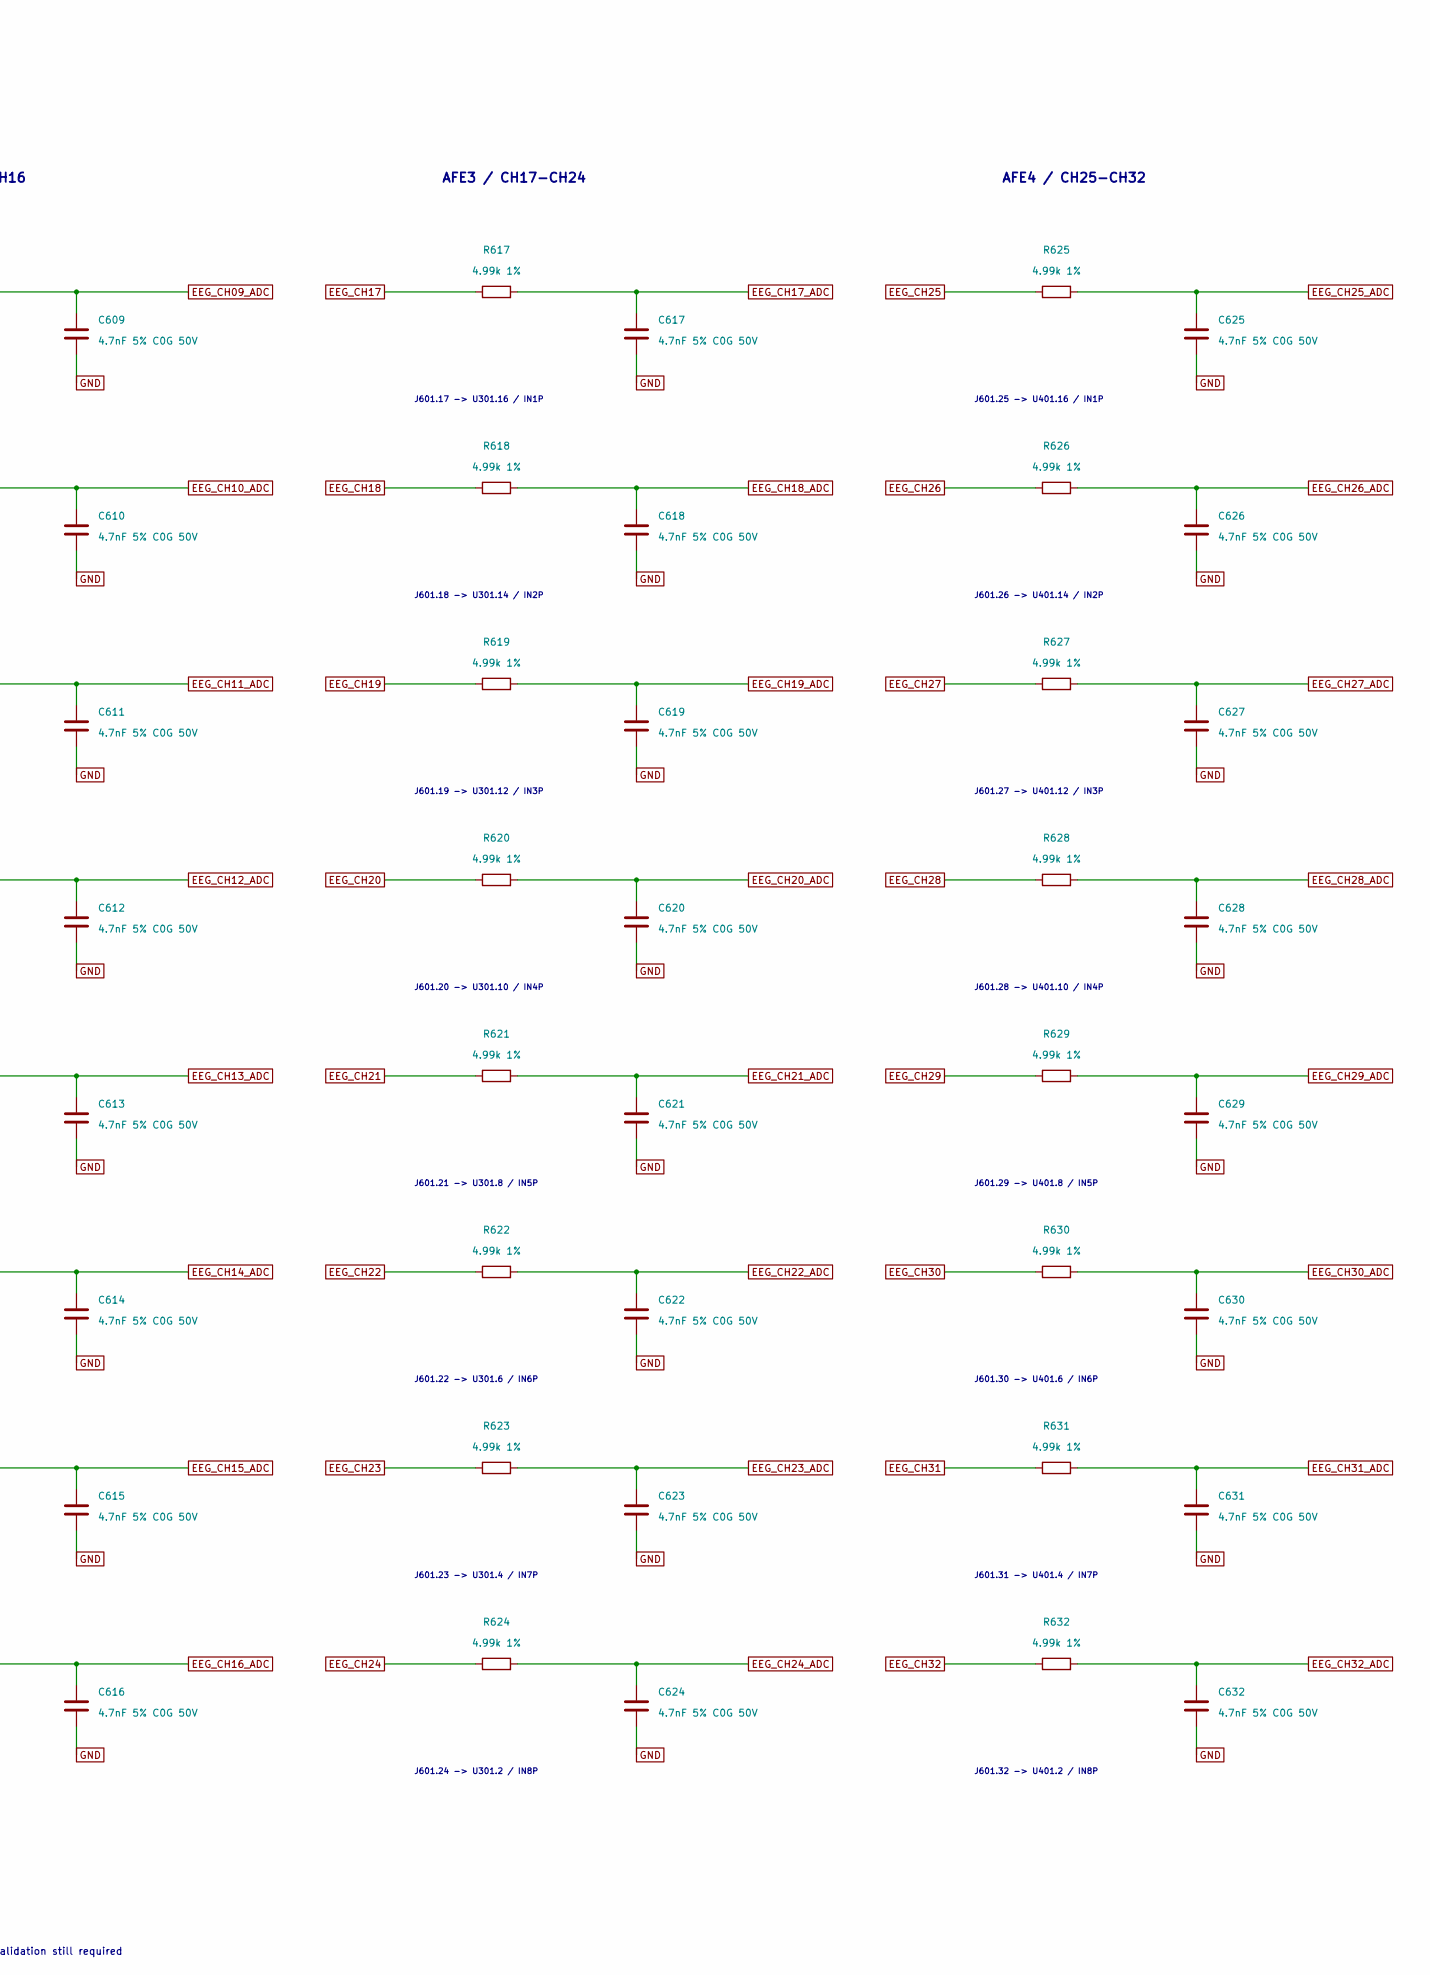
[picture p19: schematic PassiveInputs.kicad_sch, EEG32 passive | PassiveInputs, part in row 1, column 2]

Parts:
C601, C602, C603, C604, C605, C606, C607, C608, C609, C610, C611, C612, C613, C614, C615, C616, C617, C618, C619, C620, C621, C622, C623, C624, C625, C626, C627, C628, C629, C630, C631, C632: 4.7nF 5% C0G 50V; C0603; MPN GRM1885C1H472JA01D
J601: 503480-4000; Molex_503480-4000_1x40_P0.50mm_Horizontal; MPN 503480-4000
R601, R602, R603, R604, R605, R606, R607, R608, R609, R610, R611, R612, R613, R614, R615, R616, R617, R618, R619, R620, R621, R622, R623, R624, R625, R626, R627, R628, R629, R630, R631, R632: 4.99k 1%; R0402; MPN RC0402FR-074K99L

Connections:
EEG_BIAS: J601.34; also elsewhere on the board
EEG_CH01: J601.1, R601.1
EEG_CH01_ADC: C601.1, R601.2; also elsewhere on the board
EEG_CH02: J601.2, R602.1
EEG_CH02_ADC: C602.1, R602.2; also elsewhere on the board
EEG_CH03: J601.3, R603.1
EEG_CH03_ADC: C603.1, R603.2; also elsewhere on the board
EEG_CH04: J601.4, R604.1
EEG_CH04_ADC: C604.1, R604.2; also elsewhere on the board
EEG_CH05: J601.5, R605.1
EEG_CH05_ADC: C605.1, R605.2; also elsewhere on the board
EEG_CH06: J601.6, R606.1
EEG_CH06_ADC: C606.1, R606.2; also elsewhere on the board
EEG_CH07: J601.7, R607.1
EEG_CH07_ADC: C607.1, R607.2; also elsewhere on the board
EEG_CH08: J601.8, R608.1
EEG_CH08_ADC: C608.1, R608.2; also elsewhere on the board
EEG_CH09: J601.9, R609.1
EEG_CH09_ADC: C609.1, R609.2; also elsewhere on the board
EEG_CH10: J601.10, R610.1
EEG_CH10_ADC: C610.1, R610.2; also elsewhere on the board
EEG_CH11: J601.11, R611.1
EEG_CH11_ADC: C611.1, R611.2; also elsewhere on the board
EEG_CH12: J601.12, R612.1
EEG_CH12_ADC: C612.1, R612.2; also elsewhere on the board
EEG_CH13: J601.13, R613.1
EEG_CH13_ADC: C613.1, R613.2; also elsewhere on the board
EEG_CH14: J601.14, R614.1
EEG_CH14_ADC: C614.1, R614.2; also elsewhere on the board
EEG_CH15: J601.15, R615.1
EEG_CH15_ADC: C615.1, R615.2; also elsewhere on the board
EEG_CH16: J601.16, R616.1
EEG_CH16_ADC: C616.1, R616.2; also elsewhere on the board
EEG_CH17: J601.17, R617.1
EEG_CH17_ADC: C617.1, R617.2; also elsewhere on the board
EEG_CH18: J601.18, R618.1
EEG_CH18_ADC: C618.1, R618.2; also elsewhere on the board
EEG_CH19: J601.19, R619.1
EEG_CH19_ADC: C619.1, R619.2; also elsewhere on the board
EEG_CH20: J601.20, R620.1
EEG_CH20_ADC: C620.1, R620.2; also elsewhere on the board
EEG_CH21: J601.21, R621.1
EEG_CH21_ADC: C621.1, R621.2; also elsewhere on the board
EEG_CH22: J601.22, R622.1
EEG_CH22_ADC: C622.1, R622.2; also elsewhere on the board
EEG_CH23: J601.23, R623.1
EEG_CH23_ADC: C623.1, R623.2; also elsewhere on the board
EEG_CH24: J601.24, R624.1
EEG_CH24_ADC: C624.1, R624.2; also elsewhere on the board
EEG_CH25: J601.25, R625.1
EEG_CH25_ADC: C625.1, R625.2; also elsewhere on the board
EEG_CH26: J601.26, R626.1
EEG_CH26_ADC: C626.1, R626.2; also elsewhere on the board
EEG_CH27: J601.27, R627.1
EEG_CH27_ADC: C627.1, R627.2; also elsewhere on the board
EEG_CH28: J601.28, R628.1
EEG_CH28_ADC: C628.1, R628.2; also elsewhere on the board
EEG_CH29: J601.29, R629.1
EEG_CH29_ADC: C629.1, R629.2; also elsewhere on the board
EEG_CH30: J601.30, R630.1
EEG_CH30_ADC: C630.1, R630.2; also elsewhere on the board
EEG_CH31: J601.31, R631.1
EEG_CH31_ADC: C631.1, R631.2; also elsewhere on the board
EEG_CH32: J601.32, R632.1
EEG_CH32_ADC: C632.1, R632.2; also elsewhere on the board
EEG_REF: J601.33; also elsewhere on the board
GND: C601.2, C602.2, C603.2, C604.2, C605.2, C606.2, C607.2, C608.2, C609.2, C610.2, C611.2, C612.2, C613.2, C614.2, C615.2, C616.2, C617.2, C618.2, C619.2, C620.2, C621.2, C622.2, C623.2, C624.2, C625.2, C626.2, C627.2, C628.2, C629.2, C630.2, C631.2, C632.2; also elsewhere on the board

Notes on the sheet:
PASSIVE ELECTRODE INTERFACE / ONE LOW-PROFILE FFC
J601: 32 signals + REF + BIAS | no active modules, external hub or electrode power
Molex 503480-4000 / 1.0mm height 40-way, 0.50mm pitch, dual-contact FFC 0.30 +/-0.03mm mating thickness Pins 35-40: NC, no electrode connection. MP pads: mechanical retention, NC. External cable strain relief required. Cable: Molex 0151660431, Type A, 102mm. See prefab-20261001/FFC-MATING.md.
FILTER BASIS / RELEASE LIMITS
TI SLAU443B, Fig. 59: 4.99k + 4.7nF to ground per input. Same RC on REF. Nominal pole: 6.79 kHz for zero source Z. These are EMI filters, not 250 Hz anti-alias filters or patient protection. Electrode impedance changes bandwidth. Validate leakage, ESD, powered-off faults, noise and common-mode reje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
J601.33 -> ReferenceBias / EEG_REF J601.34 <- ReferenceBias / EEG_BIAS REF and BIAS are separate electrodes. No rail or GND contact goes to the scalp.
AFE1 / CH01-CH08
J601.1 -> U101.16 / IN1P
J601.2 -> U101.14 / IN2P
J601.3 -> U101.12 / IN3P
J601.4 -> U101.10 / IN4P
J601.5 -> U101.8 / IN5P
J601.6 -> U101.6 / IN6P
J601.7 -> U101.4 / IN7P
J601.8 -> U101.2 / IN8P
AFE2 / CH09-CH16
J601.9 -> U201.16 / IN1P
J601.10 -> U201.14 / IN2P
J601.11 -> U201.12 / IN3P
J601.12 -> U201.10 / IN4P
J601.13 -> U201.8 / IN5P
J601.14 -> U201.6 / IN6P
J601.15 -> U201.4 / IN7P
J601.16 -> U201.2 / IN8P
AFE3 / CH17-CH24
J601.17 -> U301.16 / IN1P
J601.18 -> U301.14 / IN2P
J601.19 -> U301.12 / IN3P
J601.20 -> U301.10 / IN4P
J601.21 -> U301.8 / IN5P
J601.22 -> U301.6 / IN6P
J601.23 -> U301.4 / IN7P
J601.24 -> U301.2 / IN8P
AFE4 / CH25-CH32
J601.25 -> U401.16 / IN1P
J601.26 -> U401.14 / IN2P
J601.27 -> U401.12 / IN3P
J601.28 -> U401.10 / IN4P
J601.29 -> U401.8 / IN5P
J601.30 -> U401.6 / IN6P
J601.31 -> U401.4 / IN7P
J601.32 -> U401.2 / IN8P
Wet Ag/AgCl: 5-10 kohm target | 0.5-100 Hz EEG / 500 SPS | TI RC retained; ADS sinc3 response and bench validation still required
