Iwetter/EEG32/EEG32.kicad_pcb

## KiCad design EEG32.kicad_pcb (continued)

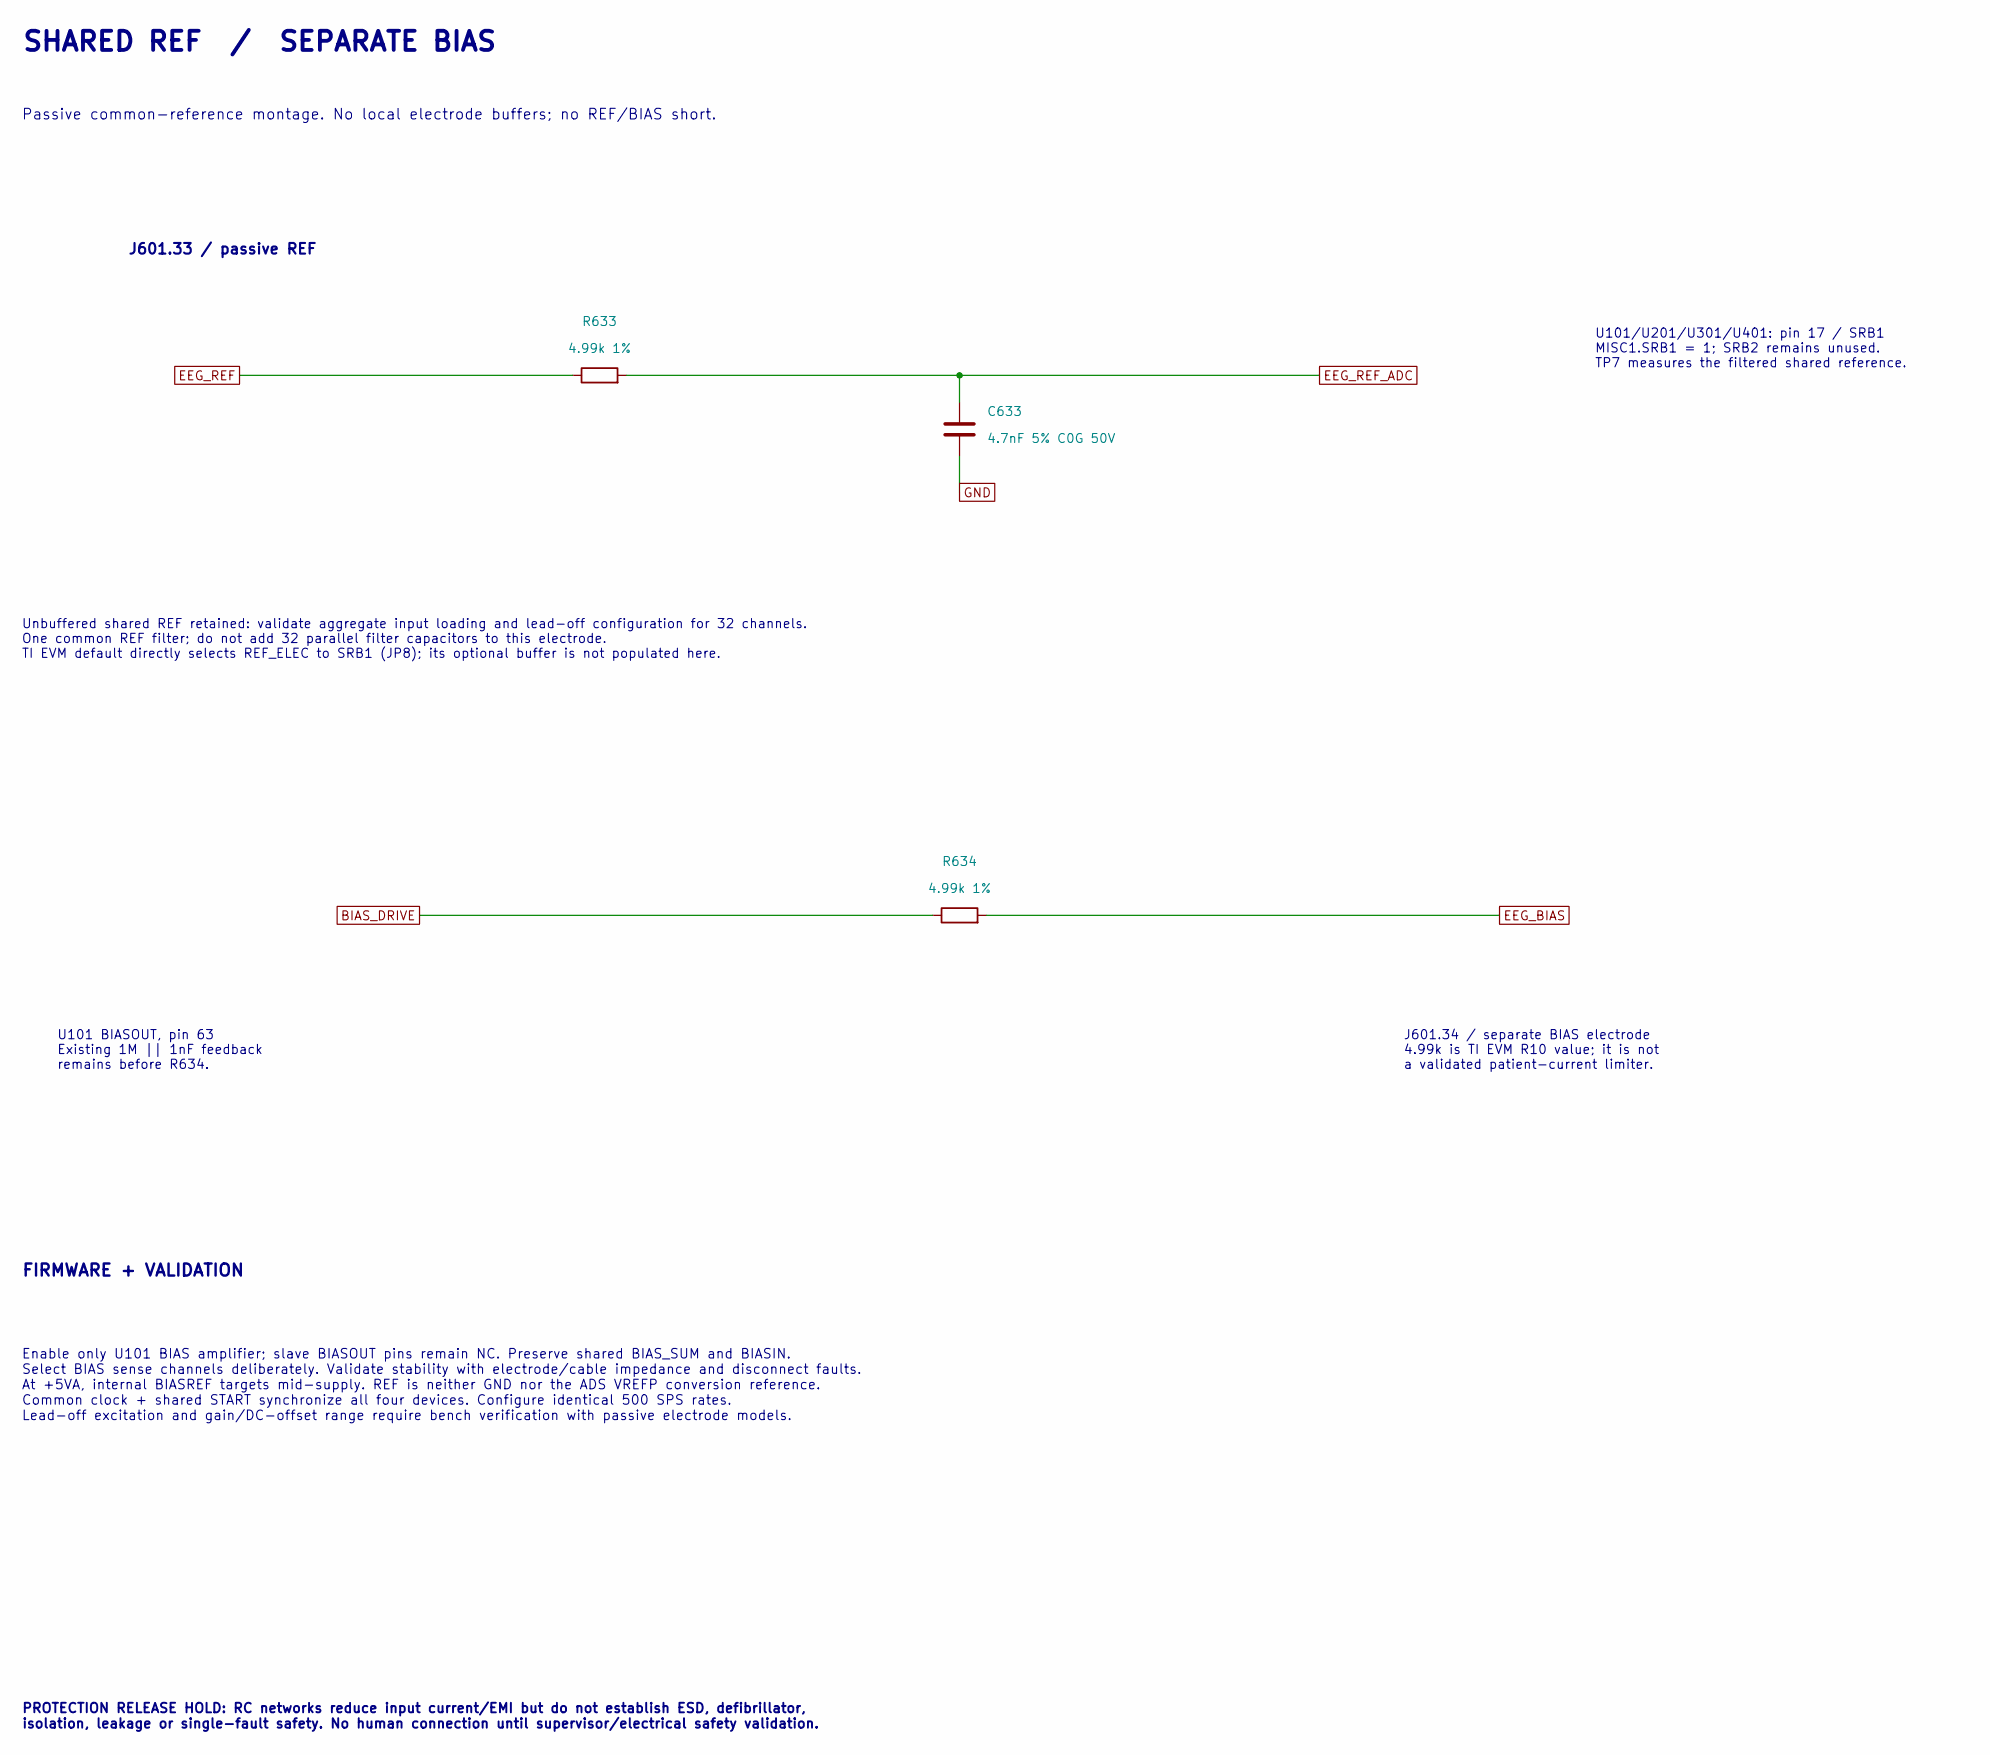
[picture p20: schematic ReferenceBias.kicad_sch, EEG32 passive | ReferenceBias]

Parts:
C633: 4.7nF 5% C0G 50V; C0603; MPN GRM1885C1H472JA01D
R633, R634: 4.99k 1%; R0402; MPN RC0402FR-074K99L

Connections:
BIAS_DRIVE: R634.1; also elsewhere on the board
EEG_BIAS: R634.2; also elsewhere on the board
EEG_REF: R633.1; also elsewhere on the board
EEG_REF_ADC: C633.1, R633.2; also elsewhere on the board
GND: C633.2; also elsewhere on the board

Notes on the sheet:
SHARED REF / SEPARATE BIAS
Passive common-reference montage. No local electrode buffers; no REF/BIAS short.
J601.33 / passive REF
U101/U201/U301/U401: pin 17 / SRB1 MISC1.SRB1 = 1; SRB2 remains unused. TP7 measures the filtered shared reference.
Unbuffered shared REF retained: validate aggregate input loading and lead-off configuration for 32 channels. One common REF filter; do not add 32 parallel filter capacitors to this electrode. TI EVM default directly selects REF_ELEC to SRB1 (JP8); its optional buffer is not populated here.
U101 BIASOUT, pin 63 Existing 1M || 1nF feedback remains before R634.
J601.34 / separate BIAS electrode 4.99k is TI EVM R10 value; it is not a validated patient-current limiter.
FIRMWARE + VALIDATION
Enable only U101 BIAS amplifier; slave BIASOUT pins remain NC. Preserve shared BIAS_SUM and BIASIN. Select BIAS sense channels deliberately. Validate stability with electrode/cable impedance and disconnect faults. At +5VA, internal BIASREF targets mid-supply. REF is neither GND nor the ADS VREFP co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
PROTECTION RELEASE HOLD: RC networks reduce input current/EMI but do not establish ESD, defibrillator, isolation, leakage or single-fault safety. No human connection until supervisor/electrical safety validation.

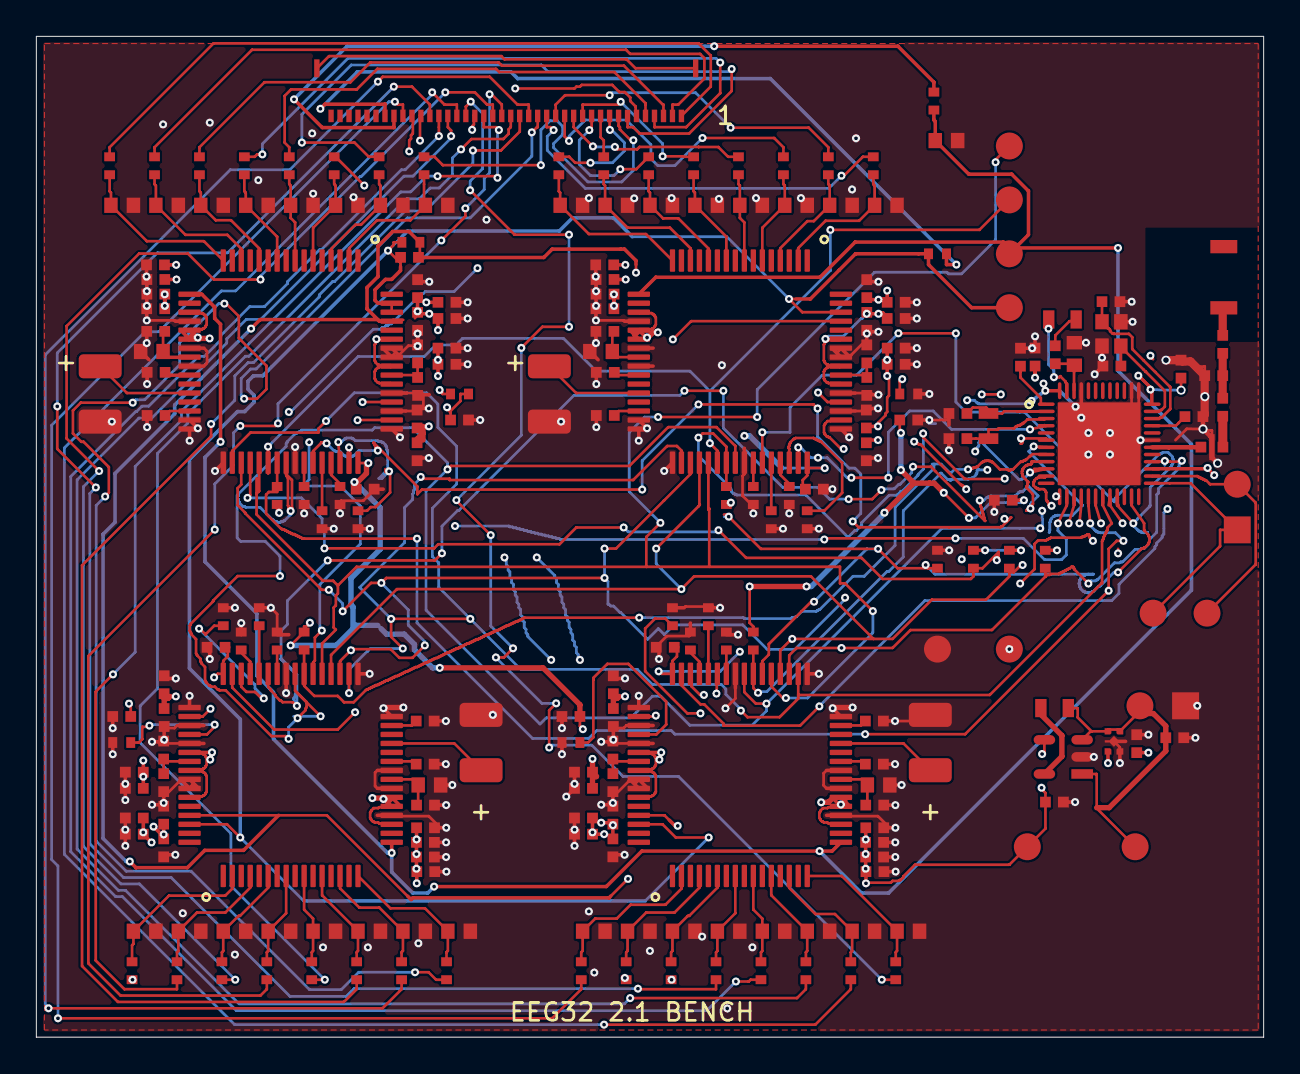
[picture p21: board EEG32.kicad_pcb from above]

Board: 4 copper layers, 68.3 x 55.7 mm, 225 parts (1 on the bottom side), 148 nets.
